Mister-M-alt/FPGA-gPTP/README.md

<!-- SPDX-License-Identifier: CERN-OHL-W-2.0 -->
# FPGA-gPTP

Fabric-native time synchronization for Milan FPGA systems.

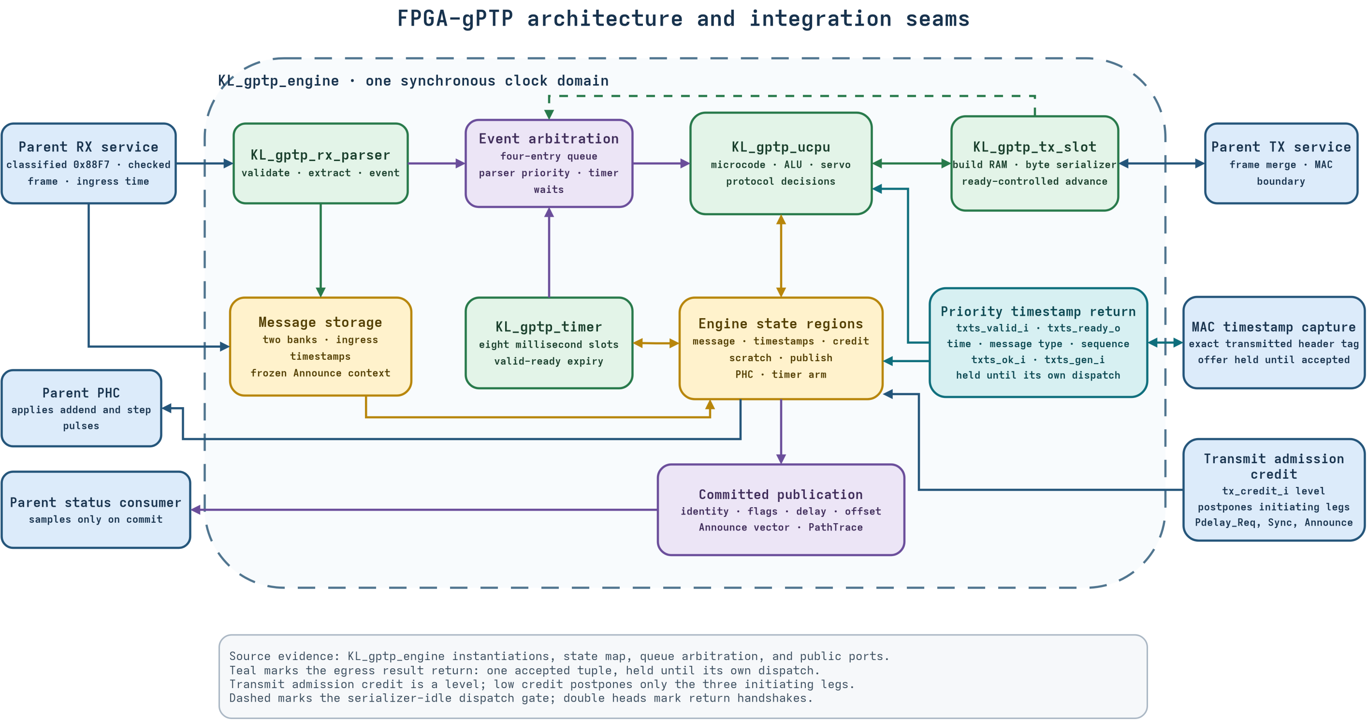
[picture p1: docs/diagrams/gptp_architecture.png]
FPGA-gPTP architecture


The engine keeps protocol work inside programmable logic.

## Choose your view

| Reader | Start here | Main questions |
|---|---|---|
| Manager | [Manager guide](docs/MANAGER.md) | Value, readiness, evidence, risks |
| System integrator | [Integration guide](docs/INTEGRATION.md) | Ports, clocks, resets, ownership |
| HDL contributor | [HDL developer guide](docs/HDL_DEVELOPER.md) | Modules, state, timing, invariants |
| Test developer | [Test developer guide](docs/TEST_DEVELOPER.md) | Python, C, C++, suites, failures |

## Current shape

- Parent `GPTP_PLANE_EN_P` [defaults on](https://github.com/kebag-logic/milan-fpga/blob/ac2c5e77bba1c0ae20ce2f69f711a1d17ead94a5/hdl/milan/milan_datapath.sv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).
- [Fabric gPTP](https://github.com/kebag-logic/milan-fpga/blob/ac2c5e77bba1c0ae20ce2f69f711a1d17ead94a5/docs/design/GPTP_PLANE.md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) owns product time synchronization.
- The disabled mode supports [verification-only comparison builds only](https://github.com/kebag-logic/milan-fpga/blob/ac2c5e77bba1c0ae20ce2f69f711a1d17ead94a5/docs/design/GPTP_PLANE.md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).
- One synchronous clock domain carries all processing.
- RX consumes validated, preclassified gPTP frames.
- TX honors downstream byte-level backpressure.
- Microcode owns protocol decisions and servo arithmetic.
- RTL owns parsing, queues, timers, and serialization.
- Egress timestamp results arrive on accepted beats.
- Admission credit postpones only initiating transmissions.
- Publication outputs expose committed protocol state.

Parent evidence is pinned at `ac2c5e77`.

The [integration guide](docs/INTEGRATION.md#option-off-behavior) details option-off behavior.

## Verify quickly

```sh
make
make docs
make diagrams-check
```

Each command returns nonzero after failures.

Detailed commands appear in the [test guide](docs/TEST_DEVELOPER.md).

## Known risks

- [Issue #58](https://github.com/Mister-M-alt/FPGA-gPTP/issues/58) remains open: asymmetry, calibration, and live tuning.
- [Parent #117](https://github.com/kebag-logic/milan-fpga/issues/117) still owes physical acceptance against the reference peer.
- [Parent #64](https://github.com/kebag-logic/milan-fpga/issues/64) and [#488](https://github.com/kebag-logic/milan-fpga/issues/488) still owe physical timestamp calibration.

The [manager guide](docs/MANAGER.md#open-risks) separates donor and product gaps.

No certification claim is made.

## Documentation

- [Documentation map](docs/README.md)
- [Source evidence](docs/SOURCE_EVIDENCE.md)
- [Architecture diagram source](docs/diagrams/gptp_architecture.drawio)
- [Diagram generation](docs/diagrams/README.md)
- [Historical records](docs/history/v1/README.md)

Current guides describe the present implementation.

Historical pages preserve dated engineering evidence.
