Mister-M-alt/FPGA-gPTP/docs/HDL_DEVELOPER.md

<!-- SPDX-License-Identifier: CERN-OHL-W-2.0 -->
# HDL developer guide

This guide explains structure, timing, and invariants.

## Summary

- Five RTL modules share one clock under `KL_gptp_engine`.
- Microcode decides protocol policy; RTL moves bytes and time.
- The microCPU reaches engine state through seven address regions.
- Scratch survives warm reset; validity bits do not.
- Sample on `pub_commit_o`; staging writes change outputs first.
- Synthesis figures here are dated measurements.

Terms are defined in the [glossary](GLOSSARY.md).

FPGA-gPTP architecture

The editable source remains [available](diagrams/gptp_architecture.drawio).

## Module map

| Module | Responsibility |
|---|---|
| `KL_gptp_engine` | Integration, queues, state, arbitration |
| `KL_gptp_rx_parser` | Byte parsing and message banking |
| `KL_gptp_ucpu` | Microcode execution and arithmetic |
| `KL_gptp_tx_slot` | Frame construction and serialization |
| `KL_gptp_timer` | Eight millisecond deadline slots |
| `gptp_ucpu_pkg` | Opcodes, constants, event identifiers |

All modules use one clock domain.

## Receive path

The parser accepts one byte each valid cycle.

It validates headers before dispatching events.

Follow_Up TLVs are walked up to messageLength.

Unknown TLVs are skipped by their length.

The first information TLV supplies word 11.

A malformed chain still refuses the Follow_Up.

A receive error on any byte refuses its frame.

Accepted data enters ping-pong message banks.

Ingress timestamps follow the same bank selection.

Announce uses one frozen context.

Chasing Announces become counted drops.

Other event types may continue.

### Receive timing

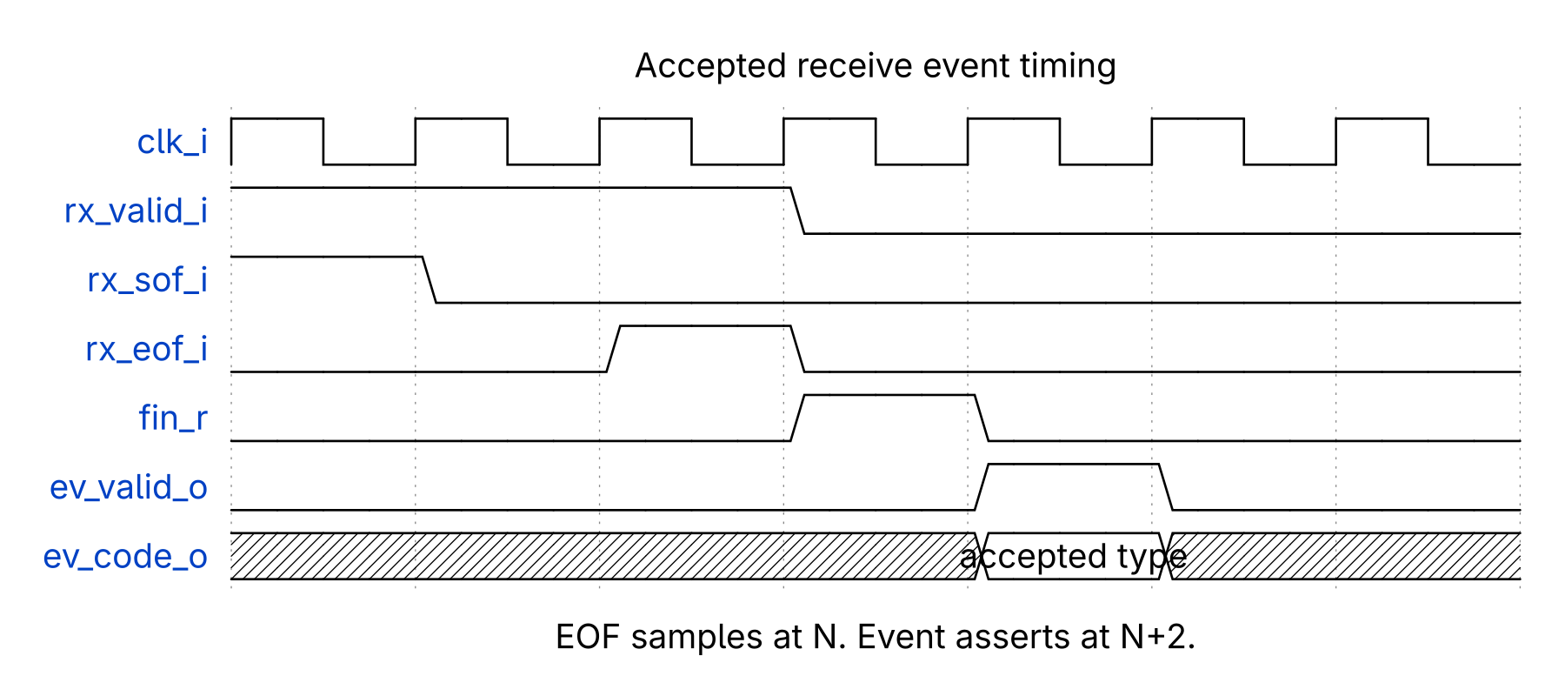
[picture p2: docs/diagrams/wavedrom/rx_accept.png]
Accepted receive event timing


EOF stores the final parser decision.

Finalization occupies the next cycle.

The accepted event follows finalization.

[WaveDrom source](diagrams/wavedrom/rx_accept.json) defines this timing.

## Event arbitration

- Four entries buffer parser and timer events.
- Parser events win simultaneous queue pushes.
- Timer expiry waits using valid-ready flow control.
- Timestamp results use a priority side path.
- Dispatch waits until serialization becomes idle.
- Later requests wait behind response ownership.

Never bypass ownership without preserving context.

## Egress result ownership

One result is accepted per valid-ready beat.

Its value, tag, outcome and generation latch together.

Readiness falls until that result dispatches.

A later offer therefore waits at its producer.

Backpressure can never replace an earlier result.

The dispatched word carries outcome and generation.

Both ride above the masked claim comparison.

## Retained pairing context

A peer answer can precede our own transmit time.

The completed pair then waits for that time.

Its identity and measurements stay in scratch.

A later response cannot rewrite the waiting pair.

Responder bookkeeping still counts every matching response.

Only the waiting pair's own arrival releases it.

Reset-backed validity guards both retained pairing cells.

A measured zero remains a valid time.

## State regions

The microCPU uses `st_addr_o[19:16]` for selection.

| Region | Access | Contents |
|---:|---|---|
| 0 | Read-only | Ping-pong message banks |
| 1 | Read-only | Ingress time, egress time, credit |
| 2 | Read-write | Sixty-four protocol scratch words |
| 3 | Read-write | Publication staging bank; word 15 reads thisClock |
| 4 | Read-write | PHC controls and policy completion qualifier |
| 5 | Write-only | Timer arming interface |
| 6 | Read-only | Follow_Up information TLV values (#100) |

Scratch storage survives warm resets.

Resettable claim-valid bits do not survive.

Pairing validity bits do not survive either.

Nor do the three best-record validity bits.

An unwritten best cell reads as the worst possible vector.

The PHC slew qualifier also resets independently.

Microcode writes its remaining completion pairs through PHC word 2.

Nonzero decisions immediately assert `phc_slew_active_o`.

A zero decision clears it with the next rate write.

PHC word 3 retires an active correction during mastership.

Publication flags also control qualification through an RTL-owned hook.

Region 3, word 2 writes trigger this hook.

Bit 2 means asCapable; bit 3 means sync-ok.

Mastership sets bit 3 beside bit 1.

Either cleared bit reloads two completion pairs while active.

The hook preserves the active level and applied rate.

While inactive, these writes must leave qualification unarmed.

A falling bit 2 also expires timer slot 2 now.

That slot runs the Announce receipt leg.

Preserve this coupling when changing either region or flag.

Microcode bit 0 means only that a peer is elected.

The output also sets bit 0 for a grandmaster-capable thisClock.

ROM word [`ROM_CID_HI_C`](INTEGRATION.md#protocol-constants), bit [`ROM_GMCAP_BIT_C`](INTEGRATION.md#protocol-constants), marks that capability.

Microcode reads of word 2 return the unmodified bits.

## MicroCPU shape

- ROM contains [`DEPTH`](INTEGRATION.md#protocol-constants) forty-eight-bit words.
- Its last two words hold thisClock as data.
- Bit `ROM_GMCAP_BIT_C` of word `ROM_CID_HI_C` marks grandmaster capability.
- Register storage contains sixteen sixty-four-bit words.
- Integer logic supports common sixty-four-bit operations.
- Shifts run serially.
- Signed multiplication uses inferred DSP resources.
- Unsigned division runs serially.
- Dispatch preloads event and timestamp registers.
- Multi-cycle operations hold execution safely.

Protocol rates tolerate serial arithmetic.

## Transmit timing

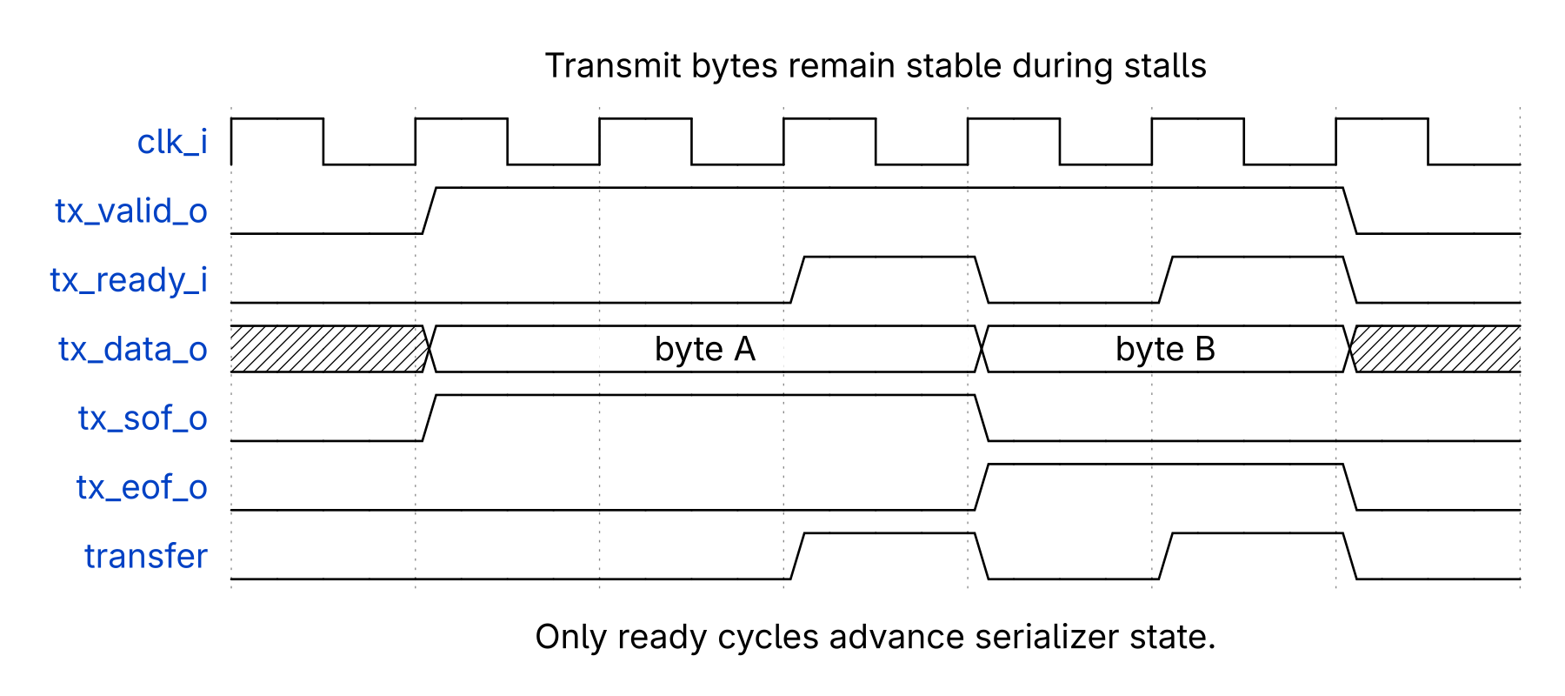
[picture p3: docs/diagrams/wavedrom/tx_backpressure.png]
Transmit backpressure timing


Valid remains asserted during stalls.

Data and markers remain stable during stalls.

State advances only after ready acceptance.

A disabled port withdraws a frame before its first acceptance.

[WaveDrom source](diagrams/wavedrom/tx_backpressure.json) defines this timing.

## Microcode receipt state

Values here come from the [protocol constants](INTEGRATION.md#protocol-constants).

Timer slot 4 is the [`SYNC_RTO_MS_C`](INTEGRATION.md#protocol-constants) Sync receipt watch.

Every usable Sync pair restarts it, in either role.

Adopting a new grandmaster starts it as well.

BECOME stops neither the Sync nor the Follow_Up watch.

Every expiry marks the port aged in scratch word 46.

It then ages an elected peer through BECGATE.

That needs the peer's grandmaster priority1 below 255.

Otherwise the expiry clears sync-ok, except in the master role.

The mark is `SRTO_PASSED_C`, a priority threshold.

It compares priority1 and the top three clockClass bits.

Its lowest bit is sync-ok's.

The presence bit times the mark is the leg's threshold.

An unaged expiry clears that threshold from the flags.

`MASK` does that: rd and not rb.

So a master, with threshold zero, keeps sync-ok.

The leg then ends in PDPAIR's flags write, `PUBFLAGS`.

An aged port ages each Announce below that threshold.

That is a grandmaster priority1 below 255, so gmPresent.

BECGATE then keeps or makes this plane master.

Other Announces compete as usual.

A usable pair or an asCapable rise clears that mark.

A master's usable pair only restarts the watch.

Scratch word 45 holds the pending Sync's source.

Scratch word 6 stays the master's Sync sequence.

Each Pdelay beat judges the previous request first.

An uncompleted interval adds one lost response.

Consecutive loss [`LOST_CLEARS_AT_C`](INTEGRATION.md#protocol-constants) clears asCapable.

PDPAIR first compares t4 less t1 with [`PD_LATE_NS_C`](INTEGRATION.md#protocol-constants).

A later pair ends there, with `S_PDGOT` still clear.

So it counts as lost, and moves nothing (#100).

Scratch word 39 adds each matching response's armed sequence.

A second response therefore leaves no pairable value.

Its exchange counts as lost at the next beat.

## Announce receipt watch

Timer slot 2 is the announce receipt watch.

The engine mirrors it: armed, and its deadline.

The timer only raises the alarm, never earlier.

An Announce handler's nonzero arm is rescaled (#100).

It becomes `ANN_RTO_MS_C` times 2^logMessageInterval.

It counts from that Announce's last octet.

Every other arm keeps its delta from the arm.

A queued expiry whose watch is not due is dropped.

An Announce arriving at or after the deadline waits.

The expiry dispatches ahead of it, from the head.

Each dispatched expiry consumes its watch.

Without that, a master's expiry would wedge dispatch.

An Announce before the deadline always precedes its expiry.

Its event follows its last octet by two clocks.

An expiry needs four clocks after the tick.

## Follow_Up TLV values

BECOME's PHC word-3 write marks each new mastership.

It increments the sixteen-bit gmTimeBaseIndicator.

That counter has no warm-reset assignment.

It also captures the frequency change, through one multiply.

That change is the kept trim less word 3's estimate.

An active slew applies word 3: the change is zero.

Before any rate write since reset, it is zero.

Publish word 4 writes keep the offset's upper half.

Region 6 serves gmTimeBaseIndicator, lastGmPhaseChange as ScaledNs.

It also serves scaledLastGmFreqChange, scaled by 2^41.

## Port enable

`port_en_r` registers `port_enabled_i` once.

Every port gate reads that registered level.

Region 1, word 2 then reads no credit.

`cancel_i` withdraws a frame whose first byte waits.

A SEND issued while disabled is withdrawn the same way.

The serializer masks valid in that same cycle.

A started frame runs on until its last byte.

Both claim-valid bits clear on every disabled cycle.

That write wins over microcode in the same cycle.

`port_ref_r` makes the first sample after release the reference.

Only a later change of level is an edge.

Each edge raises the slot 6 NOTEN event.

NOTEN dispatches ahead of the result and the queue.

It does not wait for an idle serializer.

Its leg must therefore never build or SEND.

A rise also queues a slot 0 beat.

That beat waits behind parser and timer events.

Slot 6 is the NOTEN leg, not a timer.

NOTEN clears the cease, countdown, streak and ladder.

It zeroes `S_RSPSEQ`, so no Follow_Up pairs.

It sets `S_PDGOT`, so the next beat counts no loss.

`S_PDGOT` also refuses a new response arm.

A pair frozen for its t1 finds no claim.

Its tail clears the interval and drops asCapable.

The cease entry now ends in that tail.

## Publication invariant

Microcode stages publication values first.

`OP_COMMIT` marks the staged tuple complete.

Staging writes reach the `pub_*_o` outputs at once.

Consumers sample only during `pub_commit_o`.

Inactive path entries must remain zero.

Reset loads thisClock and the path {thisClock}.

The engine reads thisClock from the image at configuration.

Publication word 15 serves that value to microcode.

The engine commits the reset state on its first edge.

No handler can run before that commit.

Region 3, word 7 stages a taken Announce's path.

It copies a present path from its received head.

That write appends thisClock, even to an empty path.

The appended entry uses the same image words.

Eight received entries leave it no slot.

Without a path trace TLV, the write changes nothing.

Message word 12 bit 63 marks that TLV present.

Microcode's loop test reads only bits 39 to 8.

## Out-of-context measurement

`make ooc` synthesizes both tops out of context.

Each script first reads `syn/ooc/ooc_clock.xdc`.

That file defines the 10 ns `clk_i` clock.

Synthesis therefore optimizes against that period.

`syn/ooc/check_ooc_clock.py` fails runs that break this order.

It checks both scripts before Vivado starts.

Afterwards it checks each log and timing report.

The log must parse this repository's XDC inside synthesis.

Neither log may carry a critical warning.

Each timing report must show `clk` at 10 ns.

Its `report_clocks` section must bind `clk` to `clk_i`.

No register may lack a clock.

Measured at main `5dce647a` on 2026-10-11:

| Top | Flow | LUTs | Registers | BRAM tiles | DSPs | WNS |
|---|---|---:|---:|---:|---:|---:|
| `KL_gptp_engine` | Constrained | 4,852 | 3,652 | 1.5 | 4 | +1.773 ns |
| `KL_gptp_engine` | Unconstrained | 4,853 | 3,652 | 1.5 | 4 | +1.773 ns |
| `KL_gptp_ucpu` | Constrained | 1,643 | 733 | 1.5 | 4 | +1.941 ns |
| `KL_gptp_ucpu` | Unconstrained | 1,643 | 733 | 1.5 | 4 | +1.941 ns |

Both flows used Vivado 2026.1 and `xc7a100tfgg484-2`.

Both used `-mode out_of_context` and the default directive.

Constrained runs read the clock before `synth_design`.

Unconstrained runs created it after `synth_design`.

Unconstrained slack is only a post-synthesis report.

This repository's `syn/ooc` figures before #70 were unconstrained.

No placement or routing runs here.

## Change checklist

- Preserve single-clock assumptions.
- Preserve valid-ready transfer rules.
- Preserve bank and timestamp pairing.
- Preserve event ownership snapshots.
- Preserve reset-validity separation.
- Preserve accepted-result immutability.
- Preserve message scope on every cancellation.
- Gate only the three initiating legs.
- Update microcode and tests together.
- Add negative and boundary tests.
- Update both WaveDrom sources when timing changes.
- Update Draw.io after structural changes.
- Regenerate every committed diagram.
- Keep the OOC clock ahead of synthesis.
- Run lint and complete simulations.
