Mister-M-alt/FPGA-gPTP/docs/TEST_DEVELOPER.md

<!-- SPDX-License-Identifier: CERN-OHL-W-2.0 -->
# Test developer guide

This guide explains every verification layer.

## Summary

- `make` runs every local gate and returns nonzero on failure.
- Six simulation suites cover arithmetic, parsing, protocol and transport.
- Mutation arms plant defects that the suites must catch.
- Documentation gates check style, links, status and generated values.

Terms are defined in the [glossary](GLOSSARY.md).

## Language layers

| Layer | Files | Purpose |
|---|---|---|
| Python | `hdl/ucode/gen_gptp_ucode.py` | Generates configuration-specific ROM images |
| Python | `tb/check_phc_contract.py` | Guards the PHC and result boundaries |
| Python | `tb/verilator/*/mutants.py` | Plants defects that suites must catch |
| Python | `tb/mutation_verdict.py` | Reads each mutant's verdict from suite output |
| Python | `tb/mutation_jobs_test.py` | Compares serial and concurrent engine mutation output |
| Python | `tb/tsngen/run_tsngen.py` | Cross-checks frames against independent protocol decoders |
| Python | `scripts/check_docs.py` | Checks documentation rules and generated values |
| Python | `scripts/check_docs_selftest.py` | Plants documentation defects the docs gate must catch |
| C | None | No first-party C harness exists |
| C++ | `tb/verilator/*/sim_main.cpp` | Drives and checks Verilated RTL |
| C++ | `bench/arty/bench_mii_tx_tag_test.cpp` | Checks timestamp-tag transport |
| Make | Repository Makefiles | Builds, runs, and cleans suites |

Verilator converts SystemVerilog into C++ models.

Handwritten C++ drives those generated models.

Python generates ROM data and structural checks.

No handwritten C harness exists.

## Test entry points

| Command | Coverage |
|---|---|
| `make contract` | PHC boundary source contract |
| `make -C tb/verilator/ucpu` | Arithmetic and microCPU behavior |
| `make -C tb/verilator/parser` | Frame parsing and refusal paths |
| `make -C tb/verilator/engine` | Whole-plane protocol behavior |
| `make -C tb/verilator/engine mutants` | Engine mutation controls |
| `make -C tb/verilator/engine mutants-jobs-test` | Engine mutation output at one and four jobs |
| `make -C tb/verilator/parser mutants` | Parser receive-error, PathTrace and TLV-walk mutation controls |
| `make -C tb/verilator/gaskets` | Bench MII gasket loopback and its mutation controls |
| `make -C tb/tsngen` | Independent frame decode; skips without its checkout |
| `make -C bench/arty test` | MII timestamp-tag transport |
| `make lint` | Engine and bench lint |
| `make docs` | Documentation, status, constants and diagram gates |
| `make` | Every required local gate |

Bare `make` in parser, engine, gaskets and tsngen adds mutants.

The engine arm runs up to eight mutants at once.

Its `--jobs` option sets that number.

One job keeps the serial order.

Verdicts always print in mutant list order.

Clean runs return zero.

Each simulation prints its check tally.

## Python workflow

The generator writes hexadecimal microcode images.

Configuration inputs include these values:

- Station MAC address.
- Announced priority one.
- Engine clock frequency.
- Cease-rule duration.
- Announced clockAccuracy.
- Optional regression sequence seeds.

Regression seeds exercise unreachable runtime counters quickly.

The PHC contract checks removed and surviving tokens.

It fails after stale interfaces return.

## C++ harness workflow

Each harness follows this loop:

1. Construct the Verilated top-level model.
2. Toggle the clock around `eval()` calls.
3. Apply synchronous reset.
4. Drive only public DUT inputs.
5. Sample outputs after clock edges.
6. Compare against independent expectations.
7. Count every check and failure.
8. Return nonzero after any failure.

Never mirror implementation logic blindly.

Prefer independent protocol formulas and frame builders.

## Suite responsibilities

### MicroCPU suite

- Uses an independent arithmetic model.
- Exercises directed boundaries and random vectors.
- Covers shifts, multiplication, and division.
- Writes results through the state interface.

### Parser suite

- Builds wire frames byte-by-byte.
- Checks bank writes and emitted events.
- Covers valid, malformed, truncated, and padded frames.
- Exercises error and domain refusal paths.
- Raises receive errors at every byte position.
- Counts bank writes before, on, and after errors.
- Proves refused frames leave no stale words.
- Proves those error checks through planted defects.
- Accepts PathTrace counts other than stepsRemoved plus one.
- Accepts empty paths and heads other than the grandmaster.
- Reports a present TLV apart from its count.
- Finds the Follow_Up information TLV behind unknown TLVs.
- Accepts a chain ending on a header at messageLength.
- Refuses missing, overrunning, odd and cut Follow_Up TLVs.
- Refuses malformed headers ahead of an information TLV.
- Refuses an information TLV whose lengthField is not 28.
- Proves each acceptance and refusal through a planted defect.
- Plants thirty-four parser defects, nineteen for the TLV walk.

### Engine suite

Values here come from the [protocol constants](INTEGRATION.md#protocol-constants).

- Models a scripted protocol peer.
- Runs shipping and seeded ROM images.
- Checks Pdelay, Announce, Sync, and servo behavior.
- Proves the link-up and locked step thresholds.
- Keeps the lock across timeouts, failovers and mastership.
- Keeps every written addend inside [`RATE_PPM_C`](INTEGRATION.md#protocol-constants).
- Checks slew decisions, completion, and held intervals.
- Checks reset, lost capability, missing Sync, steps, and mastership.
- Grades every cycle from cold release to the first beat.
- Commits thisClock and {thisClock} once, at every reset release.
- Keeps a retained best record out of post-reset selection.
- Hands both to a winning peer and back after silence.
- Drops a peer whose port loses asCapable.
- Grades gmPresent in every self publication.
- Reruns those phases from a priority1 255 image.
- Regains mastership without Announces after capability returns.
- Publishes sync-ok in every master cycle.
- Keeps it through a receipt timeout queued behind mastership.
- Ages a grandmaster when its Sync stops or turns unusable.
- Times each takeover against the [`SYNC_RTO_MS_C`](INTEGRATION.md#protocol-constants) Sync watch.
- Ages a grandmaster that never sends usable Sync.
- Holds mastership while the aged peer keeps announcing.
- Re-elects that peer once, after its Sync recovers.
- Drives Sync every 250 ms, Follow_Up 60 ms after.
- Proves those stimulus pairs stay usable.
- Ages again when Sync lapses after one master-heard pair.
- Ages on expiries found in the master role.
- Keeps a pending Sync's Follow_Up watch across the takeover.
- Never ages a priority1 255 grandmaster on Sync.
- Clears sync-ok when that grandmaster's Sync stops.
- Keeps asCapable through losses short of [`LOST_CLEARS_AT_C`](INTEGRATION.md#protocol-constants).
- Clears asCapable at that loss, in each loss shape.
- Resets an exchange answered by duplicate responses.
- Ends the multiple-responder cease on a port toggle.
- Sends one request at once after each rise.
- Clears asCapable at once on link loss.
- Sends and commits nothing while the port is disabled.
- Drops a frame built across the fall.
- Keeps the cease countdown exit unchanged.
- Withdraws a frame stalled at its first byte.
- Completes a frame stalled after its first byte.
- Clears asCapable at once behind a stalled byte face.
- Pairs no Follow_Up or late t1 across the fall.
- Ends a cease retained across a disabled warm reset.
- Clears sync-ok on every handover to a peer.
- Appends thisClock to direct and multi-hop received paths.
- Checks the seven-entry, eight-entry, empty and absent path boundaries.
- Defers to better grandmasters whatever their path count or head.
- Publishes the received head at entry 0.
- Keeps the previous path when no TLV arrives.
- Removes each Announce disqualification in its own mutant.
- Ends every committed peer path with thisClock.
- Rejects tied-low and early-clear slew indications.
- Keeps in-band tracking inactive after idle timeouts and GM changes.
- Keeps in-band returns from mastership inactive.
- Rejects idle qualification and retained mastership qualification mutants.
- Exercises reset, backpressure, ordering, and timeouts.
- Reorders and withholds timestamp results.
- Holds every result offer until acceptance.
- Sweeps result separations while dispatch stays blocked.
- Drives explicitly lost results of each claimed type.
- Delays a complete Pdelay pair past successor traffic.
- Withholds transmit credit at every initiating leg.
- Sweeps every transmitted flags word by message type.
- Pairs received frames differing only in ignored flag bits.
- Grades each mastership's Follow_Up information TLV (#100).
- Times the Announce watch from the received interval.
- Ages the port at the Announce timeout instant.
- Covers the forced expiry, the queued one and stale ones.
- Counts Pdelay responses past the late bound as lost.
- Keeps asCapable through responses exactly at that bound.
- Grades clockAccuracy in every Announce, in both images.
- Proves its own checks through planted defects.

### Bench-tag suite

- Exercises two independent timestamp tags.
- Checks MII completion transport.

## Adding a test

- Name the requirement or defect first.
- Choose the lowest useful test layer.
- Drive the real public interface.
- Include a positive control.
- Include negative and boundary cases.
- Prove the test fails after mutation.
- Restore production code before committing.
- Record only reproducible evidence.

## Failure triage

- Read the first failed invariant.
- Confirm the generated image matches configuration.
- Check handshake advancement carefully.
- Check reset timing and retained state.
- Check sequence and message-type tags together.
- Reproduce using one focused suite.
- Run the complete gate afterward.

Historical mutation details remain [archived](history/v1/README.md).
