Mister-M-alt/FPGA-gPTP/docs/history/v1/README.md

<!-- SPDX-License-Identifier: CERN-OHL-W-2.0 -->
# Version one history

These records describe completed engineering campaigns.

They never define current behavior.

## Reading rules

- Treat every measurement as date-specific.
- Follow current successors before implementation.
- Preserve commit references for reproducibility.
- Never restore obsolete conclusions automatically.

## Archived pages

| Historical page | Original path | Archived | Current successor |
|---|---|---|---|
| [Project status](PROJECT_STATUS.md) | `README.md` | 2026-08-31 | [Current README](../../../README.md) |
| [Resource validation](RESOURCE_VALIDATION.md) | `docs/RESOURCE_VALIDATION.md` | 2026-08-31 | [Manager guide](../../MANAGER.md) |
| [First-light bench](BENCH_FIRSTLIGHT.md) | `docs/BENCH_FIRSTLIGHT.md` | 2026-08-31 | [Manager guide](../../MANAGER.md) |
| [Grandmaster bench](BENCH_GRANDMASTER.md) | `docs/BENCH_GRANDMASTER.md` | 2026-08-31 | [Manager guide](../../MANAGER.md) |
| [Engine test record](testing/ENGINE_TEST_RECORD.md) | `tb/verilator/engine/README.md` | 2026-08-31 | [Test guide](../../TEST_DEVELOPER.md) |
| [Parser test record](testing/PARSER_TEST_RECORD.md) | `tb/verilator/parser/README.md` | 2026-08-31 | [Test guide](../../TEST_DEVELOPER.md) |
| [MicroCPU test record](testing/UCPU_TEST_RECORD.md) | `tb/verilator/ucpu/README.md` | 2026-08-31 | [Test guide](../../TEST_DEVELOPER.md) |
| [Resource deltas](RESOURCE_DELTAS_2026_10.md) | `docs/MANAGER.md` | 2026-10-30 | [HDL guide](../../HDL_DEVELOPER.md#out-of-context-measurement) |

## Prototype line

The pre-rebuild development line, tag `prototype-line`, archived whole.

These pages describe the single-bank ucode v4/v5 engine.

Their rendered diagrams live beside them under `prototype/diagrams/`.

| Historical page | Original path | Archived | Current successor |
|---|---|---|---|
| [Architecture (prototype)](prototype/ARCHITECTURE.md) | `docs/ARCHITECTURE.md` | 2026-09-01 | [HDL guide](../../HDL_DEVELOPER.md) |
| [IP design book](prototype/IP_BLOCKS.md) | `docs/IP_BLOCKS.md` | 2026-09-01 | [HDL guide](../../HDL_DEVELOPER.md) |
| [FSM conformance audit](prototype/FSM_CONFORMANCE.md) | `docs/FSM_CONFORMANCE.md` | 2026-09-01 | [Source evidence](../../SOURCE_EVIDENCE.md) |
| [Verification record](prototype/VERIFICATION.md) | `docs/VERIFICATION.md` | 2026-09-01 | [Test guide](../../TEST_DEVELOPER.md) |
| [Management interface](prototype/MGMT_INTERFACE.md) | `docs/MGMT_INTERFACE.md` | 2026-09-01 | [Integration guide](../../INTEGRATION.md) |
| [Integration guide (prototype)](prototype/INTEGRATION_GUIDE.md) | `docs/INTEGRATION_GUIDE.md` | 2026-09-01 | [Integration guide](../../INTEGRATION.md) |
| [Resource validation (prototype)](prototype/RESOURCE_VALIDATION.md) | `docs/RESOURCE_VALIDATION.md` | 2026-09-01 | [Manager guide](../../MANAGER.md) |
| [Bench operations](prototype/BENCH_OPERATIONS.md) | `docs/BENCH_OPERATIONS.md` | 2026-09-01 | [Manager guide](../../MANAGER.md) |
| [asCapable bench](prototype/BENCH_ASCAPABLE.md) | `docs/BENCH_ASCAPABLE.md` | 2026-09-01 | [Manager guide](../../MANAGER.md) |
| [TAP wire truth](prototype/BENCH_TAP_WIRETRUTH.md) | `docs/BENCH_TAP_WIRETRUTH.md` | 2026-09-01 | [Manager guide](../../MANAGER.md) |

Archive total: 18 Markdown pages.
