Mister-M-alt/FPGA-gPTP/docs/history/v1/PROJECT_STATUS.md

[OBSOLETE + 2026-08-31]

> Status: Historical
>
> Original path: `README.md`
>
> Archived: 2026-08-31
>
> Current successor: [current project guide](../../../README.md)

<!-- SPDX-License-Identifier: CERN-OHL-W-2.0 -->
# gptp-processor — the 802.1AS time-sync plane

The gPTP sibling of the `protocol-processor` submodule: a micro-coded
engine consumed by `milan-fpga` as its `gptp-processor` submodule through
`hdl/ieee8021as/gptp_plane/KL_gptp_shadow.sv`, option-gated by the
`milan_datapath` parameter `GPTP_PLANE_EN_P` (RTL default off; the shipping
AX7101 configuration opts in with `board.features.fabric_gptp: true`). With
the option on it owns the retired controller duties on the soft
core -- BTCA, Announce, Sync/Follow_Up, both Pdelay roles, the PHC servo, and
the publication surface (GM identity, asCapable, sync verdict, peer delay) --
as one clock domain of fabric, byte in / byte out. The CSR readback words and
the retired host services stay external until parent issue #116 lands.

**Status: the state machines are landing as µcode revisions.** The round
that created this repo (2026-08-14) priced the plane on the ship part;
everything structural (the grown-ISA µCPU, the 802.1AS receive parser,
the TX build slot, the timer service, the engine region map) is real and
verified. Since then the ROM has grown through bench-proven revisions:
v2 both Pdelay roles + announce adopt, v3 grandmaster capability (BTCA
two-node subset, Announce with path trace, two-step Sync + Follow_Up,
bilateral BMCA interop with third-party silicon on the bench), v4 the
asCapable ladder, the sync/Follow_Up receipt timeouts and
neighborRateRatio with the Milan v1.2 Table 4.1/4.2 profile numbers,
mutation-proven in the engine suite, and v5 the PHC servo: observe-only
is retired. Offsets beyond 20 us (the legacy step threshold
default) re-base the clock in one adjtime write per the GM-loss DLL
policy, smaller ones drive a clock-aware PI addend (kp 3/4, ki 1/4 of
the normalized gain: critically damped), and the engine suite proves
lock closed-loop against a +140 ppm master, and v6 the full-compare
round: BTCA against a stored best vector (parent updates, stepsRemoved
and sourcePortIdentity tie-breaks, immediate takeover on parent
degradation), Sync/Follow_Up sequence-and-source pairing, asCapable
gating sync consumption, and the paired Follow_Up preciseOriginTimestamp
carrying the live egress stamp, and v7 the cease-rule round -- the
deliberate end of the zero-RTL era: the engine gains a SECOND message
bank (each accepted frame lands in the bank its event names, retiring
the torn-read window) and a 64-word scratch, and the Milan 4.2.6.2.5
multiple-responder cease rule lands on that room (three multi-identity
intervals stop Pdelay_Req, a 5-minute timer resumes, duplicates from
one identity are not a storm), and the parent's field campaign then
found the receive side ignoring domainNumber (#6): the parser refuses
any domain but 0 at the header byte, ahead of every bank write, so no
handler can see a foreign-domain frame (-15 LUT: the domain byte of
bank word 0 became the constant the parser admits), then its two
transmit-side findings, the Table 11-7 control field per message type
(#9: Sync 0x0, Follow_Up 0x2, Announce and the three Pdelay messages
0x5) and the ten reserved zero bytes of the two-step Sync body (#10: the
live egress time rides only in the Follow_Up's preciseOriginTimestamp),
both ROM-only, and accepting a
Follow_Up without the mandatory information TLV (#11): the parser now
requires the 76-octet message of Table 11-9, refuses a short
messageLength ahead of every bank write and the wrong TLV header
(11.4.4.3) ahead of the event, so a TLV-less or truncated Follow_Up
no longer reaches the servo (+34 LUT for the two compares, the
redundant per-type minimum flag retired), and a header-only Pdelay_Req
drawing a Pdelay_Resp (#12): the request's minimum is the 54 octets of
Table 11-11, one line of the same per-type table, so a truncated
request is refused ahead of the responder, and then the announce
handler admitting every well-formed Announce (#7): 802.1AS-2011
10.3.10.2.1 qualifyAnnounce now runs ahead of BTCA and of every write
the handler makes (our own clockIdentity as the source, stepsRemoved 255
and above, a pathSequence whose first identity is not the announced
grandmaster, or our identity anywhere in the complete received path).
An otherwise-valid fixed 64-octet Announce may omit PathTrace: the absent case
distinguished by 10.3.10.2.1(d) and 10.3.13.2.1(f) publishes an honest raw
count zero with zero tails. Per IEEE 1588-2008 5.3.8/14.1 and 802.1AS-2011
10.5.1, a bounded generic walker skips each complete even-length unknown TLV,
including a zero-length value, and attempts the next TLV. The complete suffix
must end on a TLV boundary inside the declared messageLength; partial headers,
odd or overflowing lengths, physical truncation and duplicate PathTrace TLVs
are refused. A single PathTrace requires a physically complete 8N-byte value
with N = stepsRemoved + 1. Physical Ethernet padding is ignored, and every
wire identity is checked for a loop even beyond the eight retained entries.
Source, vector, grandmaster, steps, full count, loop verdict and the first
eight hops freeze in one serial-read Announce context from accepted enqueue
through handler END.
While that context is owned, chasing Announces are explicitly dropped and
counted; the first Announce after release is accepted normally. A backlog or
repeated 16-bit sequence therefore cannot splice parser-bank epochs. Its
streaming loop verdict removes the old bounded indexed walk, and then one
unsolicited
Pdelay_Resp_Follow_Up poisoning
neighborPropDelay and dropping asCapable (#8): both Pdelay receive
handlers now pair per 802.1AS-2011 11.2.15.3, a Pdelay_Resp taken only
for the outstanding request's sequenceId and never again once its
exchange has completed, a Follow_Up only behind that Pdelay_Resp and
from its sender (+32 ROM words, zero LUT). Nothing of #6 through #12
remains open, nor do #23, #26, #27 or #28. Every returning egress
timestamp now carries `{messageType, sequenceId}` from the parent's MAC
boundary and is credited only to the claim carrying that exact pair.
Equal counters at two identical endpoints no longer alias Pdelay and
Sync frames, and stamped Announce/Follow_Up frames that deliberately
leave no claim cannot clear another transmitter's claim. A refusal is
also counted once per refused frame, so a one-byte runt in the cycle a
dropped frame finalizes is no longer lost.

This round also closes the three lifetime failures exposed when the parent
put those complete tags under production backpressure. A later peer request
waits at the event-queue head while the first response owns its claim and
requester context. Each accepted Pdelay_Req snapshots the source identity,
port and ingress stamp its handler consumes beside that event, so two valid
Signaling chasers can reuse both live message banks without erasing the held
request. The returning timestamp has a priority dispatch path, so it releases
the first owner before the later request runs (#40).
The serializer now has directed start, middle, one-cycle and long ready-low
coverage (#33). Resettable validity beside the two reset-surviving scratch
claim words makes an orphaned request, response or Sync invisible after warm
reset, while the Milan cease countdown still persists; the hardware bootstrap
re-arms both Pdelay cadence and the Announce receipt watch so master Sync
cadence can recover autonomously (#41). Finally, the free-running Sync counter
is bounded to its 16-bit wire field before it forms a claim (#39).

The donor issues still open at this commit are review findings on pre-existing
behaviour: #31 (the engine holds one egress timestamp and samples it at
dispatch, so a second stamp arriving first destroys it) and #35 (a
mid-frame `rx_err_i` is ignored). #30 and its parent-side duplicate #36 close
with this round: the requestingPortIdentity gate now carries Figure 11-8's
portNumber term on the Pdelay_Resp and on the Follow_Up path, and both
directions of the gate are pinned by probes rather than only its positive
one. The issue tracker remains the authority.
Verification here is ucpu 768 / parser 268 / engine 664 checks in the shipping,
high-request and high-Sync images, every planted engine mutation red,
and lint clean. The ROM is 932 of 1,024 words: the parser's complete-path
loop verdict retires the serial indexed qualification walk while the selected
path stage remains atomic; one word bounds the Sync sequence counter before its
type-qualified claim, and eight compare the whole
requestingPortIdentity. The timer program remains
191 of 192 words in the shipping image and 192 of 192 in each seeded image.
See `docs/RESOURCE_VALIDATION.md` for the measurement record.

**Parent status:** parent `dev` at the #227 merge (`cb444a09`) pins donor
`7def718e`. The #228 repair must advance that pin together with the new
`pub_path_count_o` / `pub_path_o` shadow and datapath wiring; the donor commit
alone does not create a default-fabric GET_AS_PATH producer. Parent #116 owns
that default-on publication transition; #117 still owns physical
two-board and silicon acceptance. The parent's page of record is
`docs/design/GPTP_PLANE.md`.

## Why a µCPU with an ALU

The AECP µCPU (measured 1,070 LUT / 3 RAMB36) deliberately has no
arithmetic — AEM is data shuffling. gPTP is 64-bit timestamp subtraction,
scaled-ns correction fields, a rate-ratio division and a servo multiply,
all at ≤ 8 Hz with millisecond deadlines (Milan relaxes the Pdelay
turnaround to 15 ms). One shared serial ALU walked by µcode is the
area-minimal shape for that; `KL_gptp_ucpu` is therefore a PURE SUPERSET
of the AECP µCPU — every base port and decode arm kept — plus:

| op | what |
|---|---|
| `OP_ALU` | 64-bit ADD/SUB/AND/OR/XOR single-cycle; SHL/SHR/SAR serial, one bit per cycle |
| `OP_MULDIV` | MULS signed 32×32→64 (DSP-inferred); DIVU restoring 64/32→64, one bit per cycle |

so its OOC delta against the 1,070-LUT anchor prices the ISA growth alone.

## Tree

| path | what |
|---|---|
| `hdl/ucpu/` | `gptp_ucpu_pkg.sv` (µISA), `KL_gptp_ucpu.sv` |
| `hdl/wire/` | `KL_gptp_rx_parser.sv` (802.1AS byte parse → message bank), `KL_gptp_tx_slot.sv` (build slot + serializer) |
| `hdl/common/` | `KL_gptp_timer.sv` (ms deadline service, 8 slots) |
| `hdl/top/` | `KL_gptp_engine.sv` (parser + µCPU + slot + timer + region map + publish wires) |
| `hdl/ucode/` | `gen_gptp_ucode.py` — ROM image generator (entry table mirrored by the engine) |
| `tb/verilator/ucpu/` | arithmetic battery vs an independent C++ model (mutation-proven) |
| `tb/verilator/parser/` | 802.1AS field extraction + drop arms (mutation-proven) |
| `tb/verilator/engine/` | whole-plane round-trip vs a scripted peer + spec-formula pdelay model (mutation-proven) |
| `syn/ooc/` | the measurement instrument + `docs/RESOURCE_VALIDATION.md`'s numbers |

## Run everything

```sh
make            # all three Verilator suites (exit 0 = PASS)
make lint       # verilator --lint-only on the engine top
syn/ooc/run.sh  # Vivado 2026.1 OOC measurement into syn/ooc/work/
```

## Implemented integration contract (parent: milan-fpga)

What `KL_gptp_shadow` wires to `KL_gptp_engine` when `GPTP_PLANE_EN_P` is
set. With it clear the control lane passes straight through, the PHC knobs
constant-fold to the CSR face and the publish words read zero, so every
other build is bit-identical.

- RX: an input-only tap on the MAC RX AXIS stream (a beat is real when
  `tvalid && tready`) classifies EtherType 0x88F7 at the aligned lanes into
  a frame FIFO (frame mode; bad and oversize frames dropped, drops counted)
  and serializes each delivered frame to the engine at 1 byte/clk, DA first.
  The ingress timestamp is latched at the frame's first tap beat, pushed
  into a side FIFO on the frame FIFO's commit pulse (once per delivered
  frame; the shed rule of parent #122 keeps it from lapping a live stamp)
  and popped at sof. The engine's `rx_err_i` is tied low: the frame FIFO
  never delivers a bad frame.
- TX: the engine's byte stream gears up to one wide, frame-held lane that
  joins the control TX after the min-IFG gasket through its own staggered
  merge (`adp_tx_arbiter`, diagnostics lane 4); `KL_gptp_txstamp` watches
  the true MAC boundary, armed by the lane's sof, and returns {timestamp,
  messageType, sequenceId} on `txts_*`. The engine packs that complete
  tag into its event and credits only the exact transmitter claim; an
  unclaimed Announce or Follow_Up stamp cannot consume another frame's
  timestamp.
- PHC: the engine's adjfine pulse is latched to a level in the shadow and its
  adjtime passes through, both onto the `timestamp_counter` knobs in place of
  the retired control writes; settime stays with the CSR face (boot sets
  the epoch). Ingress and egress timestamps enter through their event-specific
  interfaces; the engine has no free-running nanosecond-counter input.
- Publish bank out: GM identity, parent identity, flags (present, gm,
  asCapable, sync), peer delay, offset, `pub_annq`, and the raw selected
  PathTrace leave the engine beside its commit pulse. For a present
  PathTrace, raw count is the complete received length including the separate
  GM output; a fixed or unknown-only Announce without the TLV publishes raw
  count zero and seven zero tails while GM remains separately valid. A fabric
  consumer must preserve that empty received path; only the parent's legacy
  software-staging mode retains its historical GM-only alias. The donor ABI is
  deliberately
  bounded to eight entries: a deeper valid received
  sequence is checked in full for loops, then publishes its first eight and
  count eight, matching the parent GET_AS_PATH ceiling rather than exposing
  parser-stale or unretained suffix bytes. BTCA stages this record
  only on `take`, so a worse current Announce may re-commit but cannot replace
  the retained best path.
- ROM: the parent's builder generates the per-configuration 1,024-word
  image from this repo's `hdl/ucode/gen_gptp_ucode.py` (`--mac`, `--p1`,
  `--clk-hz` from the station YAML) and passes its path as
  `GPTP_UCODE_HEX_P`; the parent tracks no image of its own, and its CI
  fetches this submodule for the RTL and documentation gates.

## Measured record

See `docs/RESOURCE_VALIDATION.md`. Every number in it is a Vivado 2026.1
out-of-context post-synthesis figure on `xc7a100tfgg484-2` at 100 MHz —
the same instrument as every anchor in the protocol-processor's
`10_RESOURCE_AND_EFFORT.md`, whose OOC-vs-real-SoC calibration was
accurate to one LUT.
