Mister-M-alt/FPGA-gPTP/bench/arty/arty.xdc

# SPDX-FileCopyrightText: 2026 Kebag Logic
# SPDX-License-Identifier: CERN-OHL-W-2.0
# Digilent Arty A7-100T — FPGA-gPTP first-light bench

set_property -dict {PACKAGE_PIN E3 IOSTANDARD LVCMOS33} [get_ports clk100_i]
set_property -dict {PACKAGE_PIN C2 IOSTANDARD LVCMOS33} [get_ports cpu_reset_n]

set_property -dict {PACKAGE_PIN D10 IOSTANDARD LVCMOS33} [get_ports uart_tx_o]

set_property -dict {PACKAGE_PIN H5  IOSTANDARD LVCMOS33} [get_ports {led_o[0]}]
set_property -dict {PACKAGE_PIN J5  IOSTANDARD LVCMOS33} [get_ports {led_o[1]}]
set_property -dict {PACKAGE_PIN T9  IOSTANDARD LVCMOS33} [get_ports {led_o[2]}]
set_property -dict {PACKAGE_PIN T10 IOSTANDARD LVCMOS33} [get_ports {led_o[3]}]

set_property -dict {PACKAGE_PIN G18 IOSTANDARD LVCMOS33} [get_ports eth_ref_clk_o]
set_property -dict {PACKAGE_PIN C16 IOSTANDARD LVCMOS33} [get_ports eth_rst_n_o]
set_property -dict {PACKAGE_PIN F15 IOSTANDARD LVCMOS33} [get_ports eth_rx_clk_i]
set_property -dict {PACKAGE_PIN G16 IOSTANDARD LVCMOS33} [get_ports eth_rx_dv_i]
set_property -dict {PACKAGE_PIN C17 IOSTANDARD LVCMOS33} [get_ports eth_rx_er_i]
set_property -dict {PACKAGE_PIN D18 IOSTANDARD LVCMOS33} [get_ports {eth_rxd_i[0]}]
set_property -dict {PACKAGE_PIN E17 IOSTANDARD LVCMOS33} [get_ports {eth_rxd_i[1]}]
set_property -dict {PACKAGE_PIN E18 IOSTANDARD LVCMOS33} [get_ports {eth_rxd_i[2]}]
set_property -dict {PACKAGE_PIN G17 IOSTANDARD LVCMOS33} [get_ports {eth_rxd_i[3]}]
set_property -dict {PACKAGE_PIN H16 IOSTANDARD LVCMOS33} [get_ports eth_tx_clk_i]
set_property -dict {PACKAGE_PIN H15 IOSTANDARD LVCMOS33} [get_ports eth_tx_en_o]
set_property -dict {PACKAGE_PIN H14 IOSTANDARD LVCMOS33} [get_ports {eth_txd_o[0]}]
set_property -dict {PACKAGE_PIN J14 IOSTANDARD LVCMOS33} [get_ports {eth_txd_o[1]}]
set_property -dict {PACKAGE_PIN J13 IOSTANDARD LVCMOS33} [get_ports {eth_txd_o[2]}]
set_property -dict {PACKAGE_PIN H17 IOSTANDARD LVCMOS33} [get_ports {eth_txd_o[3]}]

create_clock -period 10.000 -name sys_clk [get_ports clk100_i]
create_clock -period 40.000 -name mii_rx  [get_ports eth_rx_clk_i]
create_clock -period 40.000 -name mii_tx  [get_ports eth_tx_clk_i]

set_clock_groups -asynchronous \
  -group [get_clocks sys_clk] \
  -group [get_clocks mii_rx] \
  -group [get_clocks mii_tx]

set_property CLOCK_DEDICATED_ROUTE FALSE [get_nets -of [get_ports eth_rx_clk_i]]
set_property CLOCK_DEDICATED_ROUTE FALSE [get_nets -of [get_ports eth_tx_clk_i]]

set_property CFGBVS VCCO [current_design]
set_property CONFIG_VOLTAGE 3.3 [current_design]
