Mister-M-alt/FPGA-gPTP/tb/verilator/engine/mutants.py

#!/usr/bin/env python3
# SPDX-FileCopyrightText: 2026 Kebag Logic
# SPDX-License-Identifier: CERN-OHL-W-2.0
"""Mutation arm for the engine suite: prove its checks are load-bearing.

Why this exists. `sim_main.cpp` grades the whole plane through its wire and
publish faces, and the arms that repair FPGA-gPTP #31 - the accepted-beat
result face, the message-scoped lost arm, the retained Pdelay pairing
context and the three admission gates - are exactly the kind of behaviour a
harness can appear to check without checking. A suite whose assertions never
fail is indistinguishable from a suite that asserts nothing, and the defect
this round repairs was invisible to a green suite for that reason.

So the real engine RTL and the real micro-code generator are mutated, one
defect at a time, and the SAME harness is run against each mutant. Every
mutant must make it FAIL. The unmutated build must still PASS, without which
the arm would be satisfied by a harness that fails on everything.

"Caught" means the harness's own tally says so; see tb/mutation_verdict.py
for why a non-zero exit alone is not a catch. Everything is staged into a
temporary directory, so nothing is written into the tree.

Cost note, recorded rather than hidden: micro-code mutants reuse one build of
the unmutated RTL, because a generator change moves only the ROM image the
simulation reads at start-up. RTL mutants are built individually. Since
#104 each build compiles through ccache when it is on PATH, unless
OBJCACHE says otherwise (`compiler_env`): the Verilator runtime and the
harness are the same C++ in every build, and a mutant's model is the same
in every run, so only a model not built before is compiled again.

Each harness run is single-threaded, so since #102 `--jobs N` runs N
mutants at once. The default is the number of CPUs this process may use,
at most JOBS_CAP; `--jobs 1` runs them one after another, in list order.
Concurrency changes no verdict and no output: each mutant stages, builds
and runs in its own temporary directory, and its lines are printed in list
order once it and every mutant before it have finished.

What this arm deliberately does NOT list, recorded rather than hidden,
because the value of a mutation arm is also the map of what it cannot reach.
Removing the reset-backed read gate on the pending-pair cell alone survives
every check, and that survival is a property of the design rather than a gap
in the harness: the cell is read in only two places, and a new Pdelay_Req
clears it at its commit point before any post-reset timestamp result can
match a claim. The gate is kept because it is the second half of a stated
rule that pairs it with the t1 validity beside it, whose own removal IS
caught below; it is defence in depth with no reachable arm, not a checked
behaviour. Closing that would need a reachable state, not another mutant.

The lapse hook's asCapable term is also defence in depth. Removing only
that term survives: Sync pairs cannot be consumed while incapable, and
the fall's leg drops the elected peer by writing the whole flags word
zero, sync-ok included, before capability can recover through two good
Pdelay exchanges at 1 s cadence (since #89 the Sync receipt watch ages a
slave instead). Mastership retires the qualifier itself. This is a
reachability argument from the current policy, not an executed proof;
revisit it if the timer or capability recovery rules change.

A commit pairing count zero with a nonzero entry has no arm either. No
legitimate path is empty since #87 (an absent TLV keeps the previous
pathTrace), and the engine's own simulation assertion stops the run on
that pairing, so such a mutant aborts before any check can grade it, and
an abort is not a catch. The empty-sequence mutant below publishes count
zero with every entry zero, which the assertion admits and the checks
catch.

A mutant is one (pattern, replacement) pair, or, with the replacement None,
a list of pairs applied to the same file. The pathTrace controls (#85, #87,
#88) are in path_mutants.py, the three PathTrace refusals #88 retired among
them, which are the parser arm's own edits, so both suites plant one defect.
"""

from __future__ import annotations

import argparse
import contextlib
import os
import shutil
import subprocess
import sys
import tempfile
from collections.abc import Callable, Iterator
from concurrent.futures import ThreadPoolExecutor
from pathlib import Path

HERE = Path(__file__).resolve().parent
HDL = (HERE / "../../../hdl").resolve()
sys.path.insert(0, str((HERE / "../../").resolve()))

from mutation_verdict import TALLY, verdict  # noqa: E402

sys.path.insert(0, str(HERE))
from receipt_mutants import GENERATOR, RECEIPT_MUTATIONS  # noqa: E402
from port_mutants import PORT_MUTATIONS  # noqa: E402
from p100_mutants import P100_MUTATIONS  # noqa: E402
from path_mutants import PATH_MUTATIONS  # noqa: E402

#: the RTL the suite builds, in the order the Makefile lists it
RTL_SOURCES = (
    "ucpu/gptp_ucpu_pkg.sv",
    "ucpu/KL_gptp_ucpu.sv",
    "wire/KL_gptp_rx_parser.sv",
    "wire/KL_gptp_tx_slot.sv",
    "common/KL_gptp_timer.sv",
    "top/KL_gptp_engine.sv",
)
#: the shipping arguments of this suite's image, as tb/verilator/engine/Makefile
GENARGS = ("--clk-hz", "2000000", "--cease-ms", "3000")
#: the Makefile's fourth pass (#82): a priority1 of 255 and, since #100, a
#: clockAccuracy of 0xFE. Its checks print with this prefix, naming the pass
P1_GENARGS = ("--p1", "255", "--clock-accuracy", "0xFE")
P1_PLUSARG = "+not-gm-capable"
P1_PREFIX = "p1 255 "

VFLAGS = [
    "--cc", "--exe", "--build", "-j", "4", "--top-module", "KL_gptp_engine",
    "-Wall", "-Wno-fatal", "-Wno-DECLFILENAME", "-Wno-UNUSEDSIGNAL",
    "-Wno-WIDTHEXPAND", "-Wno-WIDTHTRUNC", "-Wno-UNUSEDPARAM",
    "-GUCODE_HEX_P=\"gptp_ucode.hex\"", "-GCLK_HZ_P=2000000",
]

#: #102: the --jobs default never exceeds this many concurrent mutants
JOBS_CAP = 8


#: (name, file under hdl/, pattern, replacement, the property it should
#: break); a replacement of None makes the pattern a list of pairs
MUTATIONS = [
    # ---- #75: the policy level must cover the entire affected interval ----
    ("slew level tied low", "top/KL_gptp_engine.sv",
     "      // gather: atomic millisecond snapshot",
     "      phc_slew_active_o <= 1'b0; // injected tied-low output\n"
     "      // gather: atomic millisecond snapshot",
     "slew: policy decision starts at +101 ns"),
    ("slew clears at the first in-band pair", GENERATOR,
     "    p.emit(\"MOVE\", rd=RB, ra=0, imm=3)                       # reload, then -1",
     "    p.emit(\"MOVE\", rd=RB, ra=0, imm=2)                       # early completion",
     "slew: first in-band pair cannot clear"),
    # #89: nothing is in band, so no pair after a Sync lapse completes
    ("the tracking band is empty", GENERATOR,
     "    p.emit(\"CMP\", ra=RW, rb=0, fmt=FMT_D, imm=2 * SLEW_SETTLED_NS_C + 1)\n",
     "    p.emit(\"CMP\", ra=RW, rb=0, fmt=FMT_D, imm=0)\n",
     "slew: second return pair stays inactive"),
    ("slew clears before the replacement rate", "top/KL_gptp_engine.sv",
     "                if (st_wdata_w[1:0] != 2'd0)\n"
     "                  phc_slew_active_o <= 1'b1;",
     "                phc_slew_active_o <= (st_wdata_w[1:0] != 2'd0);",
     "slew: no clear precedes the replacement rate"),
    ("slew idle lapse arms qualification", "top/KL_gptp_engine.sv",
     "                if (phc_slew_active_o &&\n",
     "                if (1'b1 &&\n",
     "slew: in-band pair after idle timeout stays inactive"),
    ("slew idle asCapable loss arms qualification", "top/KL_gptp_engine.sv",
     "                if (phc_slew_active_o &&\n"
     "                    (!st_wdata_w[2] || !st_wdata_w[3]))\n",
     "                if ((phc_slew_active_o && !st_wdata_w[3]) ||\n"
     "                    !st_wdata_w[2])\n",
     "slew: in-band pair after asCapable recovery stays inactive"),
    ("slew mastership keeps qualification", "top/KL_gptp_engine.sv",
     "                phc_slew_left_r   <= 2'd0;\n"
     "                phc_slew_active_o <= 1'b0;\n",
     "                phc_slew_active_o <= 1'b0;\n",
     "slew: in-band return from GM stays inactive"),
    # ---- the result face: acceptance, and what acceptance protects -------
    ("result face always ready", "top/KL_gptp_engine.sv",
     "assign txts_ready_o  = !txts_pend_r && rst_n;",
     "assign txts_ready_o  = 1'b1;",
     "a result already owed to the micro-code cannot be replaced by a "
     "later one"),
    ("result value taken without an accepted beat", "top/KL_gptp_engine.sv",
     "if (txts_accept_w)          txts_r <= txts_ns_i;",
     "if (txts_valid_i)          txts_r <= txts_ns_i;",
     "the accepted result keeps its own timestamp until its dispatch"),
    ("result tag taken without an accepted beat", "top/KL_gptp_engine.sv",
     "if (txts_accept_w) begin",
     "if (txts_valid_i) begin",
     "the accepted result keeps its own tag and outcome until its dispatch"),
    # ---- reset-backed validity of the pairing cells ----------------------
    ("recorded t1 survives reset", "top/KL_gptp_engine.sv",
     "        else if ((st_addr_w[5:0] == 6'd37) && !t1v_valid_r)\n"
     "          st_rd_mux_w = 64'd0;\n",
     "",
     "a t1 measured before a reset cannot pair with a later Follow_Up"),
    # ---- the byte face, which decides how many frames were sent ----------
    ("byte face advances without ready", "wire/KL_gptp_tx_slot.sv",
     "      end else if (tx_ready_i) begin",
     "      end else begin",
     "a stalled byte, including the final one, waits for an accepted "
     "transfer"),
    # ---- the lost arm, and its scope -------------------------------------
    ("lost t1 fabricates a time and a companion", GENERATOR,
     "    p.label(\"t1\")\n"
     "    p.emit(\"WRST\", ra=0, imm=RG_SCR | S_TXQ_TMR, fmt=FMT_Q)\n"
     "    p.emit(\"WRST\", ra=0, imm=RG_SCR | S_T1V, fmt=FMT_Q)\n"
     "    p.emit(\"WRST\", ra=0, imm=RG_SCR | S_PDWAIT, fmt=FMT_Q)\n"
     "    p.emit(\"END\")\n",
     "    p.label(\"t1\")\n"
     "    p.emit(\"WRST\", ra=0, imm=RG_SCR | S_TXQ_TMR, fmt=FMT_Q)\n"
     "    p.emit(\"BR\", label=LB[\"TXT1OK\"])\n",
     "a lost result writes no time and completes no exchange"),
    # word-neutral since #89 filled TXLOST's gap: each arm falls into the
    # request arm, cancelling the requester exchange (and the timer claim)
    ("lost Sync cancels the requester exchange", GENERATOR,
     "    p.label(\"sync\")\n"
     "    p.emit(\"WRST\", ra=0, imm=RG_SCR | S_TXQ_TMR, fmt=FMT_Q)\n"
     "    p.emit(\"END\")                      # no SYNCFU: there is no "
     "origin time\n",
     "    p.label(\"sync\")\n"
     "    p.emit(\"WRST\", ra=0, imm=RG_SCR | S_TXQ_TMR, fmt=FMT_Q)\n"
     "    p.emit(\"BR\", label=\"t1\")\n",
     "a lost Sync result retires the Sync claim and nothing else"),
    ("lost response cancels the requester exchange", GENERATOR,
     "    p.label(\"resp\")\n"
     "    p.emit(\"WRST\", ra=0, imm=RG_SCR | S_TXQ_RESP, fmt=FMT_Q)\n"
     "    p.emit(\"END\")                      # no RFU: there is no t3 to "
     "carry\n",
     "    p.label(\"resp\")\n"
     "    p.emit(\"WRST\", ra=0, imm=RG_SCR | S_TXQ_RESP, fmt=FMT_Q)\n"
     "    p.emit(\"BR\", label=\"t1\")\n",
     "a lost Pdelay_Resp result retires the response claim and nothing else"),
    # ---- the retained pairing context -------------------------------------
    ("a later response re-arms the frozen pair", GENERATOR,
     "    p.emit(\"RDST\", rd=RV, imm=RG_SCR | S_PDWAIT, fmt=FMT_Q)\n",
     "    p.emit(\"MOVE\", rd=RV, ra=0, imm=0)\n",
     "a complete pair keeps its own identity and operands until its t1"),
    ("the tail runs before its own t1", GENERATOR,
     "    p.emit(\"RDST\", rd=RT, imm=RG_SCR | S_T1V, fmt=FMT_Q)\n"
     "    p.emit(\"CMP\", ra=RT, rb=0, fmt=FMT_D, imm=1)\n"
     "    p.emit(\"BRS\", cnd=BRS_Z, label=\"t1_here\")\n"
     "    p.emit(\"WRST\", ra=RC, imm=RG_SCR | S_T3, fmt=FMT_Q)\n"
     "    p.emit(\"MOVE\", rd=RT, ra=0, imm=1)\n"
     "    p.emit(\"WRST\", ra=RT, imm=RG_SCR | S_PDWAIT, fmt=FMT_Q)\n"
     "    p.emit(\"END\")\n"
     "    p.label(\"t1_here\")\n",
     "    p.label(\"t1_here\")\n",
     "a delay is computed from this exchange's own t1, never a predecessor's"),
    ("a new request leaves the old pair live", GENERATOR,
     "    p.emit(\"WRST\", ra=0, imm=RG_SCR | S_T1V, fmt=FMT_Q)\n"
     "    p.emit(\"WRST\", ra=0, imm=RG_SCR | S_PDWAIT, fmt=FMT_Q)\n"
     "    p.emit(\"RDST\", rd=RA, imm=RG_SCR | S_MYSEQ, fmt=FMT_Q)\n",
     "    p.emit(\"RDST\", rd=RA, imm=RG_SCR | S_MYSEQ, fmt=FMT_Q)\n",
     "a superseded exchange cannot pair with the new request's t1"),
    # ---- the three admission gates, one arm each --------------------------
    ("credit gate removed from the Pdelay_Req leg", GENERATOR,
     "    e_credit_gate(p, \"beat_off\")\n",
     "",
     "a Pdelay_Req beat is postponed while the transmit path has no credit"),
    ("credit gate removed from the Sync leg", GENERATOR,
     "    e_flag_gate(p, FL_ASCAP_C, FL_ASCAP_C, \"ac\", \"skip\")\n"
     "    e_credit_gate(p, \"skip\")\n"
     "    p.emit(\"RDST\", rd=RB, imm=RG_SCR | S_TXQ_TMR, fmt=FMT_Q)\n",
     "    e_flag_gate(p, FL_ASCAP_C, FL_ASCAP_C, \"ac\", \"skip\")\n"
     "    p.emit(\"RDST\", rd=RB, imm=RG_SCR | S_TXQ_TMR, fmt=FMT_Q)\n",
     "a Sync beat is postponed while the transmit path has no credit"),
    ("credit gate removed from the Announce leg", GENERATOR,
     "    e_flag_gate(p, FL_ASCAP_C, FL_ASCAP_C, \"ac\", \"skip\")\n"
     "    e_credit_gate(p, \"skip\")\n"
     "    p.emit(\"RDST\", rd=RA, imm=RG_SCR | S_ASEQ, fmt=FMT_Q)\n",
     "    e_flag_gate(p, FL_ASCAP_C, FL_ASCAP_C, \"ac\", \"skip\")\n"
     "    p.emit(\"RDST\", rd=RA, imm=RG_SCR | S_ASEQ, fmt=FMT_Q)\n",
     "an Announce beat is postponed while the transmit path has no credit"),
    # ---- the #68 step-versus-slew policy, one arm per rule -----------------
    ("every pair uses the locked threshold", GENERATOR,
     "    p.emit(\"RDST\", rd=RB, imm=RG_SCR | S_LOCK, fmt=FMT_Q)\n",
     "    p.emit(\"MOVE\", rd=RB, ra=0,"
     " imm=STEP_LOCKED_NS_C - STEP_LINKUP_NS_C)\n",
     "a link-up pair steps over 20 us"),
    ("every pair uses the link-up threshold", GENERATOR,
     "    p.emit(\"MOVE\", rd=RT, ra=0,"
     " imm=STEP_LOCKED_NS_C - STEP_LINKUP_NS_C)\n",
     "    p.emit(\"MOVE\", rd=RT, ra=0, imm=0)\n",
     "a locked pair slews up to 100 us"),
    ("exactly the threshold steps", GENERATOR,
     "    p.emit(\"ALU\", rd=RB, ra=RB, rb=0, cnd=ALU_ADD, imm=1)\n"
     "    p.emit(\"MD\", rd=RU, ra=RW, rb=RB, cnd=MD_DIVU)\n",
     "    p.emit(\"ALU\", rd=RB, ra=RB, rb=0, cnd=ALU_ADD, imm=0)\n"
     "    p.emit(\"MD\", rd=RU, ra=RW, rb=RB, cnd=MD_DIVU)\n",
     "an offset of exactly 20 us, or 100 us once locked, slews"),
    ("the step arm is unreachable", GENERATOR,
     "    p.emit(\"BRS\", cnd=BRS_Z, label=\"sv_slew\")\n",
     "    p.emit(\"BR\", label=\"sv_slew\")\n",
     "an offset over the threshold steps"),
    # word-neutral, because the BTCA leg filled its gap when this arm was
    # written and one more word was a packing refusal, not a mutant (#82
    # has since freed words): the unlock takes the slot of the
    # Sync-cadence disarm, which disarms nothing for a plane that is
    # already a slave (18c's), and elsewhere leaves a cadence whose own
    # master gate sends nothing
    ("a grandmaster change unlocks the servo", GENERATOR,
     "    p.emit(\"WRST\", ra=0, imm=RG_TMR | 1, fmt=FMT_Q)        "
     "# sync TX off\n",
     "    p.emit(\"WRST\", ra=0, imm=RG_SCR | S_LOCK, fmt=FMT_Q)\n",
     "the servo stays locked across a grandmaster identity change"),
    # only an asCapable rise re-arms the link-up (the manager's ruling on
    # #68): each of these two re-adds a retired re-arm
    # one word longer, which the ROM still holds (#89)
    ("a receipt timeout unlocks the servo", GENERATOR,
     "    p.emit(\"WRST\", ra=RU, imm=RG_SCR | S_SRTO, fmt=FMT_Q)\n",
     "    p.emit(\"WRST\", ra=RU, imm=RG_SCR | S_SRTO, fmt=FMT_Q)\n"
     "    p.emit(\"WRST\", ra=0, imm=RG_SCR | S_LOCK, fmt=FMT_Q)\n",
     "the servo stays locked across a Sync receipt timeout"),
    ("becoming grandmaster unlocks the servo", GENERATOR,
     "    e_flags(p, andm=FL_ASCAP_C, orm=FL_AMGM_C | FL_SYNCOK_C)\n",
     "    e_flags(p, andm=FL_ASCAP_C, orm=FL_AMGM_C | FL_SYNCOK_C)\n"
     "    p.emit(\"WRST\", ra=0, imm=RG_SCR | S_LOCK, fmt=FMT_Q)\n",
     "the servo stays locked across a return from mastership"),
    ("the locked threshold is 200 us", GENERATOR,
     "    p.emit(\"MOVE\", rd=RT, ra=0,"
     " imm=STEP_LOCKED_NS_C - STEP_LINKUP_NS_C)\n",
     "    p.emit(\"MOVE\", rd=RT, ra=0,"
     " imm=2 * STEP_LOCKED_NS_C - STEP_LINKUP_NS_C)\n",
     "a locked pair steps over 100 us, after a receipt timeout too"),
    ("asCapable's rise keeps the lock", GENERATOR,
     "    p.emit(\"WRST\", ra=0, imm=RG_SCR | S_LOCK, fmt=FMT_Q)"
     "  # rose: link-up\n",
     "",
     "the first pair after asCapable rises, or after a reset, is a link-up"),
    ("the whole trim is not clamped", GENERATOR,
     "    e_sat(p, RT, RUNTIME[\"ilim\"], \"sv_a\")                    "
     "# +-200 ppm\n",
     "",
     "the written trim never leaves +-200 ppm"),
    ("the trim clamp is one unit wider than the envelope", GENERATOR,
     "    e_sat(p, RT, RUNTIME[\"ilim\"], \"sv_a\")",
     "    e_sat(p, RT, RUNTIME[\"ilim\"] + 1, \"sv_a\")",
     "the written trim never leaves the envelope the consumer derives"),
    ("the integrator is not clamped", GENERATOR,
     "    e_sat(p, RC, RUNTIME[\"ilim\"], \"sv_i\")                    "
     "# +-ILIM\n",
     "",
     "the integrator stays within +-200 ppm"),
    # ---- #82: thisClock and {thisClock} unless a live peer is elected ----
    # Each control lists, after "#82 ", every named check it must fail.
    # -- reset publishes the self tuple, and commits it once, at once --
    ("reset leaves the grandmaster zero", "top/KL_gptp_engine.sv",
     "      pub_gm_r        <= rom_clock_id_w;\n",
     "      pub_gm_r        <= '0;\n",
     "#82 cold release: every cycle to the first beat names thisClock"
     " | #82 cold release: every cycle to the first beat has {thisClock}"
     " | #82 cold release: that commit carries thisClock and {thisClock}"
     " | #82 warm reset: it names thisClock, not the elected peer"
     " | pre-init deep Announce: GM stays thisClock"),
    ("reset keeps the elected grandmaster", "top/KL_gptp_engine.sv",
     "      pub_gm_r        <= rom_clock_id_w;\n",
     "",
     "#82 warm reset: it names thisClock, not the elected peer"),
    ("the thisClock words are read swapped", GENERATOR,
     "    for addr, word in ((ROM_CID_HI_C,\n"
     "                        (cid >> 32) | (gm_capable << ROM_GMCAP_BIT_C)),\n"
     "                       (ROM_CID_LO_C, cid & 0xFFFFFFFF)):\n",
     "    for addr, word in ((ROM_CID_LO_C,\n"
     "                        (cid >> 32) | (gm_capable << ROM_GMCAP_BIT_C)),\n"
     "                       (ROM_CID_HI_C, cid & 0xFFFFFFFF)):\n",
     "#82 cold release: every cycle to the first beat names thisClock"
     " | #82 cold release: that commit carries thisClock and {thisClock}"),
    ("reset leaves the path empty", "top/KL_gptp_engine.sv",
     "      pub_path_count_r <= 4'd1;\n"
     "      pub_path_r       <= self_path_w;\n",
     "      pub_path_count_r <= 4'd0;\n"
     "      pub_path_r       <= '0;\n",
     "#82 cold release: every cycle to the first beat has {thisClock}"
     " | #82 cold release: that commit carries thisClock and {thisClock}"
     " | #82 warm reset: its path is {thisClock} with a zero tail"),
    ("reset keeps the elected tail", "top/KL_gptp_engine.sv",
     "      pub_path_count_r <= 4'd1;\n"
     "      pub_path_r       <= self_path_w;\n",
     "      pub_path_count_r <= 4'd1;\n",
     "#82 warm reset: its path is {thisClock} with a zero tail"
     " | #82 every commit naming thisClock carries {thisClock}"),
    ("no engine commit after reset", "top/KL_gptp_engine.sv",
     "  assign pub_commit_o     = ucpu_commit_w || boot_pub_commit_r;",
     "  assign pub_commit_o     = ucpu_commit_w;",
     "#82 cold release: one commit before the first beat"
     " | #82 warm reset: one commit in the first 2 ms"),
    ("the boot commit fires twice", "top/KL_gptp_engine.sv",
     "      boot_pub_commit_r <= boot_pub_pend_r;\n"
     "      boot_pub_pend_r   <= 1'b0;\n",
     "      boot_pub_commit_r <= boot_pub_pend_r;\n"
     "      boot_pub_pend_r   <= boot_pub_pend_r && !boot_pub_commit_r;\n",
     "#82 cold release: one commit before the first beat"
     " | #82 warm reset: one commit in the first 2 ms"),
    ("the boot commit never retires", "top/KL_gptp_engine.sv",
     "      boot_pub_commit_r <= boot_pub_pend_r;\n"
     "      boot_pub_pend_r   <= 1'b0;\n",
     "      boot_pub_commit_r <= boot_pub_pend_r;\n",
     "#82 cold release: one commit before the first beat"),
    ("the boot commit waits for the timer bootstrap", "top/KL_gptp_engine.sv",
     "      boot_pub_commit_r <= boot_pub_pend_r;\n"
     "      boot_pub_pend_r   <= 1'b0;\n",
     "      boot_pub_commit_r <= boot_pub_pend_r && boot_done_r;\n"
     "      boot_pub_pend_r   <= boot_pub_pend_r && !boot_done_r;\n",
     "#82 cold release: that commit is the first edge after release"
     " | #82 warm reset: that commit is the first edge after release"
     " | pre-init deep Announce: no commit"),
    # -- only a newly received Announce competes after a reset --------------
    ("a warm reset keeps the retained best record", "top/KL_gptp_engine.sv",
     "      best_pv_valid_r    <= 1'b0;\n"
     "      best_id_valid_r    <= 1'b0;\n"
     "      best_src_valid_r   <= 1'b0;\n",
     "",
     "#82 warm reset: a worse-than-local peer leaves thisClock"
     " | #82 warm reset: the live worse peer wins, not the absent A"
     " | #82 warm reset: the live peer carries its own path"),
    ("an unwritten best record reads as the best vector",
     "top/KL_gptp_engine.sv",
     "                 ((st_addr_w[5:0] == 6'd20) && !best_src_valid_r))\n"
     "          st_rd_mux_w = '1;\n",
     "                 ((st_addr_w[5:0] == 6'd20) && !best_src_valid_r))\n"
     "          st_rd_mux_w = '0;\n",
     "#82 warm reset: a worse-than-local peer leaves thisClock"
     " | #82 warm reset: the live worse peer wins, not the absent A"),
    # -- a winning peer is published with its own path ----------------------
    ("a winning peer's grandmaster is not published", GENERATOR,
     "    p.emit(\"WRST\", ra=RW, imm=RG_PUB | 0, fmt=FMT_Q)\n",
     "",
     "#82 peer wins: its commit names the peer GM"
     " | #82 warm reset: the live worse peer wins, not the absent A"
     " | #84 the run hands mastership to a peer"
     " | #85 direct grandmaster: elected | #85 multi-hop grandmaster: elected"
     " | #85 seven received entries: elected"
     " | #85 eight received entries: elected | #85 absent path: elected"),
    ("a winning peer's path is not staged", GENERATOR,
     "    p.emit(\"WRST\", ra=0, imm=RG_PUB | 7, fmt=FMT_Q)\n",
     "",
     "#82 peer wins: its commit carries the peer path"
     " | #82 warm reset: the live peer carries its own path"),
    # -- a departed peer returns the self tuple, by either departure --------
    ("the self publication keeps the departed grandmaster", GENERATOR,
     "    p.emit(\"WRST\", ra=RC, imm=RG_PUB | 0, fmt=FMT_Q)\n"
     "    p.emit(\"WRST\", ra=RC, imm=RG_PUB | 1, fmt=FMT_Q)\n",
     "    p.emit(\"WRST\", ra=RC, imm=RG_PUB | 1, fmt=FMT_Q)\n",
     "#82 peer leaves: the mastership commit names thisClock"
     " | #82 Pdelay loss: thisClock is committed within 2 ms of the fall"
     " | #82 Pdelay loss: that mastership names thisClock, {thisClock}"
     " | #85 direct grandmaster: the degraded grandmaster yields"
     " | #85 multi-hop grandmaster: the degraded grandmaster yields"
     " | #85 seven received entries: the degraded grandmaster yields"
     " | #85 eight received entries: the degraded grandmaster yields"
     " | #85 absent path: the degraded grandmaster yields"),
    ("the self publication keeps the departed path", GENERATOR,
     "    p.emit(\"WRST\", ra=RT, imm=RG_PUB | 6, fmt=FMT_Q)",
     "    p.emit(\"WRST\", ra=0, imm=RG_PUB | 6, fmt=FMT_Q)",
     "#82 peer leaves: the mastership commit path is {thisClock}"
     " | #82 Pdelay loss: that commit carries {thisClock}"
     " | #82 Pdelay loss: that mastership names thisClock, {thisClock}"
     " | #82 every commit naming thisClock carries {thisClock}"),
    ("the self publication keeps the departed record", GENERATOR,
     "    p.emit(\"RDST\", rd=RT, imm=RG_SCR | S_MYPV, fmt=FMT_Q)\n"
     "    p.emit(\"WRST\", ra=RT, imm=RG_SCR | S_BESTPV, fmt=FMT_Q)\n"
     "    p.emit(\"WRST\", ra=RC, imm=RG_SCR | S_BESTID, fmt=FMT_Q)\n"
     "    p.emit(\"WRST\", ra=RC, imm=RG_SCR | S_BESTSRC, fmt=FMT_Q)\n",
     "",
     "#82 Pdelay loss: once capable, a live peer worse than D wins"),
    ("an asCapable fall leaves the receipt watch running",
     "top/KL_gptp_engine.sv",
     "                if (pub_flags_r[2] && !st_wdata_w[2]) begin\n"
     "                  tmr_arm_we_w    <= 1'b1;\n"
     "                  tmr_arm_slot_w  <= 3'd2;\n"
     "                  tmr_arm_delta_w <= 32'd1;\n"
     "                end\n",
     "",
     "#82 Pdelay loss: thisClock is committed within 2 ms of the fall"),
    ("an incapable receipt timeout keeps the elected peer", GENERATOR,
     "    p.emit(\"WRST\", ra=0, imm=RG_PUB | 2, fmt=FMT_Q)\n"
     "    p.emit(\"BR\", label=LB[\"SELF\"])\n",
     "",
     "#82 Pdelay loss: thisClock is committed within 2 ms of the fall"
     " | #82 Pdelay loss: that commit carries {thisClock}"
     " | #82 Pdelay loss: Announces from the incapable port elect nothing"),
    ("an incapable port's Announces still compete", GENERATOR,
     "    # 802.1AS: a port that is not asCapable does not enter the contest\n"
     "    e_flag_gate(p, FL_ASCAP_C, FL_ASCAP_C, \"ac\", \"out\")\n",
     "    # 802.1AS: a port that is not asCapable does not enter the contest\n",
     "#82 Pdelay loss: Announces from the incapable port elect nothing"),
    ("the asCapable drop keeps the flags word", GENERATOR,
     "    p.emit(\"WRST\", ra=0, imm=RG_PUB | 2, fmt=FMT_Q)\n"
     "    p.emit(\"BR\", label=LB[\"SELF\"])\n",
     "    p.emit(\"BR\", label=LB[\"SELF\"])\n",
     "#82 Pdelay loss: the drop commit's flags are gmPresent alone"
     " | p1 255 #82 Pdelay loss: the drop commit's flags are gmPresent alone"),
    ("an incapable port's receipt watch is not re-armed", GENERATOR,
     "    p.emit(\"MOVE\", rd=RU, ra=0, imm=3000)\n"
     "    p.emit(\"WRST\", ra=RU, imm=RG_TMR | 2, fmt=FMT_Q)  # keep watching\n",
     "",
     "#82 Pdelay loss: once capable, with no Announce, master in 3 s"
     " | #82 Pdelay loss: that mastership names thisClock, {thisClock}"
     " | p1 255 #82 Pdelay loss: once capable, with no Announce, master in 3 s"),
    # -- every self publication carries gmPresent (10.3.13.2.4 g) ----------
    ("the published flags leave gmPresent to the microcode",
     "top/KL_gptp_engine.sv",
     "  assign pub_flags_o     = {pub_flags_r[31:1],\n"
     "                            pub_flags_r[0] | rom_gm_capable_w};\n",
     "  assign pub_flags_o     = pub_flags_r;\n",
     "#82 cold release: every cycle to the first beat has gmPresent"
     " | #82 cold release: that commit's flags are gmPresent alone"
     " | #82 warm reset: its flags are gmPresent alone"
     " | #82 peer leaves: the mastership commit has gmPresent"
     " | #82 Pdelay loss: the drop commit's flags are gmPresent alone"
     " | #82 Pdelay loss: that mastership commit has gmPresent"),
    ("the image does not mark thisClock grandmaster-capable", GENERATOR,
     "    gm_capable = RUNTIME[\"p1\"] < 255\n",
     "    gm_capable = False\n",
     "#82 cold release: every cycle to the first beat has gmPresent"
     " | #82 cold release: that commit's flags are gmPresent alone"
     " | #82 warm reset: its flags are gmPresent alone"
     " | #82 peer leaves: the mastership commit has gmPresent"
     " | #82 Pdelay loss: the drop commit's flags are gmPresent alone"
     " | #82 Pdelay loss: that mastership commit has gmPresent"),
    ("the capability mark ignores priority1", GENERATOR,
     "    gm_capable = RUNTIME[\"p1\"] < 255\n",
     "    gm_capable = True\n",
     "p1 255 #82 cold release: every cycle to the first beat has gmPresent"
     " | p1 255 #82 cold release: that commit's flags are gmPresent alone"
     " | p1 255 #82 Pdelay loss: the drop commit's flags are gmPresent alone"
     " | p1 255 #82 Pdelay loss: that mastership commit has gmPresent"),
    ("mastership sets the microcode's presence bit", GENERATOR,
     "    e_flags(p, andm=FL_ASCAP_C, orm=FL_AMGM_C | FL_SYNCOK_C)\n",
     "    e_flags(p, andm=FL_ASCAP_C,"
     " orm=FL_PRESENT_C | FL_AMGM_C | FL_SYNCOK_C)\n",
     "p1 255 #82 Pdelay loss: that mastership commit has gmPresent"),
    # ---- #84: the master role is synchronised ----------------------------
    # Each control lists, after "#84 ", every named check it must fail.
    ("becoming grandmaster clears sync-ok", GENERATOR,
     "    e_flags(p, andm=FL_ASCAP_C, orm=FL_AMGM_C | FL_SYNCOK_C)\n",
     "    e_flags(p, andm=FL_ASCAP_C, orm=FL_AMGM_C)\n",
     "#84 first mastership: the master flags carry sync-ok"
     " | #84 takeover: its commit names thisClock with sync-ok"
     " | #84 every master cycle publishes sync-ok"
     " | p1 255 #84 first mastership: the master flags carry sync-ok"
     " | p1 255 #84 every master cycle publishes sync-ok"),
    # word-neutral: the mask is the mark itself, so every expiry that ages
    # nothing clears sync-ok, a master's included
    ("a queued receipt timeout clears a master's sync-ok", GENERATOR,
     "    p.emit(\"MASK\", rd=RT, ra=R0, rb=RV)               # RT & ~RV\n",
     "    p.emit(\"MASK\", rd=RT, ra=R0, rb=RU)               # RT & ~RV\n",
     "#84 takeover: a queued receipt timeout keeps sync-ok"
     " | #84 every master cycle publishes sync-ok"),
    # ---- #89, #90 and #91: receipt_mutants.py -----------------------------
    *RECEIPT_MUTATIONS,
    *PORT_MUTATIONS,                                  # #94: port_mutants.py
    *P100_MUTATIONS,                                  # #100: p100_mutants.py
    ("dispatch ignores a busy serializer", "top/KL_gptp_engine.sv",
     "                 disp_ready_w && ser_idle_w && !disp_valid_r;",
     "                 disp_ready_w && !disp_valid_r;",
     "#84 takeover: nothing commits while dispatch is held"),
    ("mastership never publishes the master bit", GENERATOR,
     "    e_flags(p, andm=FL_ASCAP_C, orm=FL_AMGM_C | FL_SYNCOK_C)\n",
     "    e_flags(p, andm=FL_ASCAP_C, orm=FL_SYNCOK_C)\n",
     "#84 master cycles were graded | p1 255 #84 master cycles were graded"),
    ("a handover to a peer keeps sync-ok", GENERATOR,
     "    e_flags(p, andm=FL_ASCAP_C, orm=FL_PRESENT_C)\n",
     "    e_flags(p, andm=FL_ASCAP_C | FL_SYNCOK_C, orm=FL_PRESENT_C)\n",
     "#84 every handover to a peer grandmaster clears sync-ok"
     " | p1 255 #84 every handover to a peer grandmaster clears sync-ok"),
    *PATH_MUTATIONS,                     # #85, #87 and #88: path_mutants.py
]


def edits_of(pattern: str | list[tuple[str, str]],
             replacement: str | None) -> list[tuple[str, str]]:
    """A mutant's (pattern, replacement) pairs: one pair, or, with the
    replacement None, the list of pairs the pattern holds."""
    return list(pattern) if replacement is None else [(pattern, replacement)]


def stage(work: Path, tag: str,
          mutate: tuple[str, list[tuple[str, str]]] | None = None) -> Path:
    """A directory holding the RTL and the generator, with at most one
    file mutated by its edits. Nothing outside the returned directory is
    written."""
    srcdir = work / f"src_{tag}"
    for name in RTL_SOURCES + (GENERATOR,):
        target = srcdir / name
        target.parent.mkdir(parents=True, exist_ok=True)
        text = (HDL / name).read_text(encoding="utf-8")
        if mutate is not None and mutate[0] == name:
            for pattern, replacement in mutate[1]:
                text = text.replace(pattern, replacement)
        target.write_text(text, encoding="utf-8")
    return srcdir


def generate_image(srcdir: Path, rundir: Path) -> bool:
    """Write the suite's ROM images from `srcdir`'s generator: the shipping
    one in `rundir`, the fourth pass's in `rundir`/p1run. False when the
    generator refuses, which for a packing failure is a real answer."""
    for d, extra in ((rundir, ()), (rundir / "p1run", P1_GENARGS)):
        d.mkdir(parents=True, exist_ok=True)
        out = subprocess.run(
            [sys.executable, str(srcdir / GENERATOR), *GENARGS, *extra,
             "-o", str(d / "gptp_ucode.hex")],
            capture_output=True, text=True)
        if out.returncode != 0 or not (d / "gptp_ucode.hex").is_file():
            return False
    return True


def compiler_env() -> dict[str, str]:
    """#104: the environment a harness build runs in.

    OBJCACHE is verilated.mk's own variable. Unset, it becomes ccache when
    ccache is on PATH, and stays empty, a plain build, otherwise; set, even
    empty, it is used as given, so `OBJCACHE=` builds without a cache.
    CCACHE_NOHASHDIR keeps the build directory out of the cache key. A
    CCACHE_* setting of the caller's own wins.
    """
    env = dict(os.environ)
    env.setdefault("OBJCACHE", "ccache" if shutil.which("ccache") else "")
    env.setdefault("CCACHE_NOHASHDIR", "1")
    return env


def build(srcdir: Path, work: Path, tag: str) -> Path | None:
    """Build the harness against the RTL in `srcdir`; the exe, or None.

    Verilator runs in `srcdir` and is handed the RTL by relative name, so
    the source names it writes into the model name no temporary directory,
    and a model's C++ is the same in every run (#104).
    """
    mdir = work / f"obj_{tag}"
    exe_name = f"Vengine_{tag}"
    out = subprocess.run(
        ["verilator", *VFLAGS, "--Mdir", str(mdir),
         "-CFLAGS", f"-std=c++17 -O2 -I{HERE} -Wall -Wextra",
         *RTL_SOURCES, str(HERE / "sim_main.cpp"), "-o", exe_name],
        cwd=str(srcdir), env=compiler_env(), capture_output=True, text=True)
    exe = mdir / exe_name
    if out.returncode != 0 or not exe.is_file():
        return None
    return exe


def run_harness(exe: Path, rundir: Path) -> tuple[int, str]:
    """(rc, output) of one harness run, reading its image from `rundir`,
    followed by the fourth pass from `rundir`/p1run.

    The two tallies become one, so a failure in either pass is a failure of
    the run. A pass that printed no tally keeps both runs' raw output with
    no tally, and verdict() then names the abort rather than a catch.

    No host deadline: every wait in sim_main.cpp is bounded in DUT cycles and
    reports its own timeout as a failed check, so a mutant that wedges the
    plane still returns a verdict.
    """
    runs = [subprocess.run([str(exe), *arg], cwd=str(d),
                           capture_output=True, text=True)
            for d, arg in ((rundir, ()), (rundir / "p1run", (P1_PLUSARG,)))]
    rc = next((r.returncode for r in runs if r.returncode), 0)
    outs = [r.stdout + r.stderr for r in runs]
    tallies = [TALLY.search(o) for o in outs]
    body = "".join(TALLY.sub("", o) for o in outs)
    if not all(tallies):
        return rc, body
    total = sum(int(m.group(1)) for m in tallies)
    failed = sum(int(m.group(3)) for m in tallies)
    return rc, f"{body}{total} checks: {total - failed} PASS, {failed} FAIL\n"


def _named_failure(failed: list[str], want: str) -> str | None:
    """The first of the `failed` lines that names the check `want`, from the
    pass `want` names: one with the `P1_PREFIX` matches only fourth-pass
    failures, any other name only shipping-pass failures. None if absent."""
    pass_tag = "FAIL " + P1_PREFIX
    mine = want.startswith(P1_PREFIX)
    return next((line for line in failed
                 if want in line
                 and line.startswith(pass_tag) == mine),
                None)


def named_verdict(answer: str, breaks: str, output: str,
                  say: Callable[[str], None] = print) -> str:
    """`answer`, unless a caught control missed a check its `breaks` names.

    Prints the failed line of each named check it finds, through `say`.
    Any other answer, and a control that names no check, is returned
    unchanged.
    """
    # #75 controls must fail their specific behavioral check; an
    # unrelated existing failure cannot stand in for that evidence.
    if breaks.startswith("slew:") and answer == "caught":
        named = [line for line in output.splitlines()
                 if line.startswith("FAIL ") and breaks in line
                 and not line.startswith("FAIL " + P1_PREFIX)]
        if not named:
            answer = "missed its named check"
        else:
            say(named[0])
    # #82, #84, #85, #87 to #91, #94 and #100 controls must fail every
    # check they name, for the same reason: each of those checks needs its
    # own failing defect.
    if breaks.startswith(("#82 ", "#84 ", "#85 ", "#87 ", "#88 ", "#89 ",
                          "#90 ", "#91 ", "#94 ", "#100 ", P1_PREFIX)) and answer == "caught":
        failed = [line for line in output.splitlines()
                  if line.startswith("FAIL ")]
        missed = [want for want in breaks.split(" | ")
                  if _named_failure(failed, want) is None]
        if missed:
            answer = ("missed its named check(s): "
                      + "; ".join(missed))
        else:
            for want in breaks.split(" | "):
                say(_named_failure(failed, want))
    return answer


def run_mutant(work: Path, clean_exe: Path, mutation: tuple,
               say: Callable[[str], None] = print) -> bool:
    """Plant one of the `MUTATIONS` under `work` and print its verdict.

    True when the harness catches it, through every check it names; False,
    with the reason printed, when it survived, did not build, its image was
    refused, or its pattern no longer appears exactly once. Every line goes
    through `say`. The mutant stages, builds and runs in a directory of its
    own under `work`, which no other mutant writes.
    """
    name, fname, pattern, replacement, breaks = mutation
    edits = edits_of(pattern, replacement)
    src = (HDL / fname).read_text(encoding="utf-8")
    for pat, _ in edits:
        if src.count(pat) != 1:
            say(f"[FAIL] mutation {name!r}: its pattern appears "
                f"{src.count(pat)} time(s) in {fname}, expected "
                f"exactly 1. The source moved and this mutant is no "
                f"longer mutating anything - fix the pattern, do not "
                f"delete the arm.")
            return False
    tag = "".join(c if c.isalnum() else "_" for c in name)
    own = Path(tempfile.mkdtemp(prefix="mutant-", dir=work))
    srcdir = stage(own, tag, (fname, edits))
    rundir = own / f"run_{tag}"
    if not generate_image(srcdir, rundir):
        say(f"[FAIL] mutation {name!r}: the generator refused its "
            f"image, so this mutant proves nothing about the "
            f"harness")
        return False
    if fname == GENERATOR:
        exe = clean_exe          # only the ROM image differs
    else:
        exe = build(srcdir, own, tag)
    if exe is None:
        say(f"[FAIL] mutation {name!r} did not build; a mutant that "
            f"cannot build proves nothing about the harness")
        return False
    rc, output = run_harness(exe, rundir)
    answer = named_verdict(verdict(rc, output), breaks, output, say)
    if answer == "caught":
        say(f"[PASS] mutant caught: {name} - breaks \"{breaks}\"")
        return True
    if answer == "pass":
        say(f"[FAIL] mutant SURVIVED: {name}. The harness does not "
            f"prove \"{breaks}\".")
    else:
        say(f"[FAIL] mutant {name!r} {answer}")
    return False


def default_jobs() -> int:
    """The CPUs this process may use, at most `JOBS_CAP`."""
    try:
        usable = len(os.sched_getaffinity(0))
    except AttributeError:       # no affinity call on this platform
        usable = os.cpu_count() or 1
    return max(1, min(JOBS_CAP, usable))


def in_list_order(jobs: int, tasks: list[Callable[[], object]]) -> Iterator[object]:
    """Each task's result, in list order, with `jobs` tasks running at once.

    One job calls the tasks one after another, as before #102. More start
    each task as a worker frees, but yield a result only after every
    earlier one, so the completion order never shows. An interrupt cancels
    the tasks not yet started.
    """
    if jobs == 1:
        for task in tasks:
            yield task()
        return
    pool = ThreadPoolExecutor(max_workers=jobs)
    try:
        futures = [pool.submit(task) for task in tasks]
        for future in futures:
            yield future.result()
    finally:
        pool.shutdown(wait=True, cancel_futures=True)


def jobs_arg(text: str) -> int:
    """A --jobs value: a whole number of at least 1."""
    jobs = int(text)
    if jobs < 1:
        raise argparse.ArgumentTypeError(f"--jobs must be at least 1, not {jobs}")
    return jobs


def main(argv: list[str] | None = None) -> int:
    """Run the control and every mutant, and report the arm's exit status.

    0 when the unmutated sources pass and every mutant is caught; 1 when any
    mutant survived, failed to build, or no longer matches its pattern, each
    printed with the property it was defending.
    """
    parser = argparse.ArgumentParser(description=__doc__.split("\n")[0])
    parser.add_argument(
        "--jobs", type=jobs_arg, default=default_jobs(),
        help=f"mutants run at once (default: the CPUs this process may use, "
             f"at most {JOBS_CAP}); 1 runs them one after another")
    args = parser.parse_args(argv)
    passes = fails = 0
    with tempfile.TemporaryDirectory(prefix="engine-mutants-") as td:
        work = Path(td)

        # -- positive control: the real sources must still pass -------------
        clean_src = stage(work, "clean")
        clean_run = work / "run_clean"
        clean_exe = build(clean_src, work, "clean")
        if clean_exe is None or not generate_image(clean_src, clean_run):
            print("[FAIL] the unmutated sources did not build; every mutant "
                  "result below would be meaningless")
            return 1

        def control() -> str:
            """The verdict of the unmutated build against the harness."""
            return verdict(*run_harness(clean_exe, clean_run))

        def planted(mutation: tuple) -> Callable[[], tuple[bool, list[str]]]:
            """The task that plants `mutation` and grades it."""
            def task() -> tuple[bool, list[str]]:
                """(caught, the lines its verdict prints), printing none."""
                lines: list[str] = []
                return run_mutant(work, clean_exe, mutation, lines.append), lines
            return task

        # The control runs first and each mutant after it, in list order,
        # with --jobs 1; with more, they share the workers, and the lines of
        # each still print in this order. Closing the results waits for any
        # task still running before the directory is removed.
        with contextlib.closing(in_list_order(
                args.jobs, [control, *map(planted, MUTATIONS)])) as results:
            answer = next(results)
            if answer == "pass":
                passes += 1
                print("[PASS] the unmutated engine still passes the harness")
            else:
                fails += 1
                print(f"[FAIL] the unmutated engine does NOT pass ({answer}) "
                      f"- every mutant result below is meaningless")

            # -- each mutant must be caught ----------------------------------
            for caught, lines in results:
                for line in lines:
                    print(line)
                if caught:
                    passes += 1
                else:
                    fails += 1

    total = passes + fails
    print(f"\n{total} checks: {passes} PASS, {fails} FAIL")
    return 1 if fails else 0


if __name__ == "__main__":
    sys.exit(main())
