Mister-M-alt/FPGA-gPTP/tb/verilator/engine/sim_main.cpp

// SPDX-FileCopyrightText: 2026 Kebag Logic
// SPDX-License-Identifier: CERN-OHL-W-2.0
//
// KL_gptp_engine protocol round-trip -- v5, the servo round.
//
//  1..4   pdelay bring-up: byte-exact both roles, asCapable at the
//         second good exchange and not the first (Milan 4.2.6.2.4)
//  1a     a Pdelay_Req sourced from OUR OWN clockIdentity, arriving
//         while the boot request waits for its egress timestamp, draws
//         no frame and cannot steal that timestamp (1588-2008 9.5.2.2,
//         #26)
//  1c     equal-sequence Pdelay_Req/Pdelay_Resp claims are separated by
//         messageType; a stamped unclaimed Resp_FU cannot consume either
//         claim, and the true request stamp still produces 600 ns (#28)
//  3a     a requester differing from us in only one half of its
//         clockIdentity is a neighbour and is still answered, so a
//         compare narrowed to either half goes red (#26)
//  1b     a Follow_Up for the boot request (sequence 0) ahead of any
//         Resp, from the zero identity a never-armed pairing holds, is
//         ignored: "armed with sequence 0" is not "nothing armed" (#8)
//  1d     #82: before any peer the plane is its own grandmaster. Every cycle
//         from cold release to the first timer beat publishes thisClock
//         with the one-entry path {thisClock} and gmPresent, and exactly
//         one commit, on the first clock edge out of reset, carries them
//         with no other flag (802.1AS-2020 10.3.13.2.4 b, g, i)
//  2b     a Pdelay_Resp (and its Follow_Up) sourced from OUR OWN
//         clockIdentity, answering the outstanding request, is ignored:
//         it neither moves the delay nor climbs the ladder (IEEE
//         1588-2008 9.5.2.2, 802.1AS-2011 Figure 11-8, #23)
//  3b     a foreign-domain Pdelay_Req draws no frame and counts one drop;
//         a domain-0 request right after it is answered (8.1, #6)
//  3c     a header-only and a cut Pdelay_Req draw no frame and count one
//         drop each; the complete request after them is answered (#12)
//  3d     an unlisted messageType (0x1, 0xD, 0xF) with a valid header
//         draws no frame at all and counts one drop each, and the flags
//         do not move (Table 11-3's NOTE: not used in this standard, #22)
//  5..9   grandmaster life: timeout become (asCapable-gated), Announce/
//         Sync/Follow_Up byte-exact, BTCA both directions, adoption;
//         phase 7 holds an equal-sequence Sync and Pdelay_Resp, returns
//         the response stamp first, stamps its unclaimed Resp_FU, then
//         proves the Sync still receives its own timestamp (#28)
//  7c     802.1AS-2011 11.4.1/11.4.2.3: the Pdelay flag bits a receiver
//         ignores. Three exchanges differing only in the flags word --
//         0200/0000, the captured 0208/0008, and twoStep flipped -- each
//         compute the same modelled delay, while a cut response, one at a
//         neighbour's requesting clockIdentity and a Follow_Up at a
//         foreign requesting portNumber stay refused while carrying the
//         reserved bit (#64)
//  7b     802.1AS-2011 11.2.15.3: a Pdelay_Resp_Follow_Up pairs with one
//         Pdelay_Resp for the outstanding request only -- before any
//         Resp, with a stale sequenceId, behind a stale Resp (0xEEEE,
//         and the outstanding sequence with its high byte flipped),
//         from another responder, duplicated, or for a superseded
//         request it leaves the delay and asCapable unmoved; the paired
//         one and the next exchange still compute (#8)
//  26b    a completed exchange cannot be completed again: the identical
//         pair replayed is not a second exchange (asCapable holds down),
//         a skewed replay cannot move the delay (Figure 11-8, Cor2) (#8)
//  27b    a second identity answering AFTER the first responder's
//         Follow_Up still counts for the Milan 4.2.6.2.5 cease: the
//         completed exchange's post-completion path reaches the identity
//         bookkeeping (cease, silence, resume, re-earn) (#8)
//  8b     a better Announce in a foreign domain never reaches BTCA: GM,
//         parent, flags and the raw published vector hold (8.1, #6)
//  8c..8m 802.1AS-2011 10.3.10.2.1 qualifyAnnounce: a better Announce
//         from our own clock identity, with stepsRemoved 255 / 0x0100 /
//         0xFFFF, or with our identity in its path trace (second hop,
//         eighth hop, fourth of twelve, FIRST hop of two, the only hop)
//         is refused before any state moves and is not a parser drop;
//         the boundary control (stepsRemoved 254, a one-hop trace
//         without us, in a bank whose upper hop words still hold our
//         identity) and two half-identity controls (source and first
//         hop differing from ours in one 32-bit half) adopt, and a
//         degrade hands mastership back each time (#7). It opens with
//         a), b) and c) on paths whose count is not stepsRemoved+1 (#88).
//         A TLV-less control keeps the [thisClock] mastership left (#87)
// 8n      #85: a slave port publishes the received pathSequence with
//         thisClock appended (802.1AS-2011 10.3.10.2.1 d): a directly
//         attached grandmaster [GM] publishes [GM, thisClock], a
//         four-bridge path publishes its five entries and thisClock, seven
//         entries put thisClock in the last of the eight entries, eight or
//         more publish their first eight, an empty TLV publishes
//         [thisClock] (#88), and an absent TLV keeps the [thisClock]
//         mastership left (#87)
// 8o      #88: a better grandmaster whose path count is not stepsRemoved+1
//         (a NOTE to 802.1AS-2011 10.5.3.3.4), or whose path is not headed
//         by it, is elected, and its path is published as received from
//         entry 0 with thisClock appended, and every degraded grandmaster
//         yields. The issue's two shapes are phase 43
// 8p      #87: without a path trace TLV, pathTrace keeps its previous value
//         (802.1AS-2011 10.3.10.2.1 d): a better grandmaster G2 without a
//         TLV keeps G1's path, with G1 at entry 0; from the parent an empty
//         TLV publishes [thisClock] and a path headed elsewhere publishes
//         that head at entry 0
// 10..12  slave sync path: offset, sync-ok verdict, the 125 ms
//         Follow_Up and 375 ms sync receipt timeouts (Table 4.2); the
//         first pair after asCapable, a link-up about 1 ms off, steps (#68).
//         #89: with the grandmaster still announcing, the receipt timeout
//         ages it and this plane is grandmaster within 375 ms and one BMCA
//         pass of the last usable pair (802.1AS-2011 10.3.11, Cor1)
// 11b     a Sync/Follow_Up pair in a foreign domain never steers: the
//         offset, the PHC writes and the flags hold, and the foreign
//         Sync leaves no pending slot for a domain-0 Follow_Up (#6)
// 11c     a Follow_Up without its information TLV never steers and does
//         not consume the pending Sync; the complete one pairs (#11)
// 11d     a Sync padded to the 60-byte Ethernet minimum, and one padded
//         to 74, still pair
// 11e     three Sync/Follow_Up pairs differing only in their flags word
//         -- 0200/0000, 0208/0008 and twoStep flipped -- pair, steer and
//         re-base the PHC alike (Table 11-4 ignored on reception, #64)
// 12b     #68: a receipt timeout keeps the servo locked: the same
//         grandmaster, re-elected once its Sync is heard again, 50 us off
//         slews, and after a second timeout 150 us off steps once
// 13..15  the servo under the #68 policy. At link-up (after asCapable
//         falls and rises) +-15 us slews and +-25 us steps once, +-20 us
//         slews and +-(20 us + 1 ns) steps; once locked +-90 us slews and
//         +-110 us steps once, +-100 us slews and +-(100 us + 1 ns) steps;
//         the PI addend against an exact-integer mirror; closed-loop lock
//         on a +140 ppm master (one re-base carrying the surviving
//         integrator)
// 15b     #68: that master jumps +-90 us while locked; the slew rides the
//         +-200 ppm clamp for several pairs, never beyond it, never steps,
//         and settles back to lock
// 16..17  Sync/Follow_Up pairing by sequenceId AND source (11.4.4)
// 18,18b  BTCA tie-breaks: steps then source switch the parent with no
//         sync-ok flicker; a delayed dispatch reads the complete frozen epoch
//         its event names, so a worse announce rejects cleanly
// 18c     #68: a grandmaster identity change clears sync-ok and keeps the
//         servo locked: 50 us off it slews, 5 ms off it steps once
// 18d     #68: a failover -- a receipt timeout with asCapable held, then a
//         new grandmaster through the same parent -- keeps the servo
//         locked: -50 us off it slews, and after a second failover 150 us
//         off it steps once
// 19..21  parent degradation yields mastership immediately (10.3.5) and
//         keeps sync-ok (#84), in the commit that names thisClock, though
//         the Sync receipt timeout expires while that Announce still waits
//         behind a stalled Pdelay response; the Sync body stays zero while
//         its Follow_Up carries the live egress stamp; an asCapable fall
//         stops consumption and steering. #68: the first pair after the
//         return from mastership is locked, and 50 us off it slews; the
//         first after asCapable falls and returns is a link-up, and 25 us
//         off it steps once
// 21b,21c become resets the best record (no ghost GM after a quiet
//         ride to mastership); the priority vector outranks the
//         identity in the compare order
// 21d     the delayed-dispatch shape with a BETTER announce adopts from its
//         frozen context
// 22..26  the pdelay verdict tail: the Milan floor, the threshold,
//         two-exchange recovery, the stale ratio window. 25 (#90, #91):
//         four lost responses keep asCapable and the fifth clears it, for
//         no response, no Follow_Up, a duplicated response and three
//         responses (802.1AS-2011 Figure 11-8 RESET, Cor1 and Cor2)
// 27      the Milan 4.2.6.2.5 cease rule: storm, silence, resume,
//         re-earn -- and same-identity duplicates are not a storm
// 28b     #68: after a warm reset the lock survives in scratch, yet the
//         first pair is a link-up (the reset clears asCapable, and its
//         rise re-arms): 25 us off, it steps once
// 31      reset after a Pdelay_Req, Pdelay_Resp or Sync SEND but before its
//         boundary return invalidates the volatile owner; request, response
//         and master Sync cadence each recover autonomously (#41)
// 32      start, middle, one-cycle and long TX backpressure preserve bytes;
//         two peer requests wait behind one response claim and each gets
//         its own response Follow_Up after its own boundary stamp (#40/#33)
// 33      every frame the run transmitted, swept by messageType against
//         11.4.2.3/Table 11-4: Pdelay_Req, Follow_Up and
//         Pdelay_Resp_Follow_Up carry 0x0000, Sync and Pdelay_Resp carry
//         0x0200, none of the five carries the reserved 0x0008, and
//         Announce keeps the common 10.5.2.2.6 ptpTimescale (#64)
// 34      #68: every addend pulse of the whole run lies inside the +-200
//         ppm envelope the parent's egress reconstruction derives
// 35      #82: a peer wins with its three-entry path; a warm reset taken
//         while it is elected commits thisClock and {thisClock}, with a zero
//         tail and gmPresent alone, once and at once; the retained record
//         cannot compete, so a peer worse than this plane leaves thisClock
//         selected and a live peer worse than the absent winner is elected
//         with its own path; when that peer falls silent, Pdelay still
//         answering, the mastership commit names thisClock and {thisClock}
//         again, with gmPresent
// 36      #82: the elected peer's Pdelay stops while its Announces and
//         Syncs continue, so sync-ok is set when asCapable falls; within
//         2 ms of the fall thisClock and {thisClock} are committed with
//         gmPresent alone, the incapable port's Announces elect nothing,
//         and once capable, with no Announce, the port becomes master
//         within one receipt interval; then a live peer worse than the
//         dropped one is elected. Every commit of the run naming thisClock
//         carries {thisClock}
// 37      #84: a grandmaster's own time is the domain's time, so the master
//         role is synchronised. Every cycle of the run that publishes the
//         master bit publishes sync-ok beside it, and every commit that
//         leaves mastership for a peer grandmaster clears it. The parent's
//         tu is 0 there except during a Milan v1.2 Annex B.1.1 holdover;
//         mastership arms one only by replacing a peer grandmaster
// 38      #85: every commit naming a peer grandmaster ends its path with
//         thisClock, once, unless eight received entries fill it
// 39      #89, after 36 and ahead of the whole-run grades: a grandmaster
//         adopted with no usable Sync is aged within 375 ms of its adoption;
//         then Sync stops, loses its Follow_Up, has it after the next Sync, or
//         names the next sequenceId, while Announce continues: each time the
//         takeover lands within 375 ms and one BMCA pass, the aged port stays
//         master for 3 s of Announces, and recovered Sync, heard as master
//         without steering, lets the next Announce re-elect the grandmaster
//         once. Sync every 250 ms keeps it deferring, and a Follow_Up 60 ms
//         after its Sync is used
// 40      #89, after 39: an expiry ages the port whatever role it finds.
//         One usable pair heard as master, then Sync lost again, leaves
//         the next Announce aged; one 124 ms after the pair re-elects.
//         Mastership from an Announce lapse leaves the Sync watch running,
//         and a Sync pending at the takeover keeps its 125 ms Follow_Up
//         watch: its Follow_Up 200 ms later pairs with nothing, 60 ms later
//         it is heard
// 41      #89, the fourth pass only, after 36: ageing on Sync needs
//         gmPresent. The aged port refuses a priority1 1 Announce, elects a
//         better priority1 255 peer and keeps it 4 s without Sync, then
//         a priority1 1 Announce ages at once and this plane is master
// 42      #89, the fourth pass only, after 41: a priority1 255 peer's
//         usable Sync raises sync-ok, and when its Sync stops, sync-ok
//         clears within syncReceiptTimeout with the peer still elected
// 43      #88, after 40 and ahead of the whole-run grades: the issue's two
//         shapes (priority1 247 against 248: stepsRemoved 3 with one entry,
//         and a head that is not the grandmaster) are elected, publish
//         their path from its received head, and stop our Announce for a
//         whole interval of the parent's usable Sync
//
// A fourth pass (+not-gm-capable, an image built with --p1 255) runs only
// the phases a self publication passes through: boot, mastership, 36..38,
// 41 and 42.
// There thisClock is not grandmaster-capable, so gmPresent stays clear in
// every self publication and is set only while a capable peer is elected
// (10.3.13.2.4 g). Its checks print with a "p1 255 " prefix.
//
// All frames and expectations built independently from 802.1AS-2011 +
// Milan v1.2 4.2.6. The pdelay model mirrors the SPEC formula in exact
// integer arithmetic (Q2.30 ratio, arithmetic shift for /2), never the
// DUT's internals.

#include <array>
#include <cstdint>
#include <cstdio>
#include <vector>
#include <verilated.h>
#include "VKL_gptp_engine.h"
#include "../../common/verilator_harness.hpp"

constexpr uint64_t OUR_MAC = 0x02A1B2C3D4E5ull;
constexpr uint64_t OUR_CID = 0x02A1B2FFFEC3D4E5ull;
constexpr uint64_t PEER_CID = 0x0080E1FFFE112233ull;
// thisPort: the portNumber of our own portIdentity, and so the only
// requestingPortIdentity.portNumber a Pdelay message addressed to us
// can carry (802.1AS-2011 11.2.15.3, Figure 11-8). FOREIGN_PN is another
// port of this same clock -- the identity half that used to be unchecked
constexpr uint16_t OUR_PN = 1;
constexpr uint16_t FOREIGN_PN = 99;
//! an identity that shares OUR clockIdentity's low 32 bits and differs
//! above them, used by two rounds: as the second responder of the Milan
//! 4.2.6.2.5 probes, which the 1588-2008 9.5.2.2 compare must admit
//! (FPGA-gPTP #23), and as a genuine requester the responder must answer
//! (#26). A compare narrowed to the low half refuses it, which is how
//! both rounds catch that narrowing.
//!
//! DERIVED from OUR_CID, never hand-copied. A literal keeps the halves it
//! was written with, and --mac moves OUR_CID: measured on this suite, one
//! byte of difference in the high-half fixture and the high-half
//! narrowing mutation escapes silently at 340/340, where the derived form
//! gives 336/340. The static_asserts below are the second lock, so the
//! shared halves cannot drift without the build saying so
constexpr uint64_t NEAR_CID =
    0x0077770000000000ull | (OUR_CID & 0xFFFFFFFFull);
//! its mirror: a requester sharing our HIGH 32 bits and differing below,
//! so a compare narrowed to the high half refuses this one instead (#26)
constexpr uint64_t REQ_HI_CID =
    (OUR_CID & 0xFFFFFFFF00000000ull) | 0x00112233ull;
static_assert((NEAR_CID & 0xFFFFFFFFull) == (OUR_CID & 0xFFFFFFFFull),
              "NEAR_CID must share OUR_CID's low half");
static_assert((NEAR_CID >> 32) != (OUR_CID >> 32),
              "NEAR_CID must differ from OUR_CID above the halfway line");
static_assert((REQ_HI_CID >> 32) == (OUR_CID >> 32),
              "REQ_HI_CID must share OUR_CID's high half");
static_assert((REQ_HI_CID & 0xFFFFFFFFull) != (OUR_CID & 0xFFFFFFFFull),
              "REQ_HI_CID must differ from OUR_CID below the halfway line");
constexpr uint32_t OUR_CQ = 0xF8FE436A;

// publish flags bits (the retired software contract)
constexpr uint32_t FL_PRESENT = 1;
constexpr uint32_t FL_AMGM = 2;
constexpr uint32_t FL_ASCAP = 4;
constexpr uint32_t FL_SYNCOK = 8;

namespace {

//! The whole KL_gptp_engine round-trip: the Verilated model, the wire and
//! PHC models that drive it, the independent spec mirrors that grade it, and
//! the phases named in the file header, in the order they run.
//!
//! Every piece of state a phase leaves behind for a later phase is a member
//! here rather than a file-scope variable (C++ Core Guidelines I.2), so a
//! reader can see the whole of what one phase can disturb by reading one
//! class rather than the whole translation unit.
class GptpEngineHarness {
 public:
  //! #82: the image was built with priority1 255, so thisClock is not
  //! grandmaster-capable and the self publication carries no gmPresent
  explicit GptpEngineHarness(bool not_gm_capable)
      : self_present(not_gm_capable ? 0u : FL_PRESENT),
        check_prefix(not_gm_capable ? "p1 255 " : "") {}

  //! Runs every phase in file order and prints the one tally line the sweep
  //! parses. Returns the process exit status: 0 pass, 1 fail.
  int run_suite() {
    if (self_present == 0)
      run_the_self_publication_phases();
    else
      run_every_phase();
    printf("%d checks: %d PASS, %d FAIL\n", checks, checks - fails, fails);
    return fails ? 1 : 0;
  }

 private:

  //! The fourth pass: the phases a self publication passes through, and no
  //! others. The rest of the suite scripts a grandmaster-capable plane.
  void run_the_self_publication_phases() {
    bring_the_engine_out_of_reset();
    check_the_boot_pdelay_request();
    publish_thisclock_before_any_peer();
    txts_idx(our_req_idx, T1);   // the boot request's stamp, as phase 2
    raise_ascapable_on_the_second_exchange();
    become_master_on_announce_receipt_timeout();
    drop_a_peer_whose_pdelay_stops();
    age_only_while_a_grandmaster_is_present();
    clear_sync_ok_when_sync_stops_without_a_grandmaster_present();
    hold_every_committed_path_coherent();
    keep_sync_ok_in_every_master_cycle();
    end_every_peer_path_with_thisclock();
  }

  //! The shipping passes: every phase named in the file header, in order.
  void run_every_phase() {
    bring_the_engine_out_of_reset();
    check_the_boot_pdelay_request();
    publish_thisclock_before_any_peer();
    ignore_a_self_sourced_pdelay_request();
    answer_peer_requests_across_our_pending_stamp();
    separate_claims_differing_only_in_the_sequence_high_byte();
    separate_equal_sequence_request_and_response_claims();
    ignore_a_follow_up_for_the_boot_request();
    compute_the_first_exchange_delay();
    ignore_a_self_sourced_pdelay_response();
    answer_a_peer_initiated_exchange();
    answer_a_requester_whose_identity_nearly_matches_ours();
    refuse_a_foreign_domain_pdelay_request();
    refuse_a_truncated_pdelay_request();
    refuse_an_unlisted_message_type();
    raise_ascapable_on_the_second_exchange();
    become_master_on_announce_receipt_timeout();
    check_our_announce();
    check_our_sync_and_follow_up();
    pair_a_follow_up_only_with_the_outstanding_resp();
    pair_a_pdelay_exchange_whose_flag_bits_are_ignored();
    stay_master_against_a_worse_announce();
    refuse_a_better_announce_in_a_foreign_domain();
    refuse_unqualified_announces_and_admit_the_controls();
    append_thisclock_to_each_received_path();
    defer_whatever_the_path_count();
    keep_the_previous_path_without_a_tlv();
    adopt_a_better_announce_and_hold_its_path();
    clamp_a_deep_path_and_take_a_parent_refresh();
    walk_past_an_unknown_tlv_to_a_later_path_trace();
    refuse_a_malformed_announce_suffix();
    copy_a_path_trace_whose_head_is_not_the_announced_gm();
    hold_the_frozen_announce_context_under_overload();
    stop_sync_transmission_after_adoption();
    steer_on_the_first_peer_sync();
    pair_nothing_with_a_late_follow_up();
    never_steer_from_a_foreign_domain_sync_pair();
    never_steer_from_a_follow_up_without_its_tlv();
    pair_a_padded_sync();
    pair_a_sync_whose_flag_bits_are_ignored();
    age_the_grandmaster_at_the_sync_receipt_timeout();
    stay_locked_across_a_receipt_timeout();
    step_over_twenty_microseconds_at_link_up();
    step_over_a_hundred_microseconds_once_locked();
    slew_on_a_five_microsecond_offset();
    converge_the_closed_loop_on_a_fast_master();
    slew_a_locked_master_jump_inside_the_envelope();
    pair_nothing_with_a_wrong_sequence_follow_up();
    pair_nothing_with_a_follow_up_from_the_wrong_source();
    break_btca_ties_on_steps_then_source();
    read_a_complete_frozen_epoch_in_a_delayed_dispatch();
    stay_locked_across_a_grandmaster_change();
    stay_locked_across_a_failover_after_a_receipt_timeout();
    take_mastership_when_the_parent_degrades();
    keep_the_two_step_sync_body_zero();
    stop_consuming_sync_when_ascapable_falls();
    reset_the_best_record_on_become();
    outrank_the_identity_with_the_priority_vector();
    process_a_better_delayed_announce_from_its_epoch();
    accept_a_negative_delay_inside_the_milan_floor();
    drop_ascapable_over_the_threshold();
    recover_ascapable_in_two_good_exchanges();
    clear_ascapable_at_the_fifth_lost_response();
    hold_the_ratio_across_a_stale_window();
    refuse_to_complete_an_exchange_twice();
    cease_on_multiple_responders_and_re_earn();
    cease_on_a_late_second_identity();
    resume_after_a_warm_reset_during_a_cease();
    link_up_again_after_a_warm_reset();
    refuse_a_chasing_follow_up_the_resp_arrival();
    refuse_a_runt_chaser_the_predecessor_stamp();
    recover_the_request_cadence_across_reset();
    recover_the_response_claim_across_reset();
    recover_the_sync_cadence_across_reset();
    hold_two_response_claims_under_backpressure();
    deliver_two_results_at_every_separation();
    retire_only_the_lost_result_s_own_claim();
    hold_a_complete_pair_until_its_own_t1();
    postpone_only_the_initiating_beats_without_credit();
    stall_every_byte_position_of_one_frame();
    hold_the_media_dependent_transmit_flags();
    exercise_the_slew_level_contract();
    keep_every_addend_inside_the_consumer_envelope();
    return_to_thisclock_around_a_winning_peer();
    drop_a_peer_whose_pdelay_stops();
    age_a_grandmaster_whose_sync_fails();
    age_the_port_whatever_role_the_timeout_finds();
    defer_a_whole_interval_to_the_issue_shapes();
    hold_every_committed_path_coherent();
    keep_sync_ok_in_every_master_cycle();
    end_every_peer_path_with_thisclock();
  }

  //! flags bit 0 in a self publication: gmPresent when thisClock is
  //! grandmaster-capable (802.1AS-2020 10.3.13.2.4 g)
  const uint32_t self_present;
  //! names the pass on every failed check, so a control can name the pass
  const char *const check_prefix;
  int checks = 0;
  int fails = 0;
  void expect(const char *what, uint64_t got, uint64_t exp) {
    checks++;
    if (got != exp) {
      fails++;
      printf("FAIL %s%-28s got %016llx exp %016llx\n", check_prefix, what,
             static_cast<unsigned long long>(got),
             static_cast<unsigned long long>(exp));
    }
  }

  struct Frame {
    std::vector<uint8_t> b;
    void u8(uint8_t v) { b.push_back(v); }
    void u16(uint16_t v) { u8(v >> 8); u8(v & 0xFF); }
    void u32(uint32_t v) { u16(v >> 16); u16(v & 0xFFFF); }
    void u48(uint64_t v) { u16((v >> 32) & 0xFFFF); u32(v & 0xFFFFFFFF); }
    void u64(uint64_t v) { u32(v >> 32); u32(v & 0xFFFFFFFF); }
    void ts(uint64_t ns) { u48(ns / 1000000000ull); u32(ns % 1000000000ull); }
  };

  Frame ptp(uint8_t mtype, uint16_t seq, uint64_t corr,
            uint16_t flags, uint16_t body_len,
            uint64_t src = PEER_CID) {
    Frame f;
    f.u48(0x0180C200000Eull);
    f.u48(0x0080E1112233ull);
    f.u16(0x88F7);
    f.u8(0x10 | mtype); f.u8(0x02);
    f.u16(34 + body_len);
    f.u8(0); f.u8(0);
    f.u16(flags);
    f.u64(corr);
    f.u32(0);
    f.u64(src); f.u16(1);
    f.u16(seq);
    f.u8(0x05); f.u8(0x7F);
    return f;
  }

  // a Follow_Up: header, preciseOriginTimestamp and the information TLV
  // (802.1AS-2011 Table 11-9: 76 octets; 11.4.4.3 / Table 11-10: tlvType
  // 0x3, lengthField 28, organizationId 00-80-C2, organizationSubType 1,
  // then cumulativeScaledRateOffset, gmTimeBaseIndicator, lastGmPhaseChange
  // and scaledLastGmFreqChange). Until #11 every Follow_Up this suite sent
  // stopped after the timestamp: the shape the parser wrongly accepted was
  // the shape the bench called valid
  //! `flags` is 11.4.2.3's transmitted value by default. A probe passes
  //! another only to prove the receiver ignores those bits (11.4.1).
  Frame follow_up(uint16_t seq, uint64_t corr, uint64_t origin,
                  uint64_t src = PEER_CID, uint16_t flags = 0x0000) {
    Frame g = ptp(0x8, seq, corr, flags, 42, src);
    g.ts(origin);
    g.u16(0x0003); g.u16(28);
    g.u8(0x00); g.u8(0x80); g.u8(0xC2);
    g.u8(0x00); g.u8(0x00); g.u8(0x01);
    g.u32(0);                                    // cumulativeScaledRateOffset
    g.u16(0);                                    // gmTimeBaseIndicator
    for (int i = 0; i < 12; i++) g.u8(0);        // lastGmPhaseChange
    g.u32(0);                                    // scaledLastGmFreqChange
    return g;
  }


  //! Owns the Verilated model for this harness's lifetime;
  //! `final()` runs on every path out (Core Guidelines R.11).
  const milan::tb::Model<VKL_gptp_engine> model;
  VKL_gptp_engine *dut = model.get();   // the file's own observing pointer
  //! the sequenceId a boundary stamper reads out of the frame it stamps
  //! (PTP header offset 30, frame offset 44)
  uint16_t seq_of(const std::vector<uint8_t> &f) {
    return f.size() > 45 ? static_cast<uint16_t>((f[44] << 8) | f[45]) : 0;
  }
  //! the messageType nibble the parent boundary stamper returns beside it
  uint8_t type_of(const std::vector<uint8_t> &f) {
    return f.size() > 14 ? static_cast<uint8_t>(f[14] & 0xF) : 0;
  }

  uint64_t cyc = 0;
  uint64_t commits_seen = 0;
  //! pub_path_o carries pathTrace's first eight entries from entry 0,
  //! flattened into 8x2 little-endian 32-bit words (see pub_path_entry
  //! below). The head is entry 0; the tail is the seven entries after it.
  static constexpr unsigned PATH_TAIL_SLOTS = 7;
  struct PubSnap {
    uint64_t gm;
    uint64_t parent;
    uint8_t count;
    uint64_t head;
    uint64_t tail[PATH_TAIL_SLOTS];
    uint64_t cyc;    //!< the harness cycle that sampled this commit
    uint32_t flags;
  };
  std::vector<PubSnap> commit_snaps;
  static constexpr size_t MAX_COMMIT_SNAPS = 1000000;
  //! #82: from cold release to the first timer beat every cycle's outputs
  //! are graded, not only its commits: the cycles seen, and those whose
  //! grandmaster is not thisClock, whose path is not {thisClock} or whose
  //! gmPresent is not the self publication's
  bool boot_watch = false;
  uint64_t boot_cycles = 0;
  uint64_t boot_bad_gm = 0;
  uint64_t boot_bad_path = 0;
  uint64_t boot_bad_present = 0;
  //! #84: every cycle of the run is graded: those whose published flags
  //! carry the master bit, and those of them without sync-ok
  uint64_t master_cycles = 0;
  uint64_t master_unsynced_cycles = 0;

  // ---- TX backpressure ------------------------------------------------------
  //! every Pdelay_Req transmitted so far: a beat judges the request before
  //! it, so the #90 phases count losses in these
  uint64_t pd_reqs_sent = 0;
  std::vector<std::vector<uint8_t>> txf;
  std::vector<uint64_t> txns;               // egress ts fed per frame
  std::vector<uint8_t> cur;
  bool in_tx = false;
  bool auto_txts = false;
  int auto_pend = -1;

  // ---- the egress result face: valid/ready, the whole tuple held ------------
  //! The engine takes a result only on a beat where valid and ready are both
  //! high, so this harness models a PRODUCER: it offers one complete tuple
  //! and holds every field of it stable until that beat happens. A one-cycle
  //! pulse would be a silently lost transfer, and replacing an unaccepted
  //! offer is exactly the defect under repair, so offer_result refuses to do
  //! either rather than hide them.
  bool ts_offer = false;
  uint64_t ts_offer_ns = 0;
  uint16_t ts_offer_seq = 0;
  uint8_t ts_offer_type = 0;
  bool ts_offer_ok = true;
  uint8_t ts_offer_gen = 1;
  uint64_t ts_beats = 0;          //!< accepted beats seen by the harness
  uint64_t ts_offer_waits = 0;    //!< cycles an offer waited for ready
  //! the value the last accepted beat carried, kept so a test can prove the
  //! engine did not resample a later offer into an earlier result
  uint64_t ts_last_taken_ns = 0;

  void drive_result_face() {
    dut->txts_valid_i = ts_offer ? 1 : 0;
    dut->txts_ns_i    = ts_offer_ns;
    dut->txts_seq_i   = ts_offer_seq;
    dut->txts_type_i  = ts_offer_type;
    dut->txts_ok_i    = ts_offer_ok ? 1 : 0;
    dut->txts_gen_i   = ts_offer_gen;
  }

  //! Frames whose result this phase delivers by hand, named by the tag the
  //! parent stamper would report. The automatic producer skips exactly
  //! these, so withholding one frame's result never silences the stamps of
  //! unrelated frames: that would leave a claim standing for the wrong
  //! reason and make a later assertion pass or fail by accident.
  std::vector<std::pair<uint8_t, uint16_t>> withheld;

  void withhold(uint8_t type, uint16_t seq) {
    withheld.emplace_back(type, seq);
  }

  void release_withheld() { withheld.clear(); }

  void release_withheld(uint8_t type, uint16_t seq) {
    for (size_t i = 0; i < withheld.size(); i++)
      if (withheld[i].first == type && withheld[i].second == seq) {
        withheld.erase(withheld.begin() + static_cast<long>(i));
        return;
      }
  }

  bool is_withheld(size_t idx) {
    for (const std::pair<uint8_t, uint16_t> &w : withheld)
      if (w.first == type_of(txf[idx]) && w.second == seq_of(txf[idx]))
        return true;
    return false;
  }

  void offer_result(uint64_t ns, uint16_t seq, uint8_t type,
                    bool ok = true, uint8_t gen = 1) {
    if (ts_offer)
      expect("producer never replaces an unaccepted result", 1, 0);
    ts_offer = true;
    ts_offer_ns = ns;
    ts_offer_seq = seq;
    ts_offer_type = type;
    ts_offer_ok = ok;
    ts_offer_gen = gen;
  }

  // ---- the PHC: a live timestamp_counter model the servo can steer ----------
  // Q24 accumulator, 500 ns nominal per tick (2 MHz); adjfine addend and
  // adjtime steps applied exactly as the parent counter would
  unsigned __int128 phc_acc = 0;
  int32_t phc_adj = 0;
  std::vector<uint64_t> steps_seen;         // every adjtime write
  std::vector<uint32_t> adj_seen;           // every adjfine write
  //! the cycle of each of those write-enable samples: a pulse held for two
  //! cycles is two entries, and a step's order against its addend is here
  std::vector<uint64_t> step_cyc;
  std::vector<uint64_t> adj_cyc;
  //! every addend pulse of the whole run graded against the consumer's
  //! envelope (#68): the count outside it, and the count exactly on it
  uint64_t adj_out_of_envelope = 0;
  uint64_t adj_on_the_rail = 0;
  struct SlewEdge { uint64_t cycle; bool active; };
  std::vector<SlewEdge> slew_edges;
  bool slew_previous = false;
  uint64_t slew_async_changes = 0;
  uint64_t slew_early_clears = 0;
  std::vector<bool> slew_at_step;

  uint64_t phc() { return static_cast<uint64_t>(phc_acc >> 24); }

  void tick() {
    if (auto_pend >= 0 && !ts_offer) {
      if (is_withheld(static_cast<size_t>(auto_pend))) {
        auto_pend = -1;                            // this phase delivers it
      } else {
        uint64_t ns = phc() + 200;                 // MAC pipeline latency
        offer_result(ns, seq_of(txf[auto_pend]), type_of(txf[auto_pend]));
        txns[auto_pend] = ns;
        auto_pend = -1;
      }
    }
    drive_result_face();
    dut->clk_i = 0; dut->eval();
    if (bool(dut->phc_slew_active_o) != slew_previous) slew_async_changes++;
    //! the accepted beat is sampled where the engine samples it
    const bool ts_beat = ts_offer && dut->txts_ready_o;
    const bool tx_fire = dut->tx_valid_o && dut->tx_ready_i;
    const uint8_t tx_data = dut->tx_data_o;
    const bool tx_sof = dut->tx_sof_o;
    const bool tx_eof = dut->tx_eof_o;
    dut->clk_i = 1; dut->eval();
    const bool slew = dut->phc_slew_active_o;
    if (slew != slew_previous) {
      slew_edges.push_back({cyc, slew});
      if (!slew && dut->rst_n && !dut->phc_addend_we_o) slew_early_clears++;
      slew_previous = slew;
    }
    if (boot_watch) {
      boot_cycles++;
      if (dut->pub_gm_id_o != OUR_CID) boot_bad_gm++;
      bool self_path = dut->pub_path_count_o == 1 &&
                       pub_path_head() == OUR_CID;
      for (unsigned k = 0; k < PATH_TAIL_SLOTS; k++)
        self_path &= pub_path_tail(k) == 0;
      if (!self_path) boot_bad_path++;
      if ((dut->pub_flags_o & FL_PRESENT) != self_present) boot_bad_present++;
    }
    if (dut->pub_flags_o & FL_AMGM) {
      master_cycles++;
      if (!(dut->pub_flags_o & FL_SYNCOK)) master_unsynced_cycles++;
    }
    if (dut->pub_commit_o) commits_seen++;
    //! The record is bounded: a defect that commits on every cycle must
    //! fail its checks, not exhaust the host. A clean run commits hundreds.
    if (dut->pub_commit_o && commit_snaps.size() < MAX_COMMIT_SNAPS) {
      PubSnap s{};
      s.gm = dut->pub_gm_id_o;
      s.parent = dut->pub_parent_id_o;
      s.count = dut->pub_path_count_o;
      s.cyc = cyc;
      s.flags = dut->pub_flags_o;
      s.head = pub_path_head();
      for (unsigned k = 0; k < PATH_TAIL_SLOTS; k++)
        s.tail[k] = pub_path_tail(k);
      commit_snaps.push_back(s);
    }
    if (dut->phc_addend_we_o) {
      phc_adj = static_cast<int32_t>(dut->phc_addend_o);
      adj_seen.push_back(dut->phc_addend_o);
      adj_cyc.push_back(cyc);
      const int64_t a = phc_adj;
      if (a > SV_AMAX || a < -SV_AMAX) adj_out_of_envelope++;
      if (a == SV_AMAX || a == -SV_AMAX) adj_on_the_rail++;
    }
    if (dut->phc_step_we_o) {
      slew_at_step.push_back(dut->phc_slew_active_o);
      steps_seen.push_back(dut->phc_step_o);
      step_cyc.push_back(cyc);
      phc_acc += static_cast<unsigned __int128>(
          static_cast<__int128>(static_cast<int64_t>(dut->phc_step_o)) << 24);
    }
    phc_acc += static_cast<unsigned __int128>(
        static_cast<uint64_t>((500ll << 24) + phc_adj));
    if (tx_fire) {
      if (tx_sof) { cur.clear(); in_tx = true; }
      if (in_tx) cur.push_back(tx_data);
      if (tx_eof && in_tx) {
        if (type_of(cur) == 0x2) pd_reqs_sent++;
        txf.push_back(cur);
        txns.push_back(0);
        if (auto_txts) auto_pend = static_cast<int>(txf.size()) - 1;
        in_tx = false;
      }
    }
    if (ts_beat) {
      ts_offer = false;
      ts_beats++;
      ts_last_taken_ns = ts_offer_ns;
    } else if (ts_offer) {
      ts_offer_waits++;
    }
    cyc++;
  }

  void run(uint64_t n) { while (n--) tick(); }

  //! Settle whatever result the automatic producer still owes, BOUNDED in
  //! DUT cycles. A result face that stops accepting must fail this suite,
  //! not hang it: an unbounded drain would turn a wedged result path into
  //! a stalled process, and a stalled process is not a verdict.
  void drain_automatic_results() {
    for (int k = 0; k < 200000 && (auto_pend >= 0 || ts_offer); k++) tick();
    if (auto_pend >= 0 || ts_offer)
      expect("the result face keeps accepting", 0, 1);
  }

  void send_frame(const std::vector<uint8_t> &bytes, uint64_t rx_ts) {
    dut->rx_ts_i = rx_ts;
    for (size_t i = 0; i < bytes.size(); i++) {
      dut->rx_valid_i = 1;
      dut->rx_data_i = bytes[i];
      dut->rx_sof_i = (i == 0);
      dut->rx_eof_i = (i + 1 == bytes.size());
      dut->rx_err_i = 0;
      tick();
    }
    dut->rx_valid_i = 0; dut->rx_sof_i = 0; dut->rx_eof_i = 0;
  }

  //! Offer one CHOSEN transmitted frame's result, reporting its own header
  //! identity the way the parent boundary stamper does, and run until the
  //! engine takes it. Bounded: a face that never accepts must fail the
  //! suite rather than hang it.
  void deliver_result(size_t idx, uint64_t ns, bool ok = true,
                      uint8_t gen = 1) {
    if (idx < txf.size()) release_withheld(type_of(txf[idx]), seq_of(txf[idx]));
    offer_result(ns, idx < txf.size() ? seq_of(txf[idx]) : 0,
                 idx < txf.size() ? type_of(txf[idx]) : 0, ok, gen);
    for (int n = 0; n < 200000 && ts_offer; n++) tick();
    if (ts_offer) expect("offered result was accepted", 0, 1);
  }

  void txts_idx(size_t idx, uint64_t ns) { deliver_result(idx, ns); }

  //! stamp the frame last sent, the common case
  void txts(uint64_t ns) {
    txts_idx(txf.empty() ? 0 : txf.size() - 1, ns);
  }

  // ---- pdelay model: the spec formula in the ROM's exact integer forms ------
  // nrr = ((t3-t3')<<30)/(t4-t4') when the window fits 32 bits;
  // D = (((nrr*(t4-t1))>>30) - (t3-t2)) >>arith 1, uncorrected before the
  // first ratio. Mirrors 802.1AS-2011 11.2.15.3 / Milan 4.2.6, not the DUT.
  struct PdelayModelState {
    uint64_t nr3 = 0;
    uint64_t nr4 = 0;
    uint64_t nrr = 0;
    int64_t d = 0;
    int count = 0;
    bool stale_skip = false;       // last window rejected as > 2^32 ns
  };
  PdelayModelState pdm;

  void model_exchange(uint64_t t1, uint64_t t2, uint64_t t3,
                      uint64_t t4) {
    pdm.stale_skip = false;
    if (pdm.nr3 != 0) {
      uint64_t num = t3 - pdm.nr3;
      uint64_t den = t4 - pdm.nr4;
      if ((den >> 32) == 0 && (den & 0xFFFFFFFFull) != 0)
        pdm.nrr = (num << 30) / (den & 0xFFFFFFFFull);
      else
        pdm.stale_skip = true;
    }
    pdm.nr3 = t3; pdm.nr4 = t4;
    uint64_t turn = t4 - t1;
    uint64_t corr = turn;
    if (pdm.nrr != 0) {
      int64_t prod =
          static_cast<int64_t>(static_cast<int32_t>(pdm.nrr & 0xFFFFFFFFull)) *
          static_cast<int64_t>(static_cast<int32_t>(turn & 0xFFFFFFFFull));
      corr = static_cast<uint64_t>(prod) >> 30;
    }
    pdm.d = static_cast<int64_t>(corr - (t3 - t2)) >> 1;
    pdm.count++;
  }

  // ---- servo mirror: the #68 step-vs-slew policy in exact integer form -----
  // The policy as docs/INTEGRATION.md records it, not as the ROM encodes it:
  // a LINK-UP pair (the first after asCapable rises, which every reset
  // forces, and after nothing else) steps when |offset| exceeds 20 us; a
  // LOCKED pair, including the first after a grandmaster identity change,
  // a Sync receipt timeout or a return from mastership, steps above
  // 100 us; every other pair slews through the PI. The whole written trim
  // is clamped to the consumer's envelope. The caller says whether the
  // pair is a link-up, from the phase it scripted, never from the DUT.
  // Gains match gen_gptp_ucode.py at --clk-hz 2000000
  static constexpr int64_t SV_STEP_LINKUP_NS = 20000;
  static constexpr int64_t SV_STEP_LOCKED_NS = 100000;
  static constexpr int64_t SV_GAIN_M = 4295;
  static constexpr int64_t SV_GAIN_S = 6;
  //! THE CONSUMER'S ENVELOPE, derived here as the parent derives it: its
  //! KL_gptp_txret.sv refuses every egress timestamp taken while |addend|
  //! exceeds PHC_ADJ_MAX_C = (RECON_REL_PPM_P * 2^24 * 1000 + clk / 2) /
  //! clk, with RECON_REL_PPM_P = 200 and clk the clock the generator is
  //! given (this suite's 2 MHz). Written out, not copied from either side
  static constexpr int64_t SV_CLK_HZ = 2000000;
  static constexpr int64_t SV_ENV_PPM = 200;
  static constexpr int64_t SV_AMAX =
      (SV_ENV_PPM * (int64_t{1} << 24) * 1000 + SV_CLK_HZ / 2) / SV_CLK_HZ;
  //! the integrator clamp: the same +-200 ppm
  static constexpr int64_t SV_ILIM = SV_AMAX;
  struct ServoModelState {
    int64_t intg = 0;
    bool stepped = false;                          // last sample stepped
    uint64_t step_val = 0;
    int64_t addend = 0;
  };
  ServoModelState svm;

  static int64_t clamp_to(int64_t v, int64_t lim) {
    return v > lim ? lim : (v < -lim ? -lim : v);
  }

  //! the PI output, before the envelope clamp
  static int64_t pi_out(int64_t t, int64_t intg) {
    return (t - (t >> 2)) + intg;
  }

  void servo_mirror(int64_t off, bool linkup) {
    const int64_t thr = linkup ? SV_STEP_LINKUP_NS : SV_STEP_LOCKED_NS;
    if (off > thr || off < -thr) {
      svm.stepped = true;
      svm.step_val = static_cast<uint64_t>(-off);
      // the surviving rate estimate, alone
      svm.addend = -clamp_to(svm.intg, SV_AMAX);
      return;
    }
    svm.stepped = false;
    const int64_t t = (off * SV_GAIN_M) >> SV_GAIN_S;
    svm.intg = clamp_to(svm.intg + (t >> 2), SV_ILIM);
    svm.addend = -clamp_to(pi_out(t, svm.intg), SV_AMAX);
  }

  //! the data of the last addend pulse, or a value no 32-bit addend can
  //! carry when there was none: a missing pulse then fails its check
  //! instead of reading past an empty record
  uint64_t last_adj() const {
    return adj_seen.empty() ? ~0ull : adj_seen.back();
  }

  //! whether the PHC face shows exactly the pulses the mirror names for
  //! the pair just consumed: one step pulse carrying -offset and then one
  //! addend pulse, or the addend pulse alone
  bool steered_as_mirror(size_t s0, size_t a0) {
    const bool addend = adj_seen.size() == a0 + 1 &&
                        adj_seen.back() == adj_bits(svm.addend);
    if (!svm.stepped) return addend && steps_seen.size() == s0;
    return addend && steps_seen.size() == s0 + 1 &&
           steps_seen.back() == svm.step_val && step_cyc.back() < adj_cyc.back();
  }

  //! the addend a 32-bit PHC write carries for a mirror value
  static uint32_t adj_bits(int64_t addend) {
    return static_cast<uint32_t>(static_cast<int32_t>(addend));
  }

  // ---- auto peer: answers every Pdelay_Req the DUT transmits ----------------
  // peer clock runs at +2^-13 (~122 ppm) against ours; turnaround fields are
  // constants of the mode, the ingress stamp is t1 + wire turnaround.
  //! PD_NOFU answers with a Pdelay_Resp and no Follow_Up, PD_DUP with two
  //! identical Pdelay_Resp and one Follow_Up, PD_DUP3 with three (#90, #91).
  //! None of the three completes an exchange (802.1AS-2011 Figure 11-8: a
  //! second response is RESET), so none of them feeds the pdelay model
  enum PdMode { PD_OFF, PD_NORMAL, PD_NEG, PD_FAR, PD_SKIP, PD_SELF, PD_DUAL,
                PD_DUP, PD_DUAL_LATE, PD_NOFU, PD_DUP3 };
  PdMode pd_mode = PD_SKIP;         // SKIP: consume silently
  size_t pd_seen = 0;
  int pd_self_sent = 0;             // PD_SELF pairs actually sent

  uint64_t peer_ns(uint64_t ours) {
    return 5000000ull + ours + (ours >> 13);
  }

  void service_pdelay() {
    while (pd_seen < txf.size()) {
      size_t i = pd_seen;
      if ((txf[i].size() <= 14) || ((txf[i][14] & 0xF) != 0x2)) {
        pd_seen++;
        continue;
      }
      if (txns[i] == 0) return;            // egress ts not fed yet
      pd_seen++;
      if (pd_mode == PD_OFF) continue;     // lost response
      if (pd_mode == PD_SKIP) continue;    // pre-enable housekeeping
      uint16_t seq = static_cast<uint16_t>((txf[i][44] << 8) | txf[i][45]);
      uint64_t t1 = txns[i];
      uint64_t t2 = peer_ns(t1 + 300);
      if (pd_mode == PD_SELF) {
        // our own request reflected back at us: the pair answers the
        // outstanding sequenceId with our requestingPortIdentity, so every
        // other gate admits it and only the sourcePortIdentity compare can
        // refuse it. Its residency is 19,800, a delay near 700 rather than
        // the 600 of a genuine exchange, so an accepted pair MOVES the
        // published delay (still under the 800 ns threshold, which must
        // not be what refuses it). No model_exchange: it never happened
        Frame f = ptp(0x3, seq, 0, 0x0200, 20, OUR_CID);
        f.ts(t2); f.u64(OUR_CID); f.u16(1);
        send_frame(f.b, t1 + 21200);
        run(400);
        Frame g = ptp(0xA, seq, 0, 0x0000, 20, OUR_CID);
        g.ts(t2 + 19800); g.u64(OUR_CID); g.u16(1);
        send_frame(g.b, t1 + 21200 + 1000);
        run(400);
        pd_self_sent++;
        continue;
      }
      uint64_t resid = 20000;              // D = +600 after correction
      if (pd_mode == PD_NEG) resid = 21300;   // D ~ -49: the Milan floor
      if (pd_mode == PD_FAR) resid = 19200;   // D ~ +1001: over threshold
      uint64_t t3 = t2 + resid;
      uint64_t t4 = t1 + 21200;
      Frame f = ptp(0x3, seq, 0, 0x0200, 20);
      f.ts(t2); f.u64(OUR_CID); f.u16(1);
      send_frame(f.b, t4);
      run(400);
      if (pd_mode == PD_NOFU) continue;   // the Follow_Up never comes
      const int dups = pd_mode == PD_DUP3 ? 2 :
          (pd_mode == PD_DUAL || pd_mode == PD_DUP) ? 1 : 0;
      for (int k = 1; k <= dups; k++) {
        uint64_t src2 = (pd_mode == PD_DUAL) ? NEAR_CID
                                             : PEER_CID;
        // a pairing with a later response would compute 600 + 60 k ns
        Frame d = ptp(0x3, seq, 0, 0x0200, 20, src2);
        d.ts(t2 + 40 * k); d.u64(OUR_CID); d.u16(1);
        send_frame(d.b, t4 + 80 * k);
        run(400);
      }
      Frame g = ptp(0xA, seq, 0, 0x0000, 20);
      g.ts(t3); g.u64(OUR_CID); g.u16(1);
      send_frame(g.b, t4 + 1000);
      run(400);
      if (pd_mode == PD_DUAL_LATE) {
        // the second identity answers AFTER the first responder's
        // Follow_Up: the exchange has completed, so this response takes
        // the handler's post-completion path, which must still reach the
        // Milan 4.2.6.2.5 identity bookkeeping
        Frame d = ptp(0x3, seq, 0, 0x0200, 20, NEAR_CID);
        d.ts(t2 + 40); d.u64(OUR_CID); d.u16(1);
        send_frame(d.b, t4 + 2000);
        run(400);
      }
      if (dups == 0) model_exchange(t1, t2, t3, t4);
    }
  }

  void run_svc(uint64_t n) {
    while (n--) { tick(); if ((n & 255) == 0) service_pdelay(); }
  }

  bool wait_flags(uint32_t mask, uint32_t want, uint64_t max_ticks) {
    for (uint64_t n = 0; n < max_ticks; n++) {
      if ((dut->pub_flags_o & mask) == want) return true;
      tick();
      if ((n & 255) == 0) service_pdelay();
    }
    return false;
  }

  bool wait_exchanges(int count, uint64_t max_ticks) {
    for (uint64_t n = 0; n < max_ticks; n++) {
      if (pdm.count >= count) return true;
      tick();
      if ((n & 255) == 0) service_pdelay();
    }
    return false;
  }

  //! Run, the auto-peer answering in its current mode, until `count`
  //! Pdelay_Req frames have gone out in all. Bounded in DUT cycles
  bool wait_requests(uint64_t count, uint64_t max_ticks) {
    for (uint64_t n = 0; n < max_ticks; n++) {
      if (pd_reqs_sent >= count) return true;
      tick();
      if ((n & 255) == 0) service_pdelay();
    }
    return false;
  }

  size_t tx_seen = 0;
  std::vector<uint8_t> wait_tx(int mtype, uint64_t max_cycles,
                               size_t *idx_out = nullptr) {
    for (uint64_t n = 0; n < max_cycles; n++) {
      while (tx_seen < txf.size()) {
        size_t i = tx_seen++;
        if (mtype < 0 || (txf[i].size() > 14 && (txf[i][14] & 0xF) == mtype)) {
          if (idx_out) *idx_out = i;
          return txf[i];
        }
      }
      tick();
      if ((n & 255) == 0) service_pdelay();
    }
    printf("FAIL wait_tx type %d: timeout\n", mtype);
    fails++; checks++;
    return {};
  }

  // a sync+FU pair from `src`; returns the offset the plane should see
  void sync_pair(uint16_t seq, uint64_t local_rx, uint64_t origin,
                 uint64_t src = PEER_CID) {
    Frame f = ptp(0x0, seq, 0, 0x0208, 10, src);
    f.ts(0);
    send_frame(f.b, local_rx);
    run(2000);
    Frame g = follow_up(seq, 0, origin, src);
    send_frame(g.b, local_rx + 500);
    run(6000);
  }

  //! One pair whose offset, as the plane measures it (local minus master,
  //! less the modelled link delay, no correctionField), is exactly `off`,
  //! graded against the #68 policy. `linkup` and `want_step` are what the
  //! calling phase scripted; the mirror must agree with them, and the PHC
  //! face must show exactly the pulses the policy names: one step pulse
  //! carrying -offset, then one addend pulse carrying the bare integrator;
  //! or no step pulse and one addend pulse carrying the clamped PI output.
  //! The published verdict is low before a link-up pair and high before a
  //! locked one, except after a grandmaster identity change, a receipt
  //! timeout or mastership, which clear it and yet keep the servo locked:
  //! `verdict_before` says so there.
  void expect_policy_pair(const char *tag, uint16_t seq, uint64_t local_rx,
                          int64_t off, bool linkup, bool want_step,
                          uint64_t src = PEER_CID, int verdict_before = -1) {
    char n[128];
    const size_t s0 = steps_seen.size();
    const size_t a0 = adj_seen.size();
    const bool high = verdict_before < 0 ? !linkup : verdict_before != 0;
    snprintf(n, sizeof n, "%s: sync-ok %s before the pair", tag,
             high ? "high" : "low");
    expect(n, dut->pub_flags_o & FL_SYNCOK, high ? FL_SYNCOK : 0u);
    sync_pair(seq, local_rx,
              local_rx - static_cast<uint64_t>(pdm.d)
                  - static_cast<uint64_t>(off),
              src);
    servo_mirror(off, linkup);
    snprintf(n, sizeof n, "%s: the harness mirror agrees", tag);
    expect(n, svm.stepped, want_step);
    snprintf(n, sizeof n, "%s: offset published", tag);
    expect(n, static_cast<uint32_t>(dut->pub_offset_o),
           static_cast<uint32_t>(off));
    snprintf(n, sizeof n, "%s: step pulses", tag);
    expect(n, steps_seen.size() - s0, want_step ? 1u : 0u);
    snprintf(n, sizeof n, "%s: addend pulses", tag);
    expect(n, adj_seen.size() - a0, 1);
    if (adj_seen.size() > a0) {
      snprintf(n, sizeof n, "%s: addend matches the mirror", tag);
      expect(n, adj_seen.back(), adj_bits(svm.addend));
      const int64_t a = static_cast<int32_t>(adj_seen.back());
      snprintf(n, sizeof n, "%s: addend inside the envelope", tag);
      expect(n, a <= SV_AMAX && a >= -SV_AMAX, 1);
    }
    if (want_step && steps_seen.size() > s0 && adj_seen.size() > a0) {
      snprintf(n, sizeof n, "%s: step carries -offset", tag);
      expect(n, steps_seen.back(), static_cast<uint64_t>(-off));
      snprintf(n, sizeof n, "%s: step pulse precedes its addend", tag);
      expect(n, step_cyc.back() < adj_cyc.back(), 1);
      snprintf(n, sizeof n, "%s: step data holds after the pulse", tag);
      expect(n, dut->phc_step_o, steps_seen.back());
    }
    snprintf(n, sizeof n, "%s: sync-ok raised", tag);
    expect(n, dut->pub_flags_o & FL_SYNCOK, FL_SYNCOK);
  }

  // an announce carrying {p1, gmid, steps} from `src`
  void announce(uint16_t seq, uint8_t p1, uint64_t gmid,
                uint16_t steps, uint64_t src) {
    // 802.1AS-2011 10.5.3.3.4: N=stepsRemoved+1. These BTCA helpers use a
    // canonical path headed by GM and ending at the announcing source.
    std::vector<uint64_t> path;
    path.push_back(gmid);
    for (uint16_t i = 1; i < steps; i++)
      path.push_back(0x00A000FFFE000000ull + i);
    if (steps != 0) path.push_back(src);
    const uint16_t tlv = static_cast<uint16_t>(4 + 8 * path.size());
    Frame a = ptp(0xB, seq, 0, 0x0008, static_cast<uint16_t>(30 + tlv), src);
    for (int i = 0; i < 10; i++) a.u8(0);
    a.u16(0xFFC4); a.u8(0);
    a.u8(p1); a.u32(OUR_CQ); a.u8(248);
    a.u64(gmid);
    a.u16(steps); a.u8(0xA0);
    a.u16(0x0008); a.u16(static_cast<uint16_t>(8 * path.size()));
    for (uint64_t hop : path) a.u64(hop);
    send_frame(a.b, 5000000);
    run(6000);
  }

  // an announce carrying {p1, gmid, steps} from `src` with a path trace TLV
  // (802.1AS-2011 10.5.3.3: tlvType 0x0008, one clockIdentity per hop);
  // an empty path omits the TLV, unless `empty_tlv` asks for a zero-length
  // one, an empty pathSequence (#88)
  void send_announce(uint16_t seq, uint8_t p1, uint64_t gmid,
                     uint16_t steps, uint64_t src,
                     const std::vector<uint64_t> &path, uint64_t rx_ts,
                     bool empty_tlv = false) {
    const bool has_tlv = !path.empty() || empty_tlv;
    uint16_t tlv = has_tlv ? static_cast<uint16_t>(4 + 8 * path.size()) : 0;
    Frame a = ptp(0xB, seq, 0, 0x0008, static_cast<uint16_t>(30 + tlv), src);
    for (int i = 0; i < 10; i++) a.u8(0);
    a.u16(0xFFC4); a.u8(0);
    a.u8(p1); a.u32(OUR_CQ); a.u8(248);
    a.u64(gmid);
    a.u16(steps); a.u8(0xA0);
    if (has_tlv) {
      a.u16(0x0008); a.u16(static_cast<uint16_t>(8 * path.size()));
      for (uint64_t hop : path) a.u64(hop);
    }
    send_frame(a.b, rx_ts);
    run_svc(6000);
  }

  uint64_t fld48(const std::vector<uint8_t> &f, size_t o) {
    uint64_t v = 0; for (int i = 0; i < 6; i++) v = (v << 8) | f[o + i];
    return v;
  }
  uint64_t fld64(const std::vector<uint8_t> &f, size_t o) {
    uint64_t v = 0; for (int i = 0; i < 8; i++) v = (v << 8) | f[o + i];
    return v;
  }
  uint32_t fld32(const std::vector<uint8_t> &f, size_t o) {
    return (f[o] << 24) | (f[o + 1] << 16) | (f[o + 2] << 8) | f[o + 3];
  }
  uint16_t fld16(const std::vector<uint8_t> &f, size_t o) {
    return static_cast<uint16_t>((f[o] << 8) | f[o + 1]);
  }

  //! Verilator exposes the 8x64 flattened publication as little-endian
  //! 32-bit words. Keep this oracle outside the RTL's indexing expression.
  uint64_t pub_path_entry(unsigned k) {
    return static_cast<uint64_t>(dut->pub_path_o[2 * k])
         | (static_cast<uint64_t>(dut->pub_path_o[2 * k + 1]) << 32);
  }
  //! entry 0, the head of pathTrace: the received head, or thisClock
  uint64_t pub_path_head() { return pub_path_entry(0); }
  //! tail slot `slot` is entry slot + 1
  uint64_t pub_path_tail(unsigned slot) { return pub_path_entry(slot + 1); }

  //! #82: the committed path is exactly `path`, from entry 0, with every
  //! inactive entry zero. {thisClock} is count one, thisClock at entry 0.
  static bool committed_path_is(const PubSnap &s,
                                const std::vector<uint64_t> &path) {
    bool same = !path.empty() && s.count == path.size() &&
                s.head == path[0];
    for (unsigned k = 0; k < PATH_TAIL_SLOTS; k++)
      same &= s.tail[k] == (k + 1 < path.size() ? path[k + 1] : 0);
    return same;
  }

  //! #85, #88: the pathTrace a present path trace TLV leaves published, as
  //! 802.1AS-2011 10.3.10.2.1 d) states it: the received pathSequence, its
  //! head included, with thisClock appended, bounded to the first eight
  //! entries, all the publication carries. An empty one gives {thisClock}.
  //! Without a TLV, d) writes nothing: each probe names the kept path.
  static std::vector<uint64_t> path_trace_of(std::vector<uint64_t> received) {
    received.push_back(OUR_CID);
    if (received.size() > 8) received.resize(8);
    return received;
  }

  //! the first commit sampled at or after index `mark`, if one landed
  const PubSnap *first_commit_since(size_t mark) const {
    return commit_snaps.size() > mark ? &commit_snaps[mark] : nullptr;
  }

  void check_common(const char *tag, const std::vector<uint8_t> &f,
                    uint8_t mtype, uint16_t flags, int msglen,
                    uint8_t logint) {
    char n[64];
    // 802.1AS-2011 Table 11-7: Sync and Follow_Up have their own control
    // values; Announce and every Pdelay message use the delay-management
    // value. Keep this oracle independent from the µcode header builder.
    //
    // The caller's `flags` is checked byte-exact for the same reason. For
    // the five Ethernet messages of 11.4.1 that value comes from 11.4.2.3
    // and Table 11-4, which override the common flags field of 10.5.2.2.6:
    // twoStepFlag for Sync and Pdelay_Resp, every other bit FALSE. Announce
    // is outside that list and keeps the common ptpTimescale. The whole
    // transmitted set is swept once more in
    // hold_the_media_dependent_transmit_flags below (#64).
    uint8_t control = 0x05;
    if (mtype == 0x0) control = 0x00;
    if (mtype == 0x8) control = 0x02;
    if (static_cast<int>(f.size()) != 14 + msglen) {
      snprintf(n, 64, "%s size", tag);
      expect(n, f.size(), static_cast<uint64_t>(14 + msglen));
      return;
    }
    snprintf(n, 64, "%s DA", tag);     expect(n, fld48(f, 0), 0x0180C200000Eull);
    snprintf(n, 64, "%s SA", tag);     expect(n, fld48(f, 6), OUR_MAC);
    snprintf(n, 64, "%s type", tag);   expect(n, f[14], 0x10 | mtype);
    snprintf(n, 64, "%s len", tag);    expect(n, fld16(f, 16), msglen);
    snprintf(n, 64, "%s flags", tag);  expect(n, fld16(f, 20), flags);
    snprintf(n, 64, "%s srcCID", tag); expect(n, fld64(f, 34), OUR_CID);
    snprintf(n, 64, "%s srcPN", tag);  expect(n, fld16(f, 42), 1);
    snprintf(n, 64, "%s control", tag); expect(n, f[46], control);
    snprintf(n, 64, "%s logint", tag); expect(n, f[47], logint);
  }



  // ---- what one phase records for a later phase to read --------------------
  //! the first commit index after the cold reset, the cycle of the first
  //! clock edge out of it, and the cycle the first timer beat's Pdelay_Req
  //! completed: the interval phase 1d grades
  size_t cold_boot_mark = 0;
  uint64_t cold_release_cyc = 0;
  uint64_t boot_beat_cyc = 0;
  //! phase 1's boot Pdelay_Req: the transmit slot whose egress timestamp is
  //! still outstanding through phase 1c, and the stamp finally returned for it
  size_t our_req_idx = 0;
  uint64_t T1 = 0;
  //! phase 3's peer-initiated exchange: its ingress and turnaround stamps,
  //! the time base phases 3a..3d keep sending against
  uint64_t T2R = 0;
  uint64_t T3R = 0;
  //! phase 7b's pinned publication, refreshed once the paired Follow_Up
  //! computes, so the probes after it compare against the new baseline
  uint32_t pd0 = 0;
  uint32_t fl0 = 0;
  //! phase 8's published raw announce vector, re-read by phase 8b
  uint64_t ANNQ8 = 0;
  //! phase 9's adopted grandmaster and the announcer that loses to it: both
  //! are still named by the BTCA, overload and cease phases that follow
  uint64_t GMID = 0;
  uint64_t WORSE_GM = 0;
  uint64_t WORSE_SRC = 0;
  uint64_t PATH_B1 = 0;
  uint64_t PATH_C1 = 0;
  uint64_t Q_C1 = 0;
  std::vector<uint64_t> Q_PATH_C;
  //! phases 10..14's sync fixture: the ingress and origin stamps, the
  //! correctionField they carry, and the offsets they must produce
  uint64_t TRX = 0;
  uint64_t ORIGIN = 0;
  uint64_t CORR_NS = 0;
  uint64_t OFF = 0;
  uint64_t TRX2 = 0;
  uint64_t ORIGIN2 = 0;
  uint64_t OFF2 = 0;
  //! phase 16's ingress stamp, still the time base of phases 17 and 21
  uint64_t TRX6 = 0;
  //! phase 21b's newcomer, re-checked by 21c and 21d
  uint64_t NEWGM = 0;
  uint64_t NEWSRC = 0;
  //! phase 32's two held peer requests: the sequenceIds, the requesting
  //! clockIdentities and portNumbers, and the boundary stamps returned
  static constexpr uint16_t Q1 = 0x1111;
  static constexpr uint16_t Q2 = 0x2222;
  static constexpr uint64_t C1 = PEER_CID;
  static constexpr uint64_t C2 = NEAR_CID;
  static constexpr uint16_t P1 = 1;
  static constexpr uint16_t P2 = 2;
  static constexpr uint64_t TS1 = 8100111ull;
  static constexpr uint64_t TS2 = 8200222ull;

  void bring_the_engine_out_of_reset() {
    dut->rst_n = 0;
    dut->rx_valid_i = 0; dut->rx_sof_i = 0; dut->rx_eof_i = 0;
    dut->rx_err_i = 0; dut->rx_data_i = 0; dut->rx_ts_i = 0;
    dut->tx_ready_i = 1;
    ts_offer = false;
    drive_result_face();
    dut->tx_credit_i = 1;
    for (int i = 0; i < 8; i++) tick();
    //! ready is low through reset: a beat the engine would not record must
    //! not look accepted to the producer
    expect("reset holds the result face closed", dut->txts_ready_o, 0);
    expect("slew: cold reset clears the level", dut->phc_slew_active_o, 0);
    dut->rst_n = 1;
    cold_boot_mark = commit_snaps.size();
    cold_release_cyc = cyc;
    boot_watch = true;                     // until the first beat (phase 1)
    run(2);                                // the boot commit is behind us

    // Before the ROM init leg has written S_CID, no complete all-hop loop
    // comparison is possible. A first-event over-cap Announce with our identity
    // only beyond the retained public window must therefore be refused, not
    // queued in hope that the mirror appears before dispatch.
    {
      const uint16_t d0 = dut->dbg_rx_drop_o;
      const size_t c0 = commit_snaps.size();
      std::vector<uint64_t> path = {0x00C001FFFE000001ull};
      for (unsigned i = 1; i < 8; i++)
        path.push_back(0x00C0010000000000ull + i);
      path.push_back(OUR_CID);
      send_announce(0xC001, 1, path[0], 8, PEER_CID, path, 1000);
      expect("pre-init deep Announce: no commit", commit_snaps.size(), c0);
      expect("pre-init deep Announce: parser refusal", dut->dbg_rx_drop_o,
             static_cast<uint16_t>(d0 + 1));
      expect("pre-init deep Announce: GM stays thisClock", dut->pub_gm_id_o,
             OUR_CID);
    }
  }

  // ---- 1: our Pdelay_Req; asCapable must start low ----------------------
  void check_the_boot_pdelay_request() {
    std::vector<uint8_t> req = wait_tx(0x2, 3200000);
    boot_watch = false;                    // phase 1d grades up to here
    boot_beat_cyc = cyc;
    our_req_idx = txf.empty() ? 0 : txf.size() - 1;
    if (!req.empty()) {
      check_common("pdreq", req, 0x2, 0x0000, 54, 0x00);
      uint64_t z = 0;
      for (int i = 48; i < 68; i++) z |= req[i];
      expect("pdreq body zero", z, 0);
    }
    expect("asCapable low at boot", dut->pub_flags_o & FL_ASCAP, 0);
    T1 = 1000000ull;
  }

  // ---- 1d: #82 -- before any peer the plane is its own grandmaster -----
  // 802.1AS-2020 10.3.13.2.4 b): with no port vector, gmPriority is the
  // systemPriorityVector, so thisClock is the grandmaster, and i) makes
  // pathTrace {thisClock}, and g) sets gmPresent from that vector's
  // priority1. That holds from reset release, not from the first
  // one-second beat, whose init leg is the first microcode to run. So
  // every cycle from release to that beat is graded, and so is the one
  // commit a consumer needs to copy the bank: exactly one in the interval,
  // on the first clock edge out of reset, carrying all three
  void publish_thisclock_before_any_peer() {
    printf("INFO #82 cold release graded for %llu cycles to the first beat\n",
           static_cast<unsigned long long>(boot_cycles));
    expect("#82 cold release: every cycle to the first beat names thisClock",
           boot_bad_gm, 0);
    expect("#82 cold release: every cycle to the first beat has {thisClock}",
           boot_bad_path, 0);
    expect("#82 cold release: every cycle to the first beat has gmPresent",
           boot_bad_present, 0);
    size_t n = 0;
    const PubSnap *s = nullptr;
    for (size_t i = cold_boot_mark; i < commit_snaps.size(); i++)
      if (commit_snaps[i].cyc < boot_beat_cyc) {
        n++;
        if (!s) s = &commit_snaps[i];
      }
    expect("#82 cold release: one commit before the first beat", n, 1);
    expect("#82 cold release: that commit is the first edge after release",
           s ? s->cyc - cold_release_cyc : ~0ull, 0);
    expect("#82 cold release: that commit carries thisClock and {thisClock}",
           s && s->gm == OUR_CID && committed_path_is(*s, {OUR_CID}), 1);
    expect("#82 cold release: that commit's flags are gmPresent alone",
           s ? s->flags : ~0u, self_present);
  }

  // ---- 1a: a self-sourced Pdelay_Req draws nothing -----------------------
  // IEEE 1588-2008 9.5.2.2: "A message received at the same port that
  // issued the message shall be ignored", compared on sourcePortIdentity
  // against the port's own portIdentity (its Table 17). 802.1AS-2011
  // Figure 11-9 (MDPdelayResp) carries no such condition, so 9.5.2.2 is
  // the whole mandate on this side (#26). The window is chosen, not
  // incidental: the boot Pdelay_Req is still waiting for its egress
  // timestamp, which is exactly when a reflection of it arrives, and
  // answering steals that timestamp through the shared S_PEND cell
  // (#28), so phase 2's published delay below is this phase's real
  // oracle: 600 if the request was ignored, 500,600 if it was answered.
  // No counter moves, because the refusal is in the ucode and
  // dbg_rx_drop_o counts what the parser refused
  void ignore_a_self_sourced_pdelay_request() {
    size_t mark = txf.size();
    uint16_t drops = dut->dbg_rx_drop_o;
    uint32_t flags0 = dut->pub_flags_o;
    Frame q = ptp(0x2, 0x9901, 0, 0x0000, 20, OUR_CID);
    q.u64(0); q.u16(0); q.ts(0);
    q.b.resize(68);
    send_frame(q.b, T1 - 1000);
    run(8000);
    int resps = 0;
    for (size_t i = mark; i < txf.size(); i++)
      if (txf[i].size() > 14 && (txf[i][14] & 0xF) == 0x3) resps++;
    expect("self-sourced request: no Pdelay_Resp", resps, 0);
    expect("self-sourced request: no frame at all", txf.size(), mark);
    expect("self-sourced request: not a parser drop", dut->dbg_rx_drop_o,
           drops);
    expect("self-sourced request: flags unmoved", dut->pub_flags_o, flags0);
  }

  // ---- 1c: peer requests inside our own request's outstanding interval --
  // Our Pdelay_Req is out and its egress timestamp has not come back, so
  // the plane owes itself a stamp for the whole of this interval. A peer
  // running its own cadence sends into that interval, we answer, and the
  // answer must not divert the stamp our request is waiting for
  // (FPGA-gPTP #28). The leads are spread across the interval rather
  // than bunched at its edge, because the interval is not a few cycles:
  // the steal was measured at leads from 0 to 1,000,000 cycles, so a
  // single near-boundary case would look the same whether a fix closed
  // the whole interval or only its last cycles.
  //
  // The last response's stamp is then returned BEFORE our request's,
  // which is the discriminating case: positional matching, crediting
  // stamps in hand-over order, gives that stamp to our request and this
  // phase goes red. Matching by the sequenceId the stamper reports does
  // not care what order they arrive in.
  void answer_peer_requests_across_our_pending_stamp() {
    uint16_t drops_1c = 0;
    const uint64_t P3_TS = 850000ull;
    size_t p3_idx = 0;
    uint16_t p3_seq = 0;
    {
      const std::array<long, 3> leads = {10, 2000, 200000};
      const std::array<uint64_t, 3> response_ts =
          {810000ull, 830000ull, P3_TS};
      size_t mark = txf.size();
      drops_1c = dut->dbg_rx_drop_o;
      int n = 0;
      for (long lead : leads) {
        run(static_cast<uint64_t>(lead));
        p3_seq = static_cast<uint16_t>(0x9900 + n);
        size_t response_mark = txf.size();
        Frame q = ptp(0x2, p3_seq, 0, 0x0000, 20, PEER_CID);
        q.u64(0); q.u16(0); q.ts(0);
        q.b.resize(68);
        send_frame(q.b, 900000 + 1000 * n);
        run(4000);
        bool seen = false;
        for (size_t i = response_mark; i < txf.size(); i++)
          if (type_of(txf[i]) == 0x3 && seq_of(txf[i]) == p3_seq) {
            p3_idx = i;
            seen = true;
          }
        expect("peer request across our window: response sent",
               seen ? 1 : 0, 1);
        // One response context is intentionally live at a time. Retire the
        // first two before presenting the next request; the third remains
        // outstanding for the response-before-request-stamp ordering below.
        if (seen && n < 2) {
          size_t fu_mark = txf.size();
          txts_idx(p3_idx, response_ts[n]);
          run(8000);
          bool fu_seen = false;
          for (size_t i = fu_mark; i < txf.size(); i++)
            if (type_of(txf[i]) == 0xA && seq_of(txf[i]) == p3_seq)
              fu_seen = true;
          expect("peer request across our window: Follow_Up sent",
                 fu_seen ? 1 : 0, 1);
        }
        n++;
      }
      int resps = 0;
      for (size_t i = mark; i < txf.size(); i++)
        if (txf[i].size() > 14 && (txf[i][14] & 0xF) == 0x3) {
          resps++;
          p3_idx = i;
        }
      // Three requests still draw three Pdelay_Resps, but a later request is
      // not allowed to overwrite live response context: the first two claims
      // are retired above and the last remains pending for the ordering probe.
      expect("peer requests across our window: three Pdelay_Resps", resps, 3);
      expect("peer requests across our window: none was a parser drop",
             dut->dbg_rx_drop_o, drops_1c);
    }
    {
      size_t mark = txf.size();
      txts_idx(p3_idx, P3_TS);            // the RESPONSE's stamp, returned
      run(8000);                          // before our own request's
      std::vector<uint8_t> u;
      for (size_t i = mark; i < txf.size(); i++)
        if (txf[i].size() > 14 && (txf[i][14] & 0xF) == 0xA) u = txf[i];
      expect("out-of-order stamp: the Resp_FU is built", u.empty() ? 0 : 1, 1);
      if (!u.empty()) {
        expect("out-of-order stamp: it pairs its own request",
               fld16(u, 44), p3_seq);
        expect("out-of-order stamp: it carries its own timestamp",
               fld48(u, 48) * 1000000000ull + fld32(u, 54), P3_TS);
      }
    }
  }

  void separate_claims_differing_only_in_the_sequence_high_byte() {
    const uint64_t P5_TS = 890000ull;
    size_t p5_idx = 0;
    // two claims outstanding whose tags differ ONLY in the high byte of
    // the sequenceId: ours is 0 and this request's is 0x0100. A compare
    // narrowed to the low 8 bits reads them as equal, gives this
    // response's stamp to our request and never builds the Resp_FU, and
    // every other tag pair in this suite differs in the low byte, so
    // without this case that narrowing survives untouched. It is the
    // same blindness the pinned txts_seq_i had: a field nothing varies
    // is a field nothing tests
    size_t mark = txf.size();
    Frame q = ptp(0x2, 0x0100, 0, 0x0000, 20, PEER_CID);
    q.u64(0); q.u16(0); q.ts(0);
    q.b.resize(68);
    send_frame(q.b, 904000);
    run(4000);
    for (size_t i = mark; i < txf.size(); i++)
      if (txf[i].size() > 14 && (txf[i][14] & 0xF) == 0x3) p5_idx = i;
    mark = txf.size();
    txts_idx(p5_idx, P5_TS);
    run(8000);
    std::vector<uint8_t> u;
    for (size_t i = mark; i < txf.size(); i++)
      if (txf[i].size() > 14 && (txf[i][14] & 0xF) == 0xA) u = txf[i];
    expect("high-byte-only difference: the Resp_FU is built",
           u.empty() ? 0 : 1, 1);
    if (!u.empty()) {
      expect("high-byte-only difference: it pairs its own request",
             fld16(u, 44), 0x0100);
      expect("high-byte-only difference: it carries its own timestamp",
             fld48(u, 48) * 1000000000ull + fld32(u, 54), P5_TS);
    }
  }

  void separate_equal_sequence_request_and_response_claims() {
    const uint64_t P4_TS = 870000ull;
    size_t p4_idx = 0;
    size_t p4_rfu_idx = 0;
    bool p4_rfu_seen = false;
    {
      // Both ends start their independent request counters at zero, so the
      // peer's request and our outstanding request have the SAME sequenceId.
      // Return the response's stamp first: sequenceId-only credit gives it
      // to our request, while {messageType, sequenceId} must build this
      // response's own Follow_Up and leave our request claim intact (#28).
      size_t mark = txf.size();
      Frame q = ptp(0x2, 0, 0, 0x0000, 20, PEER_CID);
      q.u64(0); q.u16(0); q.ts(0);
      q.b.resize(68);
      send_frame(q.b, 906000);
      run(4000);
      bool p4_seen = false;
      for (size_t i = mark; i < txf.size(); i++)
        if (txf[i].size() > 14 && (txf[i][14] & 0xF) == 0x3) {
          p4_idx = i;
          p4_seen = true;
        }
      expect("equal sequences: the request is still answered",
             p4_seen ? 1 : 0, 1);
      if (p4_seen)
        expect("equal sequences: its response carries our own sequence",
               fld16(txf[p4_idx], 44), 0);
      if (p4_seen) txts_idx(p4_idx, P4_TS);
      run(8000);
      std::vector<uint8_t> u;
      for (size_t i = mark; i < txf.size(); i++)
        if (txf[i].size() > 14 && (txf[i][14] & 0xF) == 0xA) {
          u = txf[i];
          p4_rfu_idx = i;
          p4_rfu_seen = true;
        }
      expect("equal sequences: response-first stamp builds the Resp_FU",
             u.empty() ? 0 : 1, 1);
      if (!u.empty()) {
        expect("equal sequences: Resp_FU carries the response stamp",
               fld48(u, 48) * 1000000000ull + fld32(u, 54), P4_TS);
      }
    }
    // A Resp_FU itself leaves no claim, but the boundary still stamps it.
    // Its sequence is also zero. That unclaimed type must not consume the
    // still-outstanding request claim. Phase 2's 600 ns result below is the
    // end-to-end oracle: sequence-only credit moves it far from 600 ns.
    if (p4_rfu_seen) {
      txts_idx(p4_rfu_idx, T1 + 110000);
      run(2000);                         // separate this from open #31
    }
    txts_idx(our_req_idx, T1);
    run(2000);
    tx_seen = txf.size();          // this phase's frames are accounted for
  }

  // ---- 1b: a Follow_Up for the boot request ahead of any Resp ----------
  // sequence 0 is the first request the plane sends (and recurs every
  // 65,536 requests): "armed with sequence 0" must differ from "nothing
  // armed". A never-armed pairing holds a zero responder identity, so
  // the forged frame carries exactly that identity: only the armed bit
  // can refuse it (FPGA-gPTP #8)
  void ignore_a_follow_up_for_the_boot_request() {
    Frame g = ptp(0xA, 0, 0, 0x0000, 20, 0);
    g.ts(T1 + 20000); g.u64(OUR_CID); g.u16(1);
    send_frame(g.b, T1 + 22200);
    run(6000);
    expect("boot Follow_Up before any Resp: pdelay unmoved",
           dut->pub_pdelay_ns_o, 0);
    expect("boot Follow_Up before any Resp: asCapable unmoved",
           dut->pub_flags_o & FL_ASCAP, 0);
  }

  // ---- 2: one good exchange (D = 600); not capable yet ------------------
  void compute_the_first_exchange_delay() {
    const uint64_t T2 = peer_ns(T1 + 300);
    const uint64_t T3 = T2 + 20000;
    const uint64_t T4 = T1 + 21200;
    {
      Frame f = ptp(0x3, 0, 0, 0x0200, 20);
      f.ts(T2); f.u64(OUR_CID); f.u16(1);
      send_frame(f.b, T4);
      run(4000);
      Frame g = ptp(0xA, 0, 0, 0x0000, 20);
      g.ts(T3); g.u64(OUR_CID); g.u16(1);
      send_frame(g.b, T4 + 1000);
      run(6000);
      model_exchange(T1, T2, T3, T4);
    }
    expect("pub pdelay ex1", dut->pub_pdelay_ns_o, static_cast<uint32_t>(pdm.d));
    expect("one exchange not capable", dut->pub_flags_o & FL_ASCAP, 0);
  }

  // ---- 2b: a Pdelay_Resp sourced from OUR clockIdentity is ignored ------
  // IEEE 1588-2008 9.5.2.2: "A message received at the same port that
  // issued the message shall be ignored", identified by comparing the
  // received sourcePortIdentity with the port's own portIdentity (its
  // Table 17). 802.1AS-2011 Figure 11-8 carries the same condition into
  // the MDPdelayReq machine, where asCapable is set only if
  // rcvdPdelayRespPtr->sourcePortIdentity.clockIdentity != thisClock. A
  // loop or a misconfigured bridge reflecting our own Pdelay_Req back at
  // us is not a neighbour, and one exchange has already completed here,
  // so an accepted pair would be the SECOND and would raise asCapable
  // (FPGA-gPTP #23). The pair is refused by nothing else: it answers the
  // outstanding sequenceId, carries our requestingPortIdentity, and its
  // delay lands near 700 ns, under the threshold
  void ignore_a_self_sourced_pdelay_response() {
    uint32_t fl0 = dut->pub_flags_o;
    uint32_t d0 = dut->pub_pdelay_ns_o;
    int c0 = pdm.count;
    uint16_t dr0 = dut->dbg_rx_drop_o;
    pd_seen = txf.size();
    pd_mode = PD_SELF;
    pd_self_sent = 0;
    auto_txts = true;                  // the cadence request needs its t1
    run_svc(2600000);
    expect("self-sourced pair: one was answered", pd_self_sent >= 1, 1);
    // sent is not the same as admitted: without this the three checks
    // below would pass vacuously if the frame were ever refused at the
    // parser instead, which is where it must NOT be refused, the parser
    // holding no identity of its own. The refusal is in the ucode, so
    // the parser's counter must not move
    expect("self-sourced pair: not a parser drop", dut->dbg_rx_drop_o, dr0);
    expect("self-sourced pair: asCapable unmoved",
           dut->pub_flags_o & FL_ASCAP, fl0 & FL_ASCAP);
    expect("self-sourced pair: pdelay unmoved", dut->pub_pdelay_ns_o, d0);
    expect("self-sourced pair: no exchange modelled", pdm.count, c0);
    pd_mode = PD_SKIP;
    pd_seen = txf.size();
    auto_txts = false;                 // phase 3 feeds its own timestamps
  }

  // ---- 3: peer initiates -> our Resp + Resp_FU --------------------------
  void answer_a_peer_initiated_exchange() {
    T2R = 2000000ull;
    T3R = 2050000ull;
    {
      Frame f = ptp(0x2, 0x55AA, 0, 0x0000, 20);
      f.u64(0); f.u16(0); f.ts(0);
      f.b.resize(68);
      send_frame(f.b, T2R);
    }
    std::vector<uint8_t> resp = wait_tx(0x3, 400000);
    if (!resp.empty()) {
      check_common("pdresp", resp, 0x3, 0x0200, 54, 0x7F);
      expect("pdresp seq", fld16(resp, 44), 0x55AA);
      expect("pdresp t2", fld48(resp, 48) * 1000000000ull + fld32(resp, 54),
             T2R);
      expect("pdresp reqCID", fld64(resp, 58), PEER_CID);
    }
    txts(T3R);
    std::vector<uint8_t> rfu = wait_tx(0xA, 400000);
    if (!rfu.empty()) {
      check_common("pdrfu", rfu, 0xA, 0x0000, 54, 0x7F);
      expect("pdrfu seq", fld16(rfu, 44), 0x55AA);
      expect("pdrfu t3", fld48(rfu, 48) * 1000000000ull + fld32(rfu, 54),
             T3R);
      expect("pdrfu reqCID", fld64(rfu, 58), PEER_CID);
    }
  }

  // ---- 3a: a requester whose identity nearly matches ours is answered ---
  // the refusal above compares all 64 bits of the clockIdentity. These
  // two requesters differ from ours in only one half each, so a compare
  // narrowed to the low half refuses the first and one narrowed to the
  // high half refuses the second: either way a genuine neighbour loses
  // its Pdelay_Resp and this phase goes red.
  //
  // Only FMT_D is a symmetric narrowing here. The ISA masks operand A
  // alone (KL_gptp_ucpu.sv:188-194; b_or_imm_w keeps all 64 bits), so
  // FMT_W and FMT_B make the compare unsatisfiable rather than narrow:
  // nothing is ever refused, this phase stays green, and the loss shows
  // in phase 1a instead, where the self-sourced request is answered
  void answer_a_requester_whose_identity_nearly_matches_ours() {
    struct Near {
      const char *tag;
      uint64_t cid;
      uint16_t seq;
      uint64_t rx;
      uint64_t tx;
    };
    const Near near[] = {
      {"low-half", NEAR_CID, 0x55B1, T2R + 20000, T3R + 20000},
      {"high-half", REQ_HI_CID, 0x55B2, T2R + 40000, T3R + 40000},
    };
    for (const Near &n : near) {
      Frame f = ptp(0x2, n.seq, 0, 0x0000, 20, n.cid);
      f.u64(0); f.u16(0); f.ts(0);
      f.b.resize(68);
      send_frame(f.b, n.rx);
      std::vector<uint8_t> r = wait_tx(0x3, 400000);
      char nm[80];
      snprintf(nm, sizeof nm, "%s requester: answered", n.tag);
      expect(nm, r.empty() ? 0 : 1, 1);
      if (!r.empty()) {
        snprintf(nm, sizeof nm, "%s requester: its sequence", n.tag);
        expect(nm, fld16(r, 44), n.seq);
        snprintf(nm, sizeof nm, "%s requester: its reqCID", n.tag);
        expect(nm, fld64(r, 58), n.cid);
      }
      txts(n.tx);
      std::vector<uint8_t> u = wait_tx(0xA, 400000);
      snprintf(nm, sizeof nm, "%s requester: Resp_FU pairs", n.tag);
      expect(nm, u.empty() ? 0 : static_cast<uint64_t>(fld16(u, 44)), n.seq);
    }
  }

  // ---- 3b: a foreign-domain Pdelay_Req draws no frame; domain 0 does ----
  // the responder is the wire-visible role, and Pdelay_Req is one of the
  // two header-only types whose min_ok_r is set regardless of bad_r, so
  // the parser's end-of-frame gate is the only barrier after the domain
  // arm: a gate that dropped the frame but still dispatched the event
  // would answer from the STALE bank. Domain 0x10 has a zero low nibble,
  // so a compare narrowed to four bits would admit it (FPGA-gPTP #6)
  void refuse_a_foreign_domain_pdelay_request() {
    uint16_t drops = dut->dbg_rx_drop_o;
    size_t mark = txf.size();
    Frame f = ptp(0x2, 0x55AB, 0, 0x0000, 20);
    f.b[18] = 0x10;                              // domainNumber, byte 4
    f.u64(0); f.u16(0); f.ts(0);
    f.b.resize(68);
    send_frame(f.b, T2R + 100000);
    run(4000);
    int resps = 0;
    for (size_t i = mark; i < txf.size(); i++)
      if (txf[i].size() > 14 && (txf[i][14] & 0xF) == 0x3) resps++;
    expect("foreign-domain request: no Pdelay_Resp", resps, 0);
    expect("foreign-domain request: dropped and counted",
           dut->dbg_rx_drop_o, static_cast<uint16_t>(drops + 1));
    tx_seen = txf.size();
    Frame g = ptp(0x2, 0x55AC, 0, 0x0000, 20);   // domain 0, right after
    g.u64(0); g.u16(0); g.ts(0);
    g.b.resize(68);
    send_frame(g.b, T2R + 200000);
    std::vector<uint8_t> r2 = wait_tx(0x3, 400000);
    if (!r2.empty()) {
      expect("domestic request after it: answered", fld16(r2, 44), 0x55AC);
      expect("domestic request after it: reqCID", fld64(r2, 58), PEER_CID);
    }
    txts(T3R + 200000);
    std::vector<uint8_t> u2 = wait_tx(0xA, 400000);
    if (!u2.empty())
      expect("domestic request after it: Resp_FU pairs", fld16(u2, 44),
             0x55AC);
  }

  // ---- 3c: a truncated Pdelay_Req draws no frame; a complete one does ---
  // 802.1AS-2011 11.4.5 / Table 11-11: a Pdelay_Req is 54 octets, the
  // header and two reserved 10-octet fields; until #12 the parser's
  // minimum was the 34-octet header, so a header-only request dispatched
  // and the responder answered it from that header. Three shapes in turn:
  // header-only (messageLength 34 in a 48-byte frame, the issue's shape,
  // refused at the messageLength byte ahead of every bank write), a
  // declared 54 cut at 53 octets (refused at the end-of-frame gate), then
  // the complete request. The first two draw no Pdelay_Resp over the
  // window and count one drop each; the third is answered with its own
  // sequence and its Resp_FU, so the refusals left the responder intact
  void refuse_a_truncated_pdelay_request() {
    uint16_t drops = dut->dbg_rx_drop_o;
    size_t mark = txf.size();
    Frame f = ptp(0x2, 0x55AD, 0, 0x0000, 0);      // 34 octets: header only
    send_frame(f.b, T2R + 300000);
    run(4000);
    Frame g = ptp(0x2, 0x55AE, 0, 0x0000, 20);
    g.u64(0); g.u16(0); g.ts(0);
    g.b.resize(67);                                // declared 54, cut at 53
    send_frame(g.b, T2R + 350000);
    run(4000);
    int resps = 0;
    for (size_t i = mark; i < txf.size(); i++)
      if (txf[i].size() > 14 && (txf[i][14] & 0xF) == 0x3) resps++;
    expect("truncated requests: no Pdelay_Resp", resps, 0);
    expect("truncated requests: dropped and counted", dut->dbg_rx_drop_o,
           static_cast<uint16_t>(drops + 2));
    tx_seen = txf.size();
    Frame k = ptp(0x2, 0x55AF, 0, 0x0000, 20);     // the complete request
    k.u64(0); k.u16(0); k.ts(0);
    k.b.resize(68);
    send_frame(k.b, T2R + 400000);
    std::vector<uint8_t> r3 = wait_tx(0x3, 400000);
    if (!r3.empty()) {
      expect("complete request after them: answered", fld16(r3, 44), 0x55AF);
      expect("complete request after them: reqCID", fld64(r3, 58), PEER_CID);
    }
    txts(T3R + 400000);
    std::vector<uint8_t> u3 = wait_tx(0xA, 400000);
    if (!u3.empty())
      expect("complete request after them: Resp_FU pairs", fld16(u3, 44),
             0x55AF);
  }

  // ---- 3d: an unlisted messageType draws nothing and is counted --------
  // 802.1AS-2011 Tables 10-5 and 11-3 name the seven messageType values
  // a gPTP port carries, and the NOTE under Table 11-3 says the others
  // "are not used in this standard": IEEE 1588-2008 Table 19 assigns
  // three of them to Delay_Req, Delay_Resp and Management and reserves
  // the rest. None has a handler here. Until
  // #22 the parser admitted any of them with a valid header and the
  // engine's entry table sent the resulting code-0 event to the timer
  // program at 512, whose slot came from the descriptor's low bits: slot
  // 0 is the cadence leg, so a type-0x1 frame drew a Pdelay_Req off the
  // 11.5.2.2 interval and walked the lost-response count, and as master
  // slot 1 emitted a Sync. The three shapes the issue names, each an
  // otherwise valid 44-octet frame: the window is proven quiet first, no
  // frame at all leaves the lane after them, each counts one drop, and
  // the flags do not move. Phase 4 then earns asCapable as before, so
  // the refusals cannot pass by having deafened the plane.
  void refuse_an_unlisted_message_type() {
    size_t pre = txf.size();
    run(4000);
    expect("unlisted types: the window starts quiet", txf.size(), pre);
    size_t mark = txf.size();
    uint16_t drops = dut->dbg_rx_drop_o;
    uint32_t flags0 = dut->pub_flags_o;
    const std::array<uint8_t, 3> unlisted = {0x1, 0xD, 0xF};
    for (uint8_t mt : unlisted) {
      Frame f = ptp(mt, static_cast<uint16_t>(0x56A0 + mt), 0, 0x0000, 10);
      f.ts(0);
      send_frame(f.b, T2R + 450000);
      run(4000);
    }
    expect("unlisted types: no frame transmitted", txf.size(), mark);
    expect("unlisted types: dropped and counted", dut->dbg_rx_drop_o,
           static_cast<uint16_t>(drops + 3));
    expect("unlisted types: flags unmoved", dut->pub_flags_o, flags0);
  }

  // ---- 4: the live peer raises asCapable on the SECOND exchange ---------
  void raise_ascapable_on_the_second_exchange() {
    auto_txts = true;
    pd_seen = txf.size();                  // answer only fresh requests
    pd_mode = PD_NORMAL;
    expect("second exchange -> capable",
           wait_flags(FL_ASCAP, FL_ASCAP, 6000000ull), 1);
    expect("capable at two exchanges", pdm.count, 2);
    expect("pub pdelay corrected", dut->pub_pdelay_ns_o,
           static_cast<uint32_t>(pdm.d));
  }

  // ---- 5: announce receipt timeout -> become master ---------------------
  void become_master_on_announce_receipt_timeout() {
    expect("became master",
           wait_flags(FL_AMGM, FL_AMGM, 12000000ull), 1);
    run(200);  // raw words move before COMMIT; grade the complete transaction
    expect("master flags", dut->pub_flags_o & 7,
           self_present | FL_AMGM | FL_ASCAP);
    expect("#84 first mastership: the master flags carry sync-ok",
           dut->pub_flags_o & 0xF,
           self_present | FL_AMGM | FL_ASCAP | FL_SYNCOK);
    expect("gm is us", dut->pub_gm_id_o, OUR_CID);
    expect("self path has one entry", dut->pub_path_count_o, 1);
    expect("self path entry 0 is thisClock", pub_path_head(), OUR_CID);
    for (unsigned k = 0; k < PATH_TAIL_SLOTS; k++) {
      char n[64]; snprintf(n, sizeof(n), "self path tail %u is zero", k);
      expect(n, pub_path_tail(k), 0);
    }
  }

  // ---- 6: our Announce ---------------------------------------------------
  void check_our_announce() {
    tx_seen = txf.size();
    std::vector<uint8_t> ann = wait_tx(0xB, 400000);
    if (!ann.empty()) {
      check_common("ann", ann, 0xB, 0x0008, 76, 0x00);
      expect("ann utc", fld16(ann, 58), 37);
      expect("ann p1", ann[61], 248);
      expect("ann cq", fld32(ann, 62), OUR_CQ);
      expect("ann p2", ann[66], 248);
      expect("ann gmid", fld64(ann, 67), OUR_CID);
      expect("ann steps", fld16(ann, 75), 0);
      expect("ann tsrc", ann[77], 0xA0);
      expect("ann tlv", fld32(ann, 78), 0x00080008);
      expect("ann path0", fld64(ann, 82), OUR_CID);
    }
  }

  // ---- 7: our Sync + Follow_Up ------------------------------------------
  void check_our_sync_and_follow_up() {
    size_t sidx = 0;
    std::vector<uint8_t> sy = wait_tx(0x0, 800000, &sidx);
    uint16_t sseq = 0;
    if (!sy.empty()) {
      check_common("sync", sy, 0x0, 0x0200, 44, 0xFD);
      uint8_t reserved = 0;
      for (int i = 48; i < 58; i++) reserved |= sy[i];
      expect("sync reserved body zero", reserved, 0);
      sseq = fld16(sy, 44);
    }
    // wait_tx returns on the frame's EOF, one tick before the automatic
    // boundary-stamp helper would return its stamp. Hold this Sync claim,
    // then make a peer request with the SAME sequenceId. The response's
    // stamp arrives first and must build a Resp_FU, not a Sync Follow_Up.
    expect("sync collision: stamp is pending", auto_pend, static_cast<int>(sidx));
    auto_txts = false;
    auto_pend = -1;
    size_t collision_mark = txf.size();
    Frame same = ptp(0x2, sseq, 0, 0x0000, 20, PEER_CID);
    same.u64(0); same.u16(0); same.ts(0);
    same.b.resize(68);
    send_frame(same.b, phc() + 1000);
    run(8000);
    size_t collision_resp_idx = 0;
    bool collision_resp_seen = false;
    for (size_t i = collision_mark; i < txf.size(); i++)
      if (type_of(txf[i]) == 0x3) {
        collision_resp_idx = i;
        collision_resp_seen = true;
      }
    expect("sync collision: equal-sequence request answered",
           collision_resp_seen ? 1 : 0, 1);

    const uint64_t RESP_COLLISION_TS = 7110000ull;
    size_t response_stamp_mark = txf.size();
    if (collision_resp_seen)
      txts_idx(collision_resp_idx, RESP_COLLISION_TS);
    run(8000);
    size_t collision_rfu_idx = 0;
    bool collision_rfu_seen = false;
    int premature_sync_fu = 0;
    for (size_t i = response_stamp_mark; i < txf.size(); i++) {
      if (type_of(txf[i]) == 0xA) {
        collision_rfu_idx = i;
        collision_rfu_seen = true;
        expect("sync collision: Resp_FU carries response stamp",
               fld48(txf[i], 48) * 1000000000ull + fld32(txf[i], 54),
               RESP_COLLISION_TS);
      }
      if (type_of(txf[i]) == 0x8) premature_sync_fu++;
    }
    expect("sync collision: response stamp builds Resp_FU",
           collision_rfu_seen ? 1 : 0, 1);
    expect("sync collision: response stamp does not build Sync FU",
           premature_sync_fu, 0);

    // The emitted Resp_FU is stamped too, but leaves no claim. Its type-A
    // stamp shares the sequenceId and must not consume the pending Sync.
    if (collision_rfu_seen) {
      txts_idx(collision_rfu_idx, RESP_COLLISION_TS + 1000);
      run(2000);                                // avoid open buffering #31
    }
    const uint64_t SYNC_COLLISION_TS = 7220000ull;
    size_t sync_stamp_mark = txf.size();
    if (!sy.empty()) txts_idx(sidx, SYNC_COLLISION_TS);
    run(8000);
    std::vector<uint8_t> fu;
    for (size_t i = sync_stamp_mark; i < txf.size(); i++)
      if (type_of(txf[i]) == 0x8) fu = txf[i];
    expect("sync collision: own stamp still builds Sync FU",
           fu.empty() ? 0 : 1, 1);
    if (!fu.empty()) {
      check_common("syncfu", fu, 0x8, 0x0000, 76, 0xFD);
      expect("syncfu seq", fld16(fu, 44), sseq);
      expect("syncfu origin", fld48(fu, 48) * 1000000000ull + fld32(fu, 54),
             SYNC_COLLISION_TS);
      expect("syncfu tlv", fld32(fu, 58), 0x0003001C);
      expect("syncfu org", fld48(fu, 62), 0x0080C2000001ull);
    }
    auto_txts = true;
    pd_seen = txf.size();
  }

  // rpn is requestingPortIdentity.portNumber: ours unless a probe
  // addresses the frame to another port of this clock. `flags` is
  // 11.4.2.3's transmitted value by default; a probe passes another only
  // to prove the receiver ignores those bits (11.4.1)
  void resp(uint16_t s, uint64_t src, uint64_t t2v, uint64_t rx,
            uint16_t rpn = OUR_PN, uint64_t rcid = OUR_CID,
            uint16_t flags = 0x0200) {
    Frame f = ptp(0x3, s, 0, flags, 20, src);
    f.ts(t2v); f.u64(rcid); f.u16(rpn);
    send_frame(f.b, rx);
    run(2000);
  }

  void rfu(uint16_t s, uint64_t src, uint64_t t3v, uint64_t rx,
           uint16_t rpn = OUR_PN, uint64_t rcid = OUR_CID,
           uint16_t flags = 0x0000) {
    Frame g = ptp(0xA, s, 0, flags, 20, src);
    g.ts(t3v); g.u64(rcid); g.u16(rpn);
    send_frame(g.b, rx);
    run(6000);
  }

  // the completion path can only touch asCapable (the ladder and the
  // threshold verdict), so that is the bit pinned; the role bits are
  // the announce machinery's and move on their own cadence
  void unmoved(const char *tag) {
    char n[96];
    snprintf(n, 96, "%s: pdelay unmoved", tag);
    expect(n, dut->pub_pdelay_ns_o, pd0);
    snprintf(n, 96, "%s: asCapable unmoved", tag);
    expect(n, dut->pub_flags_o & FL_ASCAP, fl0 & FL_ASCAP);
  }

  // ---- 7b: a Pdelay_Resp_Follow_Up pairs with one Pdelay_Resp only ------
  // 802.1AS-2011 11.2.15.3 (Figure 11-8): a Pdelay_Resp is taken only
  // when it answers the OUTSTANDING request (its sequenceId, our
  // requestingPortIdentity), and a Pdelay_Resp_Follow_Up only when it
  // carries that sequenceId and comes from that responder; everything
  // else is ignored and neither neighborPropDelay nor the ladder moves.
  // The auto-peer is silenced so every frame is hand-built against the
  // DUT's own request; a wrongly consumed Follow_Up carries a t3 skewed
  // +2 us, so the published delay would move by -1 us and the verdict
  // would fall below the Milan floor (FPGA-gPTP #8)
  void pair_a_follow_up_only_with_the_outstanding_resp() {
    const uint64_t STRANGER = 0x00BAD0FFFE000002ull;
    pd_mode = PD_SKIP;
    tx_seen = txf.size();
    std::vector<uint8_t> rq = wait_tx(0x2, 4000000);
    expect("7b: a request to pair against", !rq.empty(), 1);
    uint16_t seq = rq.empty() ? 0 : fld16(rq, 44);
    size_t rqi = tx_seen - 1;
    for (int k = 0; k < 400 && txns[rqi] == 0; k++) tick();
    uint64_t t1 = txns[rqi];
    uint64_t t2 = peer_ns(t1 + 300), t3 = t2 + 20000, t4 = t1 + 21200;
    pd0 = dut->pub_pdelay_ns_o;
    fl0 = dut->pub_flags_o;
    // (i) a Follow_Up before any Pdelay_Resp: nothing is armed
    rfu(seq, PEER_CID, t3 + 2000, t4 + 1000);
    unmoved("Follow_Up before any Resp");
    // (ii) the parent campaign's probe: a stale sequenceId, our identity
    rfu(0xEEEE, PEER_CID, 1000, t4 + 1100);
    unmoved("stale-sequence Follow_Up");
    // (iii) a stale Resp + Follow_Up pair: the Resp answers nothing
    // outstanding, so it must not arm the pairing either
    resp(0xEEEE, PEER_CID, t2, t4);
    rfu(0xEEEE, PEER_CID, t3 + 2000, t4 + 1200);
    unmoved("stale-sequence Resp + Follow_Up pair");
    // (iii-b) a stale pair whose sequenceId differs from the outstanding
    // one in the HIGH byte only: a byte-wide sequence compare would arm
    resp(static_cast<uint16_t>(seq ^ 0x0100), PEER_CID, t2, t4);
    rfu(static_cast<uint16_t>(seq ^ 0x0100), PEER_CID, t3 + 2000, t4 + 1250);
    unmoved("high-byte-stale Resp + Follow_Up pair");
    // (iii-b2) the other half of the same identity, and the direction
    // FPGA-gPTP #30 found unpinned: a Pdelay_Resp addressed to a
    // NEIGHBOUR's requesting clockIdentity arms nothing. NEAR_CID shares
    // OUR_CID's low 32 bits, so a compare narrowed to that half admits
    // it; every genuine response in this suite carries our identity, so
    // nothing else here drives this direction
    resp(seq, PEER_CID, t2, t4, OUR_PN, NEAR_CID);
    rfu(seq, PEER_CID, t3 + 2000, t4 + 1280);
    unmoved("Resp at a neighbour's requesting clockIdentity");
    // (iii-c) Figure 11-8 qualifies the response on the WHOLE
    // requestingPortIdentity, clockIdentity AND portNumber. A response
    // right in every other respect -- the outstanding sequenceId, our
    // clockIdentity, the usual responder -- but addressed to another
    // port of this clock arms nothing, so the perfect Follow_Up behind
    // it pairs with nothing (FPGA-gPTP #36). The Follow_Up carries OUR
    // portNumber deliberately: with the arm on both messages, a pair
    // carrying the stranger's on both frames is refused by EITHER of
    // them and could not fail for the reason it names
    resp(seq, PEER_CID, t2, t4, FOREIGN_PN);
    rfu(seq, PEER_CID, t3 + 2000, t4 + 1260);
    unmoved("Resp at a foreign requesting portNumber");
    // (iv) the legitimate Resp arms the pairing; a Follow_Up with the
    // right sequenceId and our identity from ANOTHER source is not it
    resp(seq, PEER_CID, t2, t4);
    rfu(seq, STRANGER, t3 + 2000, t4 + 1300);
    unmoved("Follow_Up from another responder");
    // (iv-b) the engine's own hardening, its portNumber half: the
    // pairing is still armed from (iv)'s Resp and this Follow_Up carries
    // the armed sequenceId from the armed responder, so the requesting
    // portNumber is the only thing wrong with it. The compare lives in
    // the PDPOST leg rather than beside its clockIdentity half; see the
    // microcode comment there for the ROM-layout reason
    rfu(seq, PEER_CID, t3 + 2000, t4 + 1320, FOREIGN_PN);
    unmoved("Follow_Up at a foreign requesting portNumber");
    // (iv-c) the same hardening, its clockIdentity half, and the
    // direction FPGA-gPTP #30 measured as unpinned on THIS path: the
    // pairing is still armed from (iv)'s Resp and this Follow_Up carries
    // the armed sequenceId, the armed responder and OUR portNumber, so
    // the requesting clockIdentity is the only thing wrong with it.
    // NEAR_CID shares OUR_CID's low 32 bits, so a compare narrowed to
    // that half admits it, and (v) behind it is the retained valid
    // Follow_Up control that keeps this probe from passing vacuously
    rfu(seq, PEER_CID, t3 + 2000, t4 + 1340, OUR_PN, NEAR_CID);
    unmoved("Follow_Up at a neighbour's requesting clockIdentity");
    // (v) the paired Follow_Up still computes
    rfu(seq, PEER_CID, t3, t4 + 1400);
    model_exchange(t1, t2, t3, t4);
    expect("the paired Follow_Up computes", dut->pub_pdelay_ns_o,
           static_cast<uint32_t>(pdm.d));
    expect("the paired Follow_Up keeps capable",
           dut->pub_flags_o & FL_ASCAP, FL_ASCAP);
    pd0 = dut->pub_pdelay_ns_o;
    fl0 = dut->pub_flags_o;
    refuse_duplicate_and_superseded_follow_ups(seq, t3, t4);
  }

  void refuse_duplicate_and_superseded_follow_ups(
      uint16_t seq, uint64_t t3, uint64_t t4) {
    // (vi) a duplicate Follow_Up: the pairing was consumed, one per Resp
    rfu(seq, PEER_CID, t3 + 2000, t4 + 1500);
    unmoved("duplicate Follow_Up");
    // (vii) a Follow_Up for a superseded request: its Resp did arrive,
    // but the next request owns the pairing now, so it must not compute
    // against the new request's t1
    tx_seen = txf.size();
    std::vector<uint8_t> rq2 = wait_tx(0x2, 4000000);
    expect("7b: a second request", !rq2.empty(), 1);
    uint16_t seq2 = rq2.empty() ? 0 : fld16(rq2, 44);
    size_t rq2i = tx_seen - 1;
    for (int k = 0; k < 400 && txns[rq2i] == 0; k++) tick();
    uint64_t t1b = txns[rq2i];
    uint64_t t2b = peer_ns(t1b + 300), t3b = t2b + 20000, t4b = t1b + 21200;
    resp(seq2, PEER_CID, t2b, t4b);               // and no Follow_Up
    tx_seen = txf.size();
    std::vector<uint8_t> rq3 = wait_tx(0x2, 4000000);
    expect("7b: a third request", !rq3.empty(), 1);
    uint16_t seq3 = rq3.empty() ? 0 : fld16(rq3, 44);
    size_t rq3i = tx_seen - 1;
    for (int k = 0; k < 400 && txns[rq3i] == 0; k++) tick();
    uint64_t t1c = txns[rq3i];
    uint64_t t2c = peer_ns(t1c + 300), t3c = t2c + 20000, t4c = t1c + 21200;
    rfu(seq2, PEER_CID, t3b, t4c + 1000);
    unmoved("Follow_Up for a superseded request");
    resp(seq3, PEER_CID, t2c, t4c);
    rfu(seq3, PEER_CID, t3c, t4c + 1100);
    model_exchange(t1c, t2c, t3c, t4c);
    expect("the next exchange computes", dut->pub_pdelay_ns_o,
           static_cast<uint32_t>(pdm.d));
    expect("still capable after the probes",
           dut->pub_flags_o & FL_ASCAP, FL_ASCAP);
    pd_seen = txf.size();                  // the peer answers fresh ones only
    pd_mode = PD_NORMAL;
  }

  // ---- 7c: the Pdelay flag bits a receiver must ignore ------------------
  // 802.1AS-2011 Table 11-4 makes Pdelay_Resp's twoStepFlag "reserved as
  // TRUE, ignored on reception", and 11.4.1 makes every reserved field
  // "transmitted with all bits of the field 0 and ignored by the receiver".
  // So an otherwise qualifying exchange must reach the SAME verdict
  // whatever those bits carry: the 0x0208 shape a peer was captured
  // transmitting, and the shape with twoStepFlag cleared, must compute the
  // same delay as the conformant 0x0200/0x0000 pair (#64).
  //
  // Each variant answers a FRESH request, because a completed exchange
  // cannot complete twice (Figure 11-8 as corrected by Cor2), and each is
  // graded against the independent model rather than against the previous
  // variant's published value.
  //
  // Every variant also carries its OWN turnaround residency, so the delay
  // it should publish is ~200 ns from the one standing before it -- phase
  // 7b's +600 included, which is why the ladder starts at +500 -- and all
  // of them sit inside the Milan window that keeps asCapable up. Without
  // that a dropped variant would leave a stale delay the model happened to
  // predict anyway: three exchanges of identical shape compute the same
  // value, and the check would have passed on a receiver that refused the
  // frame outright. That was measured, not assumed: with one residency for
  // all three, the reserved-bit parser mutant in this lane's evidence
  // satisfied the delay check anyway and was caught by the drop counter
  // alone; against the ladder it fails the delay check by its own name as
  // well. The ladder is not left to inspection either: each
  // variant first asserts that its own prediction differs from the value
  // already published, so an edit that flattens it fails here by name
  // instead of quietly weakening the check behind it.
  //
  // The controls afterwards carry the reserved bit too. Tolerating an
  // ignored bit must not have become a blanket acceptance, so a malformed
  // response, a response at a neighbour's requesting clockIdentity and a
  // Follow_Up at a foreign requesting portNumber are all still refused
  // while carrying it, and the correct pair behind them still computes.
  void pair_a_pdelay_exchange_whose_flag_bits_are_ignored() {
    struct Variant {
      const char *tag;
      uint16_t resp;
      uint16_t rfu;
      uint64_t resid;            // D is about (t4 - t1 - resid) / 2
    };
    const Variant variants[] = {
      {"pdelay flags 0200/0000", 0x0200, 0x0000, 20200},  // conformant, ~500
      {"pdelay flags 0208/0008", 0x0208, 0x0008, 20600},  // captured, ~300
      {"pdelay flags 0000/0200", 0x0000, 0x0200, 21000},  // flipped, ~100
    };
    pd_mode = PD_SKIP;
    int computed = 0;
    uint32_t previous = dut->pub_pdelay_ns_o;
    for (const Variant &v : variants) {
      char n[96];
      tx_seen = txf.size();
      std::vector<uint8_t> rq = wait_tx(0x2, 4000000);
      snprintf(n, sizeof n, "%s: a request to answer", v.tag);
      expect(n, rq.empty() ? 0 : 1, 1);
      if (rq.empty()) continue;
      const uint16_t seq = fld16(rq, 44);
      const size_t rqi = tx_seen - 1;
      for (int k = 0; k < 400 && txns[rqi] == 0; k++) tick();
      const uint64_t t1 = txns[rqi];
      const uint64_t t2 = peer_ns(t1 + 300);
      const uint64_t t3 = t2 + v.resid;
      const uint64_t t4 = t1 + 21200;
      const uint16_t drops = dut->dbg_rx_drop_o;
      resp(seq, PEER_CID, t2, t4, OUR_PN, OUR_CID, v.resp);
      rfu(seq, PEER_CID, t3, t4 + 1000, OUR_PN, OUR_CID, v.rfu);
      model_exchange(t1, t2, t3, t4);
      // the guard on the check below, and it grades the BENCH: an
      // expectation equal to the delay already published would be met by a
      // frame that never arrived, so each variant must predict one of its
      // own before its published value is allowed to satisfy anything
      snprintf(n, sizeof n, "%s: a delay of its own", v.tag);
      expect(n, static_cast<uint32_t>(pdm.d) != previous, 1);
      snprintf(n, sizeof n, "%s: the exchange computes", v.tag);
      expect(n, dut->pub_pdelay_ns_o, static_cast<uint32_t>(pdm.d));
      previous = dut->pub_pdelay_ns_o;
      snprintf(n, sizeof n, "%s: not a parser drop", v.tag);
      expect(n, dut->dbg_rx_drop_o, drops);
      snprintf(n, sizeof n, "%s: keeps capable", v.tag);
      expect(n, dut->pub_flags_o & FL_ASCAP, FL_ASCAP);
      computed++;
    }
    expect("every ignored-flag pdelay variant ran", computed, 3);
    refuse_bad_pdelay_frames_carrying_the_reserved_bit();
  }

  void refuse_bad_pdelay_frames_carrying_the_reserved_bit() {
    tx_seen = txf.size();
    std::vector<uint8_t> rq = wait_tx(0x2, 4000000);
    expect("7c: a request for the controls", rq.empty() ? 0 : 1, 1);
    if (rq.empty()) { pd_seen = txf.size(); pd_mode = PD_NORMAL; return; }
    const uint16_t seq = fld16(rq, 44);
    const size_t rqi = tx_seen - 1;
    for (int k = 0; k < 400 && txns[rqi] == 0; k++) tick();
    const uint64_t t1 = txns[rqi];
    const uint64_t t2 = peer_ns(t1 + 300);
    const uint64_t t3 = t2 + 20000;
    const uint64_t t4 = t1 + 21200;
    pd0 = dut->pub_pdelay_ns_o;
    fl0 = dut->pub_flags_o;

    // (a) malformed: a 54-octet Pdelay_Resp declared and cut at 53, with
    // the reserved bit set. The parser refuses the frame and counts it
    const uint16_t drops = dut->dbg_rx_drop_o;
    Frame cut = ptp(0x3, seq, 0, 0x0208, 20, PEER_CID);
    cut.ts(t2); cut.u64(OUR_CID); cut.u16(OUR_PN);
    cut.b.resize(67);
    send_frame(cut.b, t4);
    run(2000);
    expect("reserved-bit cut Resp: dropped and counted", dut->dbg_rx_drop_o,
           static_cast<uint16_t>(drops + 1));
    unmoved("reserved-bit cut Resp");

    // (b) wrong identity: every other gate admits it, and NEAR_CID shares
    // OUR_CID's low half, so a compare narrowed to that half takes it
    resp(seq, PEER_CID, t2, t4, OUR_PN, NEAR_CID, 0x0208);
    rfu(seq, PEER_CID, t3, t4 + 1000, OUR_PN, OUR_CID, 0x0008);
    unmoved("reserved-bit Resp at a neighbour's identity");

    // (c) the legitimate response arms the pairing; a Follow_Up addressed
    // to another port of this clock is still not its partner
    resp(seq, PEER_CID, t2, t4, OUR_PN, OUR_CID, 0x0208);
    rfu(seq, PEER_CID, t3, t4 + 1100, FOREIGN_PN, OUR_CID, 0x0008);
    unmoved("reserved-bit Follow_Up at a foreign port");

    // (d) the pair that is wrong in nothing but those ignored bits still
    // computes, so none of the refusals above passed vacuously
    rfu(seq, PEER_CID, t3, t4 + 1200, OUR_PN, OUR_CID, 0x0008);
    model_exchange(t1, t2, t3, t4);
    expect("reserved-bit pair still computes", dut->pub_pdelay_ns_o,
           static_cast<uint32_t>(pdm.d));
    expect("reserved-bit pair keeps capable", dut->pub_flags_o & FL_ASCAP,
           FL_ASCAP);
    pd_seen = txf.size();                  // the peer answers fresh ones only
    pd_mode = PD_NORMAL;
  }

  // ---- 8: worse announce -> stay master ---------------------------------
  void stay_master_against_a_worse_announce() {
    {
      Frame f = ptp(0xB, 9, 0, 0x0008, 42);
      for (int i = 0; i < 10; i++) f.u8(0);
      f.u16(0xFFC4); f.u8(0);
      f.u8(250); f.u32(OUR_CQ); f.u8(248);
      f.u64(0xAABBCCFFFE010203ull);
      f.u16(0); f.u8(0xA0);
      f.u16(0x0008); f.u16(8); f.u64(0xAABBCCFFFE010203ull);
      send_frame(f.b, 5000000);
      run_svc(6000);
    }
    expect("still master", dut->pub_flags_o & FL_AMGM, FL_AMGM);
    expect("gm still us", dut->pub_gm_id_o, OUR_CID);
    ANNQ8 =
        (0xFFC4ull << 48) | (250ull << 40)
        | (static_cast<uint64_t>(OUR_CQ) << 8) | 248ull;
    expect("annq published", dut->pub_annq_o, ANNQ8);
  }

  // ---- 8b: a BETTER announce in a foreign domain cannot move the GM ----
  // 802.1AS-2011 8.1: the gPTP domain number is 0; IEEE 1588-2008 9.5.1:
  // only messages whose domainNumber matches are accepted for processing.
  // priority1 1 wins BTCA outright in domain 0; in domain 5 it must never
  // reach the announce handler, whose FIRST act is publishing the raw
  // vector -- so pub_annq_o still holding phase 8's vector proves the
  // frame was refused before any state moved (FPGA-gPTP #6)
  void refuse_a_better_announce_in_a_foreign_domain() {
    uint16_t drops = dut->dbg_rx_drop_o;
    uint32_t flags = dut->pub_flags_o;
    Frame f = ptp(0xB, 11, 0, 0x0008, 30, 0x00A5A5FFFE000005ull);
    f.b[18] = 5;                                 // domainNumber, byte 4
    for (int i = 0; i < 10; i++) f.u8(0);
    f.u16(0xFFC4); f.u8(0);
    f.u8(1); f.u32(OUR_CQ); f.u8(248);
    f.u64(0x0000000000005555ull);
    f.u16(0); f.u8(0xA0);
    send_frame(f.b, 5500000);
    run_svc(6000);
    expect("foreign-domain announce: still master",
           dut->pub_flags_o & FL_AMGM, FL_AMGM);
    expect("foreign-domain announce: gm still us", dut->pub_gm_id_o, OUR_CID);
    expect("foreign-domain announce: parent still us", dut->pub_parent_id_o,
           OUR_CID);
    expect("foreign-domain announce: flags untouched", dut->pub_flags_o,
           flags);
    expect("foreign-domain announce: raw vector never published",
           dut->pub_annq_o, ANNQ8);
    expect("foreign-domain announce: dropped and counted",
           dut->dbg_rx_drop_o, static_cast<uint16_t>(drops + 1));
  }

  //! `parent_canary` false drops the parent check alone: an own-source probe
  //! names thisClock as its source, so even an admitted frame would leave
  //! thisClock the published parent, and no defect could fail that check.
  void refuse_probe(const char *tag, uint16_t seq, uint64_t gm,
                    uint16_t steps, uint64_t src,
                    const std::vector<uint64_t> &path, uint64_t rx,
                    bool parent_canary = true) {
    uint32_t flags0 = dut->pub_flags_o;
    uint64_t annq0 = dut->pub_annq_o;
    uint16_t drops0 = dut->dbg_rx_drop_o;
    send_announce(seq, 1, gm, steps, src, path, rx);
    char n[96];
    snprintf(n, 96, "%s: still master", tag);
    expect(n, dut->pub_flags_o & FL_AMGM, FL_AMGM);
    snprintf(n, 96, "%s: gm still us", tag);
    expect(n, dut->pub_gm_id_o, OUR_CID);
    if (parent_canary) {
      snprintf(n, 96, "%s: parent still us", tag);
      expect(n, dut->pub_parent_id_o, OUR_CID);
    }
    snprintf(n, 96, "%s: flags untouched", tag);
    expect(n, dut->pub_flags_o, flags0);
    snprintf(n, 96, "%s: raw vector never published", tag);
    expect(n, dut->pub_annq_o, annq0);
    snprintf(n, 96, "%s: parser-drop policy", tag);
    expect(n, dut->dbg_rx_drop_o, drops0);
  }

  // an adopt-control: a priority1-1 announce that MUST be adopted, then
  // the same announcer degrades below us, a parent update our own
  // vector then wins (10.3.5), and mastership returns at once. Each control
  // starts from mastership, so a TLV-less one keeps {thisClock} (#87)
  void adopt_control(const char *tag, uint16_t seq, uint64_t gm,
                     uint16_t steps, uint64_t src,
                     const std::vector<uint64_t> &path, uint64_t rx) {
    char n[96];
    const uint16_t drops0 = dut->dbg_rx_drop_o;
    send_announce(seq, 1, gm, steps, src, path, rx);
    snprintf(n, 96, "%s: adopted", tag);
    expect(n, dut->pub_gm_id_o, gm);
    snprintf(n, 96, "%s: announcer is the parent", tag);
    expect(n, dut->pub_parent_id_o, src);
    snprintf(n, 96, "%s: no longer master", tag);
    expect(n, dut->pub_flags_o & FL_AMGM, 0);
    const std::vector<uint64_t> served =
        path.empty() ? std::vector<uint64_t>{OUR_CID} : path_trace_of(path);
    snprintf(n, 96, "%s: raw path count", tag);
    expect(n, dut->pub_path_count_o, served.size());
    snprintf(n, 96, "%s: raw path head", tag);
    expect(n, pub_path_head(), served[0]);
    for (unsigned k = 0; k < PATH_TAIL_SLOTS; k++) {
      const uint64_t want = (k + 1 < served.size()) ? served[k + 1] : 0;
      snprintf(n, 96, "%s: raw path tail %u", tag, k + 1);
      expect(n, pub_path_tail(k), want);
    }
    snprintf(n, 96, "%s: parser accepts", tag);
    expect(n, dut->dbg_rx_drop_o, drops0);
    send_announce(static_cast<uint16_t>(seq + 1), 250, gm, steps, src, path,
                  rx + 100000);
    snprintf(n, 96, "%s: degraded parent yields", tag);
    expect(n, dut->pub_flags_o & 3, FL_PRESENT | FL_AMGM);
    snprintf(n, 96, "%s: gm is us again", tag);
    expect(n, dut->pub_gm_id_o, OUR_CID);
    snprintf(n, 96, "%s: degraded frame parser accepts", tag);
    expect(n, dut->dbg_rx_drop_o, drops0);
  }
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
