Mister-M-alt/FPGA-gPTP/(commit log)

2026-08-14 ucode v2 speaks 802.1AS on the wire: two-step Pdelay both roles, announce adopt, sync offset - 49-check engine round-trip green, LUTRAM power-on zero becomes the init contract
2026-08-14 First light on the Arty: the plane exchanges live 802.1AS with an STM32 - both Pdelay roles accepted, announce adopted, 675ns link delay re-measured every second, zero CRC errors either way
    [arty.xdc, bench_afifo.sv, bench_arty_top.sv, bench_mii_rx.sv, bench_mii_tx.sv, bench_phc.sv, bench_uart_report.sv]
2026-08-14 The grandmaster round: BTCA, PortAnnounceTransmit with path trace, two-step Sync+FU as master - and the 78-check suite catches a real dispatch race that ate adjacent events
2026-08-14 Bench grandmaster verdict: bilateral BMCA interop with the STM32 - it yields to our p1=100 and stops announcing, we transmit the full GM set at 20 frames/s, and the whole capability priced at +51 LUT
2026-08-18 ucode v5: the PHC servo lands, observe-only retires
2026-08-18 Answer review: the step carries its estimate, clamp pinned
2026-08-19 Answer review: the cease survives reset, the record baselines
    [KL_gptp_engine.sv, sim_main.cpp]
2026-08-22 Drop foreign-domain frames at the parser header: domainNumber must be 0 (8.1)
2026-08-22 Refuse a Pdelay_Req shorter than its 54 octets: the header alone no longer draws a response (11.4.5)
    [KL_gptp_rx_parser.sv, sim_main.cpp]
2026-08-22 Qualify Announce per 10.3.10.2.1: own source, stepsRemoved 255 and path-trace loop refused ahead of BTCA
2026-08-22 Answer review: first-hop loop probes, half-identity adopt-controls, stepsRemoved 0x0100 and 0xFFFF, five more planted mutations
2026-08-22 Answer review: the campaign grades all six TX types and found #6 through #10; #8 in review as #21; the pin dated
2026-08-22 Parent pin at 5c330fc8 on dev 4ec73a15: #139 done through PR #208
2026-08-22 Answer review: derive both half-identity fixtures from OUR_CID, correct the narrowing and Table 17 reasoning, resolve the prose count
    [sim_main.cpp]
2026-08-23 Count every refused frame: one write site for the two refusals that can land on one edge
2026-08-23 Answer review: re-measured ledger figures, the two sweep reasons that actually hold, and the two uncovered corners
2026-08-24 fix: preserve gPTP egress ownership across stalls and resets
    [KL_gptp_engine.sv, sim_main.cpp]
2026-08-24 fix: preserve queued Pdelay request context
    [KL_gptp_engine.sv, sim_main.cpp]
2026-08-25 Compare the whole requestingPortIdentity on both Pdelay receive paths, and pin both directions of the gate
2026-09-01 Lay the architecture diagram out along its dataflow
    The old geometry fought the story: the spine jumped up-right into
    Message storage, doubled back for Event arbitration, and the state
    regions sprayed edges in four directions while the red timestamp
    return climbed across the TX column. Same thirteen nodes, same
    fifteen edges, same texts, colours and evidence note - only geometry
    moved. The causal row now reads parser -> Event arbitration ->
    KL_gptp_ucpu -> KL_gptp_tx_slot with the parent RX/TX faces on the
    outer edges; storage, timer and state regions sit directly under
    their users with short vertical hops; publication and the PHC knobs
    each get one straight lane; the timestamp return takes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
2026-09-01 Carry the full 7-bit TX FIFO level into the MII gasket, pinned by the returning 81-check gasket suite
    The redeveloped bench_mii_tx took a [5:0] level from a 64-deep FIFO
    whose rlevel_o is [6:0] with the all-full MSB, so a FIFO parked at
    exactly 64 read as level 0 while not empty, the >=8 start gate never
    passed, and TX wedged in S_IDLE forever - the exact failure the
    prototype caught live on the wire and fixed, re-lost in the rewrite
    (issue #54). The tag test masked the case by capping its driven level
    at 63; it now drives the full width. The prototype's gasket loopback
    suite returns adapted to the tag-extraction ports: size sweep 60..128,
    20 back-to-back frames with the IFG floor, the FCS-c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
    [bench_arty_top.sv, bench_mii_tx.sv, bench_mii_tx_tag_test.cpp, gasket_tb_top.sv, sim_main.cpp]
2026-09-01 The independent judge returns: tb/tsngen adapted to the two-bank engine
    Frames the engine transmits are decoded, and every stimulus frame
    generated, by tsn-gen's packet_gen from the 802.1AS YAMLs - an
    independent implementation of the bit layout judging both wire faces.
    Ported from the prototype line and adapted: the egress-stamp return
    carries {messageType, sequenceId} read from the transmitted frame (the
    engine claims stamps by both since #32/#37); phc_ns_i, cfg_asym_i and
    the asinfo publish are gone with their ports; the ROM is generated
    with --clk-hz matching the simulated clock as the engine suite does;
    PUB reports the drop counters. The scenario meets the hardened parser
    and ucode wher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
2026-09-01 pcap_verdict returns, and make runs the whole verification layer
    bench/pcap_verdict.py judges a TAP capture with the same tsn-gen pins
    as tb/tsngen - the wire-truth tool the prototype line used for its
    hardware record - and the root Makefile now runs the gasket suite and
    the tsngen cross-check with the rest of the bar.
2026-09-01 Answer the review round: no equipment brands, no dead doc reference
    The ported files reintroduced measurement-equipment and peer-board
    brand names the current tree deliberately carries nowhere, and the
    gasket testbench banner cited a prototype document this tree does not
    have. The TAP and the reference embedded peer are now named by role,
    and the banner cites issue #54, which carries the wedge's history.
    [gasket_tb_top.sv, sim_main.cpp]
2026-09-01 The sync-source comment names the real gate: Follow_Up pairs with its pending Sync by sequenceId and sourcePortIdentity (11.2.14), not by a parent-only filter
2026-09-01 Archive the prototype line's documentation under docs/history/v1/prototype
    Ten pages from tag prototype-line - the design book, the FSM
    conformance audit, the verification and management records, the
    integration guide, resource validation, and the three bench
    narratives with the measured lock record - enter the archive with
    their fifteen rendered diagrams beside them. Each page carries the
    obsolete banner and metadata block, the index gains a prototype
    section, and the total moves 7 to 17. Editorial passes, content
    otherwise verbatim: deny-list vocabulary and equipment or host names
    replaced by role names, capture-host setup genericized, local links
    flattened to code text (the trees they poi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
2026-09-01 Draw the four RTL seams the architecture diagram abstracted away
    The #52 conformance audit named four block-level simplifications; all
    four are now drawn, reusing that round's lanes so no two edges cross.
    The ingress timestamp takes its own blue path from the parent RX
    service into Message storage, where the engine-level latch commits it
    - it never passes through the parser. The serializer-idle dispatch
    gate runs as a dashed green lane from KL_gptp_tx_slot back over the
    spine into Event arbitration. The state-timer arm and the uCPU build
    lane gain their return heads (the ms tick gather and the rb_ready
    handshake), matching the two return handshakes already drawn double
    headed. The timestamp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
2026-09-03 Arm the gasket and tsngen suites with mutation campaigns
2026-09-23 Step over 20 us at link-up and over 100 us once locked, and clamp the whole trim to 200 ppm (#68)
2026-09-23 Re-arm the link-up threshold only on an asCapable rise, so a Sync lapse or mastership stays locked (#68)
2026-09-24 Pin inactive slew lifecycle checks and refresh source evidence
2026-09-24 Pin inactive asCapable loss and recovery in slew checks
2026-10-09 Preserve peer delay and asCapable across servo phase steps
2026-10-10 Keep the timer's deadlines in distributed RAM, read by the sweep as before
2026-10-10 Record the engine's measured snapshot with the timer deadlines in distributed RAM
2026-10-10 Give each OOC clock rule a selftest arm that only it catches
2026-10-10 State the unconstrained OOC flow on each archived page that quotes OOC figures
2026-10-11 Record constrained and unconstrained OOC figures side by side with their flow
2026-10-11 Latch rx_err_i on any byte of a frame into the parser's drop state
2026-10-11 Prove no word a refused frame leaves reaches the next accepted frame's event
2026-10-18 Split the engine suite's phase list and mutation arm under the parent's function-length ratchets
2026-10-19 State the current ROM budget as 1,015 of 1,024 words with nine free
2026-10-27 Plant a failing mutant for every new receipt-rule check and keep the lost-arm mutants word-neutral
2026-10-27 State the request leg's 56-word size after the branch-free loss count
2026-10-27 Keep the engine mutation arm under the module length ratchet
2026-10-27 Publish pathTrace from its received head and keep it without a path trace TLV (#87, #88)
2026-10-27 Keep the engine mutation arm under the module length limit and reuse the parser arm's PathTrace edits (#88)
2026-10-27 Repair the receipt-timeout controls for the new leg and plant a failing control for each new check
2026-10-28 Restore the space in the parser arm's PAIRS assignment (#88)
2026-10-29 Check the toggle exit, the link loss, a frame built across the fall and the unchanged countdown, each with planted controls (#94)
2026-10-29 Document the port-enable contract, its gates and the NOT_ENABLED leg (#94)
2026-10-29 Withdraw a frame not yet started while the port is disabled, and dispatch NOT_ENABLED ahead of a stalled byte face (#94)
2026-10-29 Take the first portEnabled sample after reset as the reference, so a rise after a disabled release ends a retained cease (#94)
2026-10-29 Check a stalled byte face, an exchange across the fall and a disabled warm reset, each with planted controls (#94)
2026-10-29 Document the frame withdrawal, the NOT_ENABLED dispatch, the disarm and the reference sample (#94)
2026-10-29 Describe the stall, exchange and reset controls by what they plant (#94)
2026-10-30 Link each value-bearing section to the protocol constants table (#96)
2026-10-30 State that publication outputs are sampled on pub_commit_o and can change while microcode stages them (#96)
2026-10-30 Fail the docs gate when a current page restates a unit-bearing protocol constant (#96)
2026-10-30 Make each constants and ROM self-test arm isolate the rule it names (#96)
2026-10-30 Add a self-test arm that plants a duplicate constants row and expects its named finding (#96)
2026-10-30 Pass decimal minutes, larger number words and tilde fences, and catch unspaced minutes and comma-less unit cells, each with a self-test arm (#96)
2026-11-01 Follow CommonMark 4.5 for fences in one scanner and neutralise inline markup before the copy rule, each reviewed plant a self-test arm (#96)
2026-11-01 Record the fence after a lazy list line as an expected-failure self-test arm (#96)
2026-11-04 Walk the Follow_Up TLV chain to the information TLV within messageLength and refuse a malformed chain (#98)
2026-11-05 Count the seven #87 and #88 parser mutants in the arm's docstring (#98)
2026-11-10 Run the engine mutation arm's mutants concurrently, --jobs N at once, printed in list order (#102)
2026-11-10 Compare the engine mutation arm's --jobs 1 and --jobs 4 output byte for byte (#102)
2026-11-12 Annotate and document the engine mutation arm's public functions and move its path controls to path_mutants.py, under 1,000 lines (#104)
2026-11-12 Compare the engine arm's output at --jobs 1 and 8 with ccache off, cold and warm byte for byte, and check its verdict order inside make all (#104)
2026-11-12 Document the engine builds' ccache, its OBJCACHE= switch and the two order tests in the test guide (#104)
